sonatine726/MizuniGoal_PowerController_Docs/2026-09-14.md

ホフマンさん、マーロンさん
会議で話題に挙がった「電源On/Offを示すLEDの電圧と配置」について確認しました。

現在の基板でスイッチに流れる電流が少ないことなどから、スイッチのコネクタに「LED付きスイッチ」を付ける配置は適さないことがわかりました。ですので「LED付きスイッチ」を使いたい場合は基板設計を見直しますが、今回はスイッチを「緊急停止押しボタンスイッチ」に変更するということでしたので、全体最適の点では添付図の配置でLEDを付けてもらうほうが優れそうです。

Pros:
- LED選択の自由度が増す(LED専用の抵抗で調整できるため、基本的にどのようなLEDでも使える)
- 配線の自由度が増す（スイッチ配線とLED配線が別になるため、それぞれ最適化できる）
Cons:
- LED付きスイッチをどうしても使いたい場合は、この案は採用できない

ご検討ください。スイッチが二つある（緊急停止押しボタンスイッチ＋LED付きスイッチ）とわかりにくいので、私が誤解していて、元々LED付きスイッチでは無くLEDを使うという話かもしれません。そうでは無く、どうしてもLED付きスイッチを使いたい場合は、基板設計を見直しますので言ってください。

※いずれの案でも、LEDに掛かる電圧は「バッテリーと同様（約21.0V 〜 29.4V）」になります。
※出力線を分岐させてLEDを付けることは、XT60コネクタであれば分岐コネクタが市販されていますので容易と予想しています。ただ困難な場合は、基板上にもう一つLED用コネクタを追加しても良いかもしれません。そのような基板改良が望ましい場合も言ってください。

[English]
Hoffman-san, Marlon-san

I have looked into the matter raised during the meeting regarding the voltage and placement of the power status LED.

Given factors such as the low current flowing through the switch on the current PCB, using a "switch with an integrated LED" connected to the switch port is not ideal. While we could revise the PCB design if an integrated LED switch were required, the plan is to switch to an "emergency stop pushbutton." Therefore, from an overall optimization standpoint, it seems better to install the LED using the layout shown in the attached diagram.

Pros:
- Greater flexibility in LED selection (since a dedicated resistor can be used, virtually any LED is compatible).
- Greater flexibility in wiring (switch wiring and LED wiring are separate, allowing for individual optimization).
Cons:
- This approach cannot be used if an integrated LED switch is strictly required.

Please consider this option. It can be confusing to have two switches (an emergency stop pushbutton *and* a switch with an integrated LED); I may have misunderstood the situation, and the original plan might have been to use a separate LED rather than an integrated LED switch. If that is not the case and you absolutely require a switch with an integrated LED, please let me know so we can revise the PCB design.

*Note: In either scenario, the voltage applied to the LED will be the same as the battery voltage (approx. 21.0V to 29.4V).
*Note: Regarding the LED connection, branching the output line should be easy since splitter connectors for XT60s are commercially available. However, if this proves difficult, we could add a dedicated LED connector to the PCB. Please let me know if such a PCB modification is preferred.
