sonatine726/MizuniGoal_PowerController_Docs/Harness.md

# ツイストペアケーブルの長さ

40cmケーブルで作って32cmのツイストペアケーブル ができた

# ケーブル候補

https://www.marutsu.co.jp/pc/i/1349511/

https://akizukidenshi.com/catalog/g/g106756/

https://akizukidenshi.com/catalog/g/g118293/

https://www.monotaro.com/p/3331/9363/

# 前方ケーブル

5V&GND AWG24 20cm ツイストペア
Current&Voltage AWG 26 リボンケーブル  16cm
