sonatine726/MizuniGoal_PowerController_Docs/2026-09-15.md

会議で話が挙がった「運搬中のミズニゴールの揺れを計測する方法」について調べました。
まずは「①Pixhawkの加速度センサーの値から計測」を試してみて、こちらがうまくいかなかったり精度が十分でない場合、②振動センサーを追加して計測」を試してみるのが良さそうでした。

①が実際にできそうか、私の持っているPixhawkを使って実験してみますね。

[運搬中のミズニゴールの揺れを計測する方法]

①Pixhawkの加速度センサーの値から計測
DISARM状態でもセンサーログを残すようにArdupilotの設定を変更することで、可能なようです。設定はこれを含め、次のような変更が必要になりそうです。
- DISARM状態でもセンサーログを残す(LOG_DISARMED を 1)
- IMUの生ログを残す(INS_LOG_BAT_MASK=0、LOG_BITMASK の bit 19（raw IMU）=1)
	- ※生ログはデータ量が多くなります。精度を落としてもログを削減したい場合は、IMU バッチサンプラ（INS_LOG_BAT_OPT=4 (1kHz サンプリング)、INS_LOG_BAT_MASK=1(1つ目の IMU からデータ収集）も使えるようです。

※この方法の欠点として、「Pixhawk6C mini は基板内に防振機構を持っているため、揺れはシャーシよりも低い値が計測される」があるようです。ただ今回の揺れは軽トラの荷台ということで大きいはずですし、改善度合いを測るといった相対的な計測には問題無いですので、影響は小さいかもしれません。

②振動センサーを追加して計測

次のような振動センサーが市販されていました。

https://ymatic.co.jp/product/accstick6/
https://amzn.asia/d/0dULUasw
https://www.murata.com/ja-jp/products/sensor/vibration

ただ多くが加速度の変化から振動を測る方式でしたので、やっていることは①と同じになりそうです。まずは①を実施、うまくいかなかったり十分な精度が出ない場合にこちらの②を検討する進め方で良さそうです。

※「計測した振動と、それによってミズニゴールが受ける衝撃力が比例しないかも」という話も会議で挙がっていました。これについては正確にはまだわかりませんが、運動方程式の「F(力) = m(質量)xa(加速度)」の関係を考慮すると、①や②で得られる加速度のデータを使えば、衝撃力も推定できるかもしれません。これを直接測る場合は、ミズニゴールと軽トラ台車の接点に衝撃センサーを設置する形になるかもしれませんが、精度は不明で、また横方向の力は検知できません。
ーーーーー

[English]
I looked into the methods discussed at the meeting for measuring the vibration of the "Mizunigor" unit during transport.
It seems best to first try "① Measuring using the Pixhawk's accelerometer data," and then—if that proves unsuccessful or lacks sufficient accuracy—proceed to "② Measuring by adding a vibration sensor."

I will conduct an experiment using the Pixhawk I have on hand to see if method ① is feasible.

[Methods for measuring Mizunigor vibration during transport]

① Measuring using the Pixhawk's accelerometer data
This appears to be possible by modifying the ArduPilot settings to ensure sensor logs are recorded even when the system is disarmed. The following configuration changes, including that one, will likely be required:
- Record sensor logs even when disarmed (set LOG_DISARMED to 1)
- Record raw IMU logs (set INS_LOG_BAT_MASK=0; set bit 19 [raw IMU] of LOG_BITMASK to 1)
- *Note: Raw logs result in a large volume of data. If you want to reduce log size even at the cost of some precision, it appears you can use the IMU batch sampler (settings: `INS_LOG_BAT_OPT=4` for 1kHz sampling, `INS_LOG_BAT_MASK=1` to collect data from the first IMU).

*Note: A potential drawback of this method is that the Pixhawk 6C mini has an internal vibration-dampening mechanism, meaning the measured vibration levels will be lower than those experienced by the chassis itself. However, since the vibrations in this scenario—occurring on the bed of a light truck—are likely significant, and the goal is relative measurement (such as gauging the degree of improvement), the impact of this dampening may be negligible.*

② Measurement using an additional vibration sensor

Commercially available vibration sensors include the following:

https://ymatic.co.jp/product/accstick6/
https://amzn.asia/d/0dULUasw
https://www.murata.com/ja-jp/products/sensor/vibration

However, since most of these measure vibration based on changes in acceleration, the underlying principle is essentially the same as in method ①. It would be best to start with method ① and consider method ② only if the initial approach fails or does not yield sufficient precision.

*Note: A point raised during the meeting was that the measured vibration might not be directly proportional to the impact force experienced by the "Mizunigol." While the exact relationship remains unclear, considering the equation of motion "F (force) = m (mass) × a (acceleration)," it may be possible to estimate the impact force using the acceleration data obtained via methods ① or ②. Directly measuring the impact force would likely require installing an impact sensor at the contact point between the Mizunigol and the light truck bed; however, the accuracy of such a setup is unknown, and it would not detect lateral forces.*
ーーーーー

ピン数は５。次の役割となる
- COM
- NC
- NO
- LED+
- LED-

教えていただいたLED付き押ボタンスイッチと、現在の電源基板との関係を調査しました。

現在の電源基板でも使用できる。スイッチのピンと電源基板との接続は次の図の通り。
対象スイッチはAliexpressのページに48V対応と出ているため、追加の抵抗は不要で、配線接続だけで動くと思われる。

次バージョンの電源基板での改良

上記のように現基板でも使えるが、スイッチの4ピンの配線を異なる２つのコネクタに繋ぐ必要があり、配線が複雑化したり製造性が悪くなったりする。この点は次の図のようにJ4コネクタを2pinから4pinに変更することで、スイッチの4ピンを全てJ4コネクタに繋げるようになり、改善する。次バージョンの電源基板でこの改良を行う。
