sonatine726/MizuniGoal_PowerController_Docs/Memo.md

x:-23.15
y:40.2

x:-22.69
y:29:66

39
43

86

1
1

-0.3

0.9
0.3

0.2
-1

C15、C16は調整用でDNP。C15を使う場合は(C0G/100V)のコンデンサが必要

# 部品

22nF / 100V / C0G / 0603（C9）
LCSCに無し。1206/1210ならある

637-ES2C
LCSCに無し。代替品は

# はんだ付け

## Sn63Pb37
[https://mou.sr/4yajA03](https://mou.sr/4yajA03)

[https://mou.sr/3Uo14CN](https://mou.sr/3Uo14CN)

[https://mou.sr/4wZxC3D](https://mou.sr/4wZxC3D)

[https://www.hozan.co.jp/corp/g/g3728/](https://www.hozan.co.jp/corp/g/g3728/)

[https://www.goot.jp/products/detail/cp_15y](https://www.goot.jp/products/detail/cp_15y)

クリームはんだ：Sn63Pb37、Type 3 、無洗浄、100g 以下 → [https://mou.sr/4yajA03](https://mou.sr/4yajA03)

ワイヤーはんだ：Sn63Pb37、0.3mm（IC3 用） →

ワイヤーはんだ：Sn63Pb37、0.8〜1.0mm（コネクタ用） フラックス：ロジン系ペンまたはジェル はんだ吸取線：1.5〜2mm 幅

## SAC305
https://www.ifixit.com/products/lead-free-solder-paste-amtech-lf4300-sac305-t3-88-5

クリームはんだ：SAC305、Type 3、無洗浄、シリンジ 10〜35g
https://ja.aliexpress.com/item/1005009757132400.html
https://ja.aliexpress.com/item/1005013051346248.html

https://www.monotaro.com/p/0439/8216/

ワイヤーはんだ：SAC305、0.3mm（IC3 用）
https://ja.aliexpress.com/item/1005010509165339.html
https://www.monotaro.com/p/3512/1746/

ワイヤーはんだ：SAC305、0.8〜1.0mm（コネクタ用）
https://ja.aliexpress.com/item/1005012785466170.html
https://www.monotaro.com/p/3512/1764/

フラックス：ロジン系ジェルまたはペン（多めに）
[https://www.hozan.co.jp/corp/g/g3728/](https://www.hozan.co.jp/corp/g/g3728/)

はんだ吸取線：1.5〜2mm 幅
[https://www.goot.jp/products/detail/cp_15y](https://www.goot.jp/products/detail/cp_15y)

# JLCPCB　PCBA料金

2 19587

3 20409

4 21263

5 22127 (基板10枚 22,759)

10(36,748)

30(94,273)

# LED

18mA
