sonatine726/MizuniGoal_PowerController_Docs/MizuniGoal Power Controller v2.2.1 保護機能仕様.docx

# MizuniGoal Power Controller v2.2.1 保護機能仕様

Oct 21, 2026 · @久保田隆司

v2.2.1 の保護は 7 系統。しきい値のばらつきはすべて LM5060 自身のしきい値公差が支配しており、分圧抵抗（±1%）の寄与はその 1/6 程度にとどまる。UVLO 立ち上がりは設計 19.5V に対し 17.1〜21.9V、OVP 遮断は設計 34.0V に対し 31.1〜37.0V、OCP（VDS フォルト）は設計 50A 級に対し 34〜102A に散る。精度を要する保護は v2.2.1 には無い。

## 一覧

主保護は 7 系統。設計値は全部品が typ の場合、範囲はデータシートの min/max と抵抗 ±1%・コンデンサ ±10% を組み合わせた最悪値。

保護 | 検出対象 | 設計値（typ） | 最悪範囲 | 復帰 | しきい値を決めているもの
UVLO 遮断 | VBUS | 19.5 V で ON<br>17.4 V で OFF | 17.1〜21.9 V<br>14.5〜20.5 V | 自動 | R2 200k / R3 5.76k / R4 13.3k → IC3.4
OVP 遮断 | VBUS | 34.0 V で OFF | 31.1〜37.0 V | 自動<br>30.1 V（27.3〜33.0） | 同じ分圧の下側タップ → IC3.3
OCP（VDS フォルト） | Q3 の Vds | 152 mV<br>約 50 A を 87 ms | 117〜184 mV<br>34〜102 A を 66〜124 ms | ラッチ<br>EN トグルで解除 | R1 10kΩ・R7 1kΩ・C6+C16・Q3 の Rds(on)
起動タイムアウト | 起動時間 | 160 ms | 123〜264 ms | ラッチ | C6 0.33µF + C16 0.15µF・I_TIMERL
TH1 サーマル遮断 | TH1 温度 | 選別後 94.3〜109.9 ℃<br>（VBUS 29.4 V） | 未選別 74.6〜124.4 ℃ | 自動<br>温度ヒステリシス約 6 ℃ | R9 10k + R5 3.0k / R6 100k ∥ TH1 → IC3.5
ブレーキチョッパ | Vout | 32.2 V で導通<br>30.8 V で復帰 | 31.5〜33.0 V<br>30.0〜31.7 V | 自動 | R17 118k / R18 10k / R14 1M・U1 TL431B
非常停止 | J4 接点（NC） | 押下で即 OFF | — | 手動（ひねり解除） | J4 が EN 経路を直接開く

補助保護（ヒューズ、PPTC、TVS、ゲートクランプ、逆流阻止）は後述。ラッチするのは OCP と起動タイムアウトの 2 つだけで、どちらも LM5060 の TIMER ピンが 2.0 V に達したときに発生する。

## UVLO（低電圧遮断）

設計 19.5 V で ON、17.4 V で OFF。最悪で 17.1〜21.9 V に散り、その幅 4.8 V のうち 4.1 V が LM5060 自身のしきい値公差による。

### 回路

VBUS → R2 200 kΩ → IC3.4（UVLO） → R3 5.76 kΩ → IC3.3（OVP） → R4 13.3 kΩ → GND。合計 219.06 kΩ、VBUS 29.4 V で 134 µA を消費する（待機電流の最大寄与）。

TI の 3 本分圧（Option A）だが、タップの割り付けがデータシートの図と逆で、UVLO が上側・OVP が下側になっている。UVLO は 19.5 V で 1.6 V（比 0.082）、OVP は 34.0 V で 2.0 V（比 0.059）を要求するためで、この配置でなければ両方を満たせない。

### LM5060 側の規格

記号 | 項目 | min | typ | max
UVLO_TH | しきい値（立ち上がり） | 1.45 V | 1.60 V | 1.75 V
UVLO_HYS | しきい値ヒステリシス | 120 mV | 180 mV | 230 mV
UVLO_BIAS | ピンの引き込み電流 | 3.8 µA | 5.5 µA | 7.2 µA

UVLO_BIAS はこの回路では無視できない。R2 200 kΩ に 5.5 µA が流れると 1.1 V のオフセットになり、これが間違うと設計値 19.5 V が 18.4 V になる。

### 算出式

V_{BUS(UVLO)} = V_{th}\cdot\frac{R_2+R_3+R_4}{R_3+R_4} + R_2\,I_{UVLO\_BIAS} = 11.493\,V_{th} + 1.10\ \mathrm{V}

立ち下がりは V_th を（V_th − UVLO_HYS）に置き換える。typ で 1.60 V → 19.49 V、1.42 V → 17.42 V、ヒステリシス 2.07 V。

### ばらつきの内訳

要因 | 立ち上がりの範囲 | 幅
LM5060 単独（抵抗は nominal） | 17.43〜21.55 V | 4.12 V
抵抗 ±1% 単独（IC は typ） | 19.15〜19.84 V | 0.69 V
全部合わせ | 17.12〜21.94 V | 4.82 V

抵抗を 0.1% にしても幅は 4.8 → 4.2 V にしかならない。このしきい値を絞りたい場合、抵抗の格上げは意味がない。

### 7S パックとしての意味

| VBUS | 1 セルあたり
立ち上がり typ | 19.5 V | 2.78 V
立ち上がり最悪（高） | 21.9 V | 3.13 V
立ち下がり typ | 17.4 V | 2.49 V
立ち下がり最悪（低） | 14.5 V | 2.07 V

両端とも実用上の問題になる。立ち上がり 21.9 V の個体は 3.13 V/セル で起動できず、容量を使い残す。立ち下がり 14.5 V の個体は 2.07 V/セル まで引き出してしまう。走行中のサグを含む値なので開路電圧はこれより高いが、UVLO をパック保護として頼れる水準ではない。BMS 側でのカットオフが必要。

### 補足

- UVLO は EN が High のときだけ有効。非常停止投入中は UVLO の状態に関係なく出力が出ない。
- UVLO 割れでの遮断はラッチしない。GATE を 2.2 mA で引き抜いて OFF にし、TIMER を放電して自動リトライする。2026-10-08 の阶段状波形（電源の電流制限 0.3 A）はこのリトライが繰り返されたもので、保護動作としては正しい。

## OVP（過電圧遮断）

設計 34.0 V で遮断、30.1 V で自動復帰。最悪で 31.1〜37.0 V。下端 31.1 V はブレーキチョッパの動作点（最大 33.0 V）を下回るため、後述の重なりが生じる。

### 算出式

UVLO と同じ分圧の下側タップ（IC3.3）。OVP ピン自身のバイアス電流は 0 µA typ（0.5 µA max）で無視できるが、UVLO ピンの引き込み電流は OVP のしきい値も動かす。

V_{BUS(OVP)} = V_{th}\cdot\frac{R_2+R_3+R_4}{R_4} + R_2\,I_{UVLO\_BIAS} = 16.471\,V_{th} + 1.10\ \mathrm{V}

記号 | 項目 | min | typ | max
OVP_TH | しきい値（立ち上がり） | 1.88 V | 2.00 V | 2.12 V
OVP_HYS | ヒステリシス | — | 240 mV | —
OVP_BIAS | ピンバイアス電流 | — | 0 µA | 0.5 µA
OVP_DEL | しきい値超えから GATE Low まで | — | 9.6 µs | —

### しきい値の範囲

要因 | 遮断点 | 幅
LM5060 単独 | 31.72〜36.36 V | 4.64 V
抵抗 ±1% 単独 | 33.42〜34.68 V | 1.26 V
全部合わせ | 31.14〜37.03 V | 5.89 V
復帰点（OVP_HYS typ 前提） | 27.26〜33.01 V | —

ヒステリシスは typ 3.95 V、3.88〜4.03 V。OVP_HYS に min/max 規定がないため、復帰点の範囲は保証値でない。

### 動作

- ラッチしない。GATE を 80 mA で引き抜いて Q3 を OFF にし、しきい値を下回れば自動で再起動する。
- OVP 中は TIMER が放電されるので、復帰後の起動はタイムアウトの全時間を使える。
- GATE 引き抜きは 9.6 µs で始まるが、C9 ∥ C15 = 44 nF が GATE−GND 間にあるため実際の Q3 オフまでは 44 nF × 12 V ÷ 80 mA ≈ 6.6 µs が加わる。合計 20 µs 弱。

### TVS との関係

Vout の D7（SMCJ33A）はオフ電圧 33.0 V、ブレークダウン 36.70〜40.60 V（@1 mA）。OVP の上端 37.0 V は D7 のブレークダウン下限とほぼ重なる。OVP が高側コーナの個体では、OVP より先に D7 が導通し始める可能性がある。D7 は 10/1000 µs サージ用の 1500 W 品であって DC 過電圧に耐えるものでないため、持続的な 37 V 印加は避ける。

## OCP（過電流：LM5060 の VDS フォルト）

v2.2.1 に電流検出は入っていない（それは v4.0.0 予定の追加機能）。ここで言う OCP は、LM5060 が Q3 の Vds を見て電流を推定する VDS フォルトのことで、しきい値は Q3 の Rds(on) に乗って決まる。精度は期待できない。

### 回路

- R1 10 kΩ：VBUS → IC3.1（SENSE）。SENSE ピンの 16 µA 定電流シンクがこの抵抗に流れ、しきい値電圧を作る。
- R7 1 kΩ：IC3.9（OUT） → Vout。TI が言う R_O。
- コンパレータは V(SENSE) と V(OUT) を比較し、SENSE が OUT を上回ったときフォルトとする。

V_{DSTH} = R_S I_{SENSE} - R_O I_{OUT\_EN} - V_{OFFSET}

記号 | 項目 | min | typ | max
I_SENSE | SENSE ピン定電流 | 13.6 µA | 16 µA | 18.0 µA
I_OUT_EN | OUT ピンバイアス電流 | 5.0 µA | 8 µA | 11.0 µA
V_OFFSET | コンパレータオフセット | −7.0 mV | 0 mV | +7.0 mV
I_TIMERH | VDS フォルト時の TIMER 充電電流 | 8.5 µA | 11 µA | 13.0 µA
V_TMRH | TIMER ラッチしきい値 | — | 2.0 V | —

typ で 10 kΩ × 16 µA − 1 kΩ × 8 µA = 152 mV。最悪で 117〜184 mV。

### 電流換算

Q3 は CSD18540Q5B（Rds(on) typ 1.8 mΩ / max 2.2 mΩ @25 ℃、Vgs 10 V）。接合部が熱いと Rds(on) が上がるので、同じ基板でも温度でしきい値が動く。

Q3 の Rds(on) | VDSTH 117 mV | 152 mV（typ） | 184 mV
1.8 mΩ（typ @25 ℃） | 65 A | 84 A | 102 A
2.2 mΩ（max @25 ℃） | 53 A | 69 A | 84 A
3.0 mΩ（max @約 100 ℃） | 39 A | 51 A | 61 A
3.4 mΩ（max @125 ℃） | 34 A | 45 A | 54 A

設計仕様書は typ ・約 100 ℃ の 51 A（記載は 53 A）を根拠値としている。実際のばらつきは 34〜102 A。

### 遅延

TIMER を I_TIMERH で 2.0 V まで充電する時間。C = C6 0.33 µF + C16 0.15 µF = 0.48 µF。

| C | I | 遅延
typ | 0.48 µF | 11 µA | 87 ms
最速 | 0.432 µF | 13 µA | 66 ms
最遅 | 0.528 µF | 8.5 µA | 124 ms

### ラッチと復帰

遅延満了で GATE を 80 mA で引き抜き、ラッチオフする。復帰には EN・UVLO・VIN のいずれかを Low → High にする必要がある。この基板では非常停止ボタンの押下＋解除（J4 が EN 経路を開く）が正規のリセット手段。

IC3.8（nPGD）は VDS コンパレータの出力そのもので、LED1 に繋がっている。つまり LED1 は「出力 ON」でなく「 VDS が正常」を示す。ラッチする前の過電流中ですでに消灯するので、試験時の観察点になる。

### R7 を入れている理由とその代償

TI は R_O を「特段の場合」用としている——高入力電圧で負荷容量が大きい場合と、逆接続保護。本基板は MDDS30 を含めて 3628 µF あるので前者に当たり、R7 はフォルト時に負荷容量が OUT ピン経由で放電する電流を制限している。代償はしきい値の 8 mV 低下と、I_OUT_EN のばらつき（5〜11 µA）がそのまましきい値誤差に乗ること。

### 硬短絡は OCP では守れない

これは記録しておく価値がある。Vout が GND に硬短絡したとき、Q3 の Vds は 152 mV ではなくパック全電圧（最大 29.4 V）になる。CSD18540Q5B の SOA は 29 V・100 ms で許容 6.5 A（Tc 25 ℃、RθJC 0.8 K/W）。つまり VDS フォルトの 66〜124 ms は硬短絡に対して桁違いで遅い。

硬短絡時に実際に働くのは、

1. F1 / F2（各 30 A、公称溶断 I²t 81 A²·s）。片側 300 A なら 0.9 ms で开く。
2. R51 ＋ D12（v2.2.1 で追加）。上流コンデンサの電荷でゲート酸化膜が突破する経路を止める。

2026-10-08 に 1 号機の Q3 が壊れたのはこの経路で、OCP は何もしなかった。

## TH1 サーマル遮断

7 つの中で最もばらつく。データシート上、遮断温度は決まっていない。LM5060 の EN は比較器でなくロジック入力で、規定されているのは「0.80 V 以下なら確実に Low」「2.00 V 以上なら確実に High」だけ。実際のしきい値はその間の 1 点で、個体ごとに違う。これが v3.0.0 を必要にした直接の理由。

### 回路

VBUS → R9 10 kΩ → J4.3 → 非常停止接点（NC） → J4.4 → R5 3.0 kΩ → EN（IC3.5）。EN から GND に D8・R6 100 kΩ・TH1 が並列。

TH1 = NCP21XV103J03RA（10 kΩ @25 ℃、B = 3944）。R_top = R9 + R5 = 13.0 kΩ、R_b = R6 ∥ TH1。

V_{EN} = \frac{V_{BUS}/R_{top} - I_{ENBIAS}}{1/R_{top} + 1/R_b},\qquad I_{ENBIAS} = 6\ \mathrm{\mu A}

### EN しきい値と遮断点（R5 = 3.0 kΩ）

EN しきい値 | 意味 | TH1 遮断点<br>19.5 V | 24.0 V | 29.4 V | Q1 推定 Tj<br>@29.4 V
0.80 V | ENTHL・最も遅く遮断 | 108 ℃ | 116.1 ℃ | 124.4 ℃ | 153 ℃
1.15 V | 選別窓の下限 | 94.3 ℃ | 102.1 ℃ | 109.9 ℃ | 139 ℃
1.30 V | 1 号機実測 | 89.8 ℃ | 97.5 ℃ | 105.1 ℃ | 134 ℃
1.50 V | 選別窓の上限 | 84.7 ℃ | 92.2 ℃ | 99.7 ℃ | 129 ℃
2.00 V | ENTHH・最も早く遮断 | 74.6 ℃ | 81.9 ℃ | 89.2 ℃ | 118 ℃

- 選別しない場合の範囲：74.6〜124.4 ℃（幅 50 ℃）。下端 74.6 ℃ は筐体内 65 ℃ に対して ＋9.6 ℃ しかなく、走行時の TH1 上昇が 10 ℃ を超えると起動できない。上端 124.4 ℃ は Q1 の Tj が 153 ℃ となり Tjmax 150 ℃ を超える。
- 選別後（1.15〜1.50 V）の範囲：84.7〜109.9 ℃。両端とも制約が接していて、これ以上窓は広げられない。
- 温度ヒステリシスは約 6 ℃（EN の ENHYS 200 mV typ 由来）。v2.0.0 / v2.1.0 で「遮断 100.2 ℃ / 復帰 68.9 ℃」としていたのは誤りで、あの 2 値は個体ばらつきの両端だった。

### 未確定の前提 2 つ

1. Q1 − TH1 オフセット ＋29 ℃ は仮定値。試験 3-4 / 3-5 で ＋40 ℃ 程度と判明した場合、下限 1.15 V でも 29.4 V で Q1 が 150 ℃ に達し、上下限が交差して選別窓が成立しなくなる。
2. LM5060 の EN しきい値の温度ドリフトにデータシート規定がない。25 ℃ で選別した値が筐体内 65 ℃ でどう動くかは保証できない。

### D8 のクランプ値は試験表で矛盾している

D8（BZT52C3V9）の Vz は 5 mA でのみ規定（3.7 / 3.9 / 4.1 V）。低電流側は Z_ZK 600 Ω max @1 mA が最低の保証点で、それ以下の Vz は Diodes / Vishay / Nexperia のいずれにも規定がない。

この回路での D8 電流は、VBUS 29.4 V・TH1 25 ℃ で約 1.5 mA。TH1 が温まるほどノードが引き下げられ、クランプを難れる直前ではほぼゼロになる。つまり クランプ値は温度とともにスライドする。

試験記録シートの 1-6 は「3.9 V」、4-6 は「3.2 V 前後」と書いている。これは矛盾ではなく、規定のない量を 2 つの条件で書いた結果。両方を「従来値 3.2〜4.0 V（D8 電流 0.1〜1.5 mA）」に統一することを推奨する。また選別手順での注入電圧上限 3 V は、この下端 3.2 V に対して余裕が 0.2 V しかないので守ること。

なお、D8 がクランプに張り付いている間（VBUS 29.4 V で TH1 約 66 ℃ 未満、19.5 V で約 52 ℃ 未満）、EN 電圧は温度情報を持たない。走行時の TH1 上昇を EN 電圧から読むことはできず、TH1 の抵抗を直接測る必要がある。

## ブレーキチョッパ（回生過電圧のクランプ）

設計 32.2 V で導通、30.8 V で復帰。これだけが LM5060 を介さず、アナログの比較器（U2 LM397）と TL431B の基準で決まる。その分だけ ばらつきが数分の 1 に小さい。

### 回路

Vout → R17 118 kΩ → Chopper_Sense（U2.1） → R18 10 kΩ → GND。R14 1 MΩ が Chopper_Sense と Q5 のコレクタを結んでヒステリシスを作る。基準は U1 TL431B から 2.495 V。

チョッパ OFF 時の分圧比は R18 ∥ R14 の影響で 0.07741（R18 単独なら 0.07813）。

| 設計値 | 最悪範囲
導通開始 | 32.20 V | 31.45〜32.97 V
復帰 | 30.83 V | 30.01〜31.66 V
ヒステリシス | 1.37 V | 1.28〜1.48 V

範囲は TL431B の Vref ±0.5%（2.483〜2.507 V @25 ℃）と抵抗 ±1% の組み合わせ。TL431BI は −40〜85 ℃ で Vref の変動が最大 34 mV 加わるため、筐体内 65 ℃ では上記に ±0.2 V 程度を足す。

### R11 の熱が真の制約

項目 | 値
R11 | TPAN0263F200RK9、200 Ω、TO-263
チョッパ電流（32.2 V） | 0.161 A（0.159〜0.163 A）
消費電力 | 5.18 W（5.13〜5.24 W）
実効熱抵抗（v2.1.1 実測） | 約 18 ℃/W
平衡温度（筐体内 65 ℃） | 約 158 ℃
R11 最高使用温度 | 150 ℃

チョッパは連続導通できない。試験時は 120 ℃ を上限に打ち切ること。v2.2.1 には R11 の熱を監視する手段がない（TH2 とソフトでの積算は v3.0.0 で追加）。これが v2.2.1 の保護の欠落で最も大きい。

### fail-off 構成で守れる範囲

v2.1.1 以降は Q5（MMBT3906）の反転段で fail-off。LM397 の故障、12 V レール喪失、Q5 のオープン故障、R21 の断線のいずれでも Q4 は OFF に倒れる。

ただし VREF の崩壊と、Q5 / Q4 の短絡故障は fail-on のまま。fail-on した場合は R11 に 5.2 W が連続で入るので、数分で 150 ℃ を越える。

### 12 V レール（チョッパの電源）

Vout → R10 3.3 kΩ → D9 BZT52C12。D9 の Vz は 11.4 / 12 / 12.7 V（@5 mA）。

Vout | R10 で流せる電流 | 負荷（R20 1.40 mA ＋ LM397 約 0.3 mA） | D9 の分担
19.5 V（放電末期） | 2.27 mA | 約 1.7 mA | 約 0.6 mA
29.4 V（満充電） | 5.27 mA | 約 1.7 mA | 約 3.6 mA
32.2 V（チョッパ動作点） | 6.12 mA | 約 1.7 mA | 約 4.4 mA

放電末期では D9 の電流が 0.6 mA しかなく、I_ZT 5 mA を大きく下回る。この領域の Vz は規定外（Z_ZK 150 Ω max @1 mA が最低の保証点）で、レールは 12 V を下回る。試験項目 5-1 の「12 V ±5%」は満充電近傍でしか成立しないので、19.5 V と 29.4 V の両方で測ることを推奨する。TL431 の消費電流下限（I_min 0.7 mA max）はどちらでも満たす。

## 補助保護

### F1 / F2 — パックごとのヒューズ

Littelfuse 0456030.ER（Nano2 SMF、30 A）を各パックに 1 本。硬短絡時に実際に基板を守っているのはこれ。

項目 | 値
定格電流 | 30 A（連続使用は 25% ディレートして 22.5 A）
最大電圧 | 125 V
遮断容量 | 1000 A @32 VDC、500 A @72 VDC
冷時抵抗 | 1.32 mΩ
公称溶断 I²t | 81 A²·s
電圧降下（定格時） | 69.9 mV
開くまでの時間 | 100% で 4 時間以上、200% で 60 秒以内

2 パック並列で連続 45 A、瞬時 60 A まで。ローバーのストール試験が 25 A なので余裕はある。片側 300 A なら約 0.9 ms、150 A なら約 3.6 ms で開く（I²t からの概算）。

注意：81 A²·s の注釈が 2021 年版では 1 ms 基準、2009 年版では 10 ms 基準になっている。上の ms オーダーの概算は参考値として扱い、短絡保護の設計根拠にする場合は Littelfuse に確認すること。

### F3 — 外部 LED 線の PPTC

1206L010/60。Vout から外部スイッチの LED へ行く線だけを守る。パック電流の経路ではない。

項目 | 値
I_hold @20 ℃ | 0.10 A
I_trip | 0.25 A
V_max / I_max | 60 Vdc / 10 A
初期抵抗 | 1.50 Ω（min）〜 復帰後 10.00 Ω（R_1max）
トリップ時間 | 0.50 A で 1.50 秒以内
I_hold @60 ℃ / @70 ℃ | 0.065 A / 0.056 A

筐体内 65 ℃ はデータシートに点がなく、内挿で約 0.060 A。試験 8-4 の判定「40 mA 以下」に対し余裕は約 1.5 倍で妥当。

試験 8-7 の判定を直すべき。現状「1 秒以内にトリップ」としているが、データシートの保証は「0.50 A で 1.50 秒以内」だけ。故障電流を書かずに 1 秒を要求するのは保証範囲外。0.50 A 印加で 1.5 秒以内 に改めることを推奨する。

F3 には LCSC 品番が入っていない（回路図の値は 1206L010_60 のみ）。250 枚生産では手配経路を決める必要がある。データシートの発注コードは /60WR（テープリール）で、/60NR は載っていない。

## しきい値帯の重なり

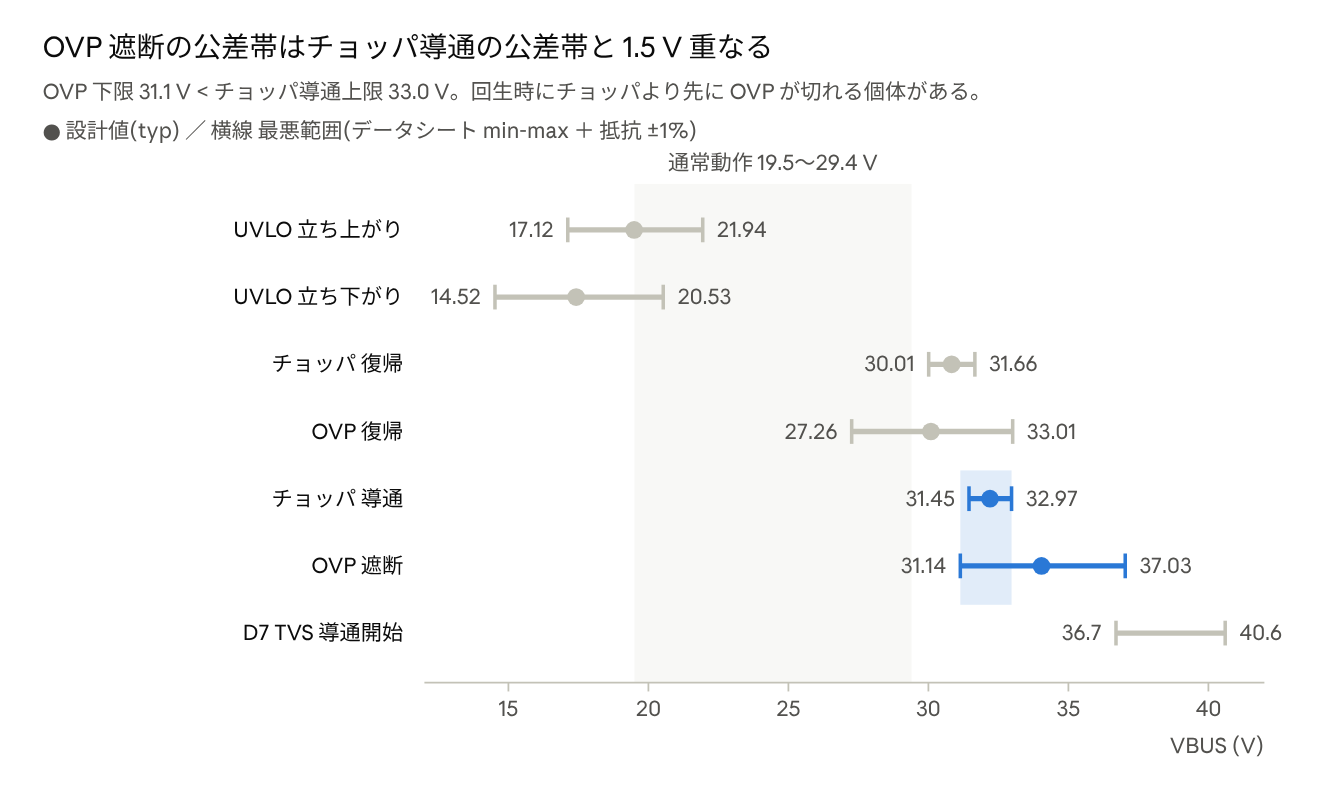
[picture p1: figure]
LM5060 / TL431B / SMCJ33A データシートの min-max と回路図の抵抗値 ±1% から算出

LM5060 / TL431B / SMCJ33A データシートの min-max と回路図の抵抗値 ±1% から算出

通常動作帯（19.5〜29.4 V）の上側で 3 つの保護が狭い範囲に密集している。OVP 遮断は設計 34.0 V だが下限が 31.14 V まで落ちるため、チョッパ導通の上限 32.97 V と 1.5 V 重なる。この重なりに当たった個体では、回生電圧が上がったときチョッパが導通する前に OVP が Q3 を切る。

## 設計上の留意点

### ばらつきの支配要因は IC であって抵抗ではない

保護 | 基準としているもの | IC の寄与 | 抵抗の寄与
UVLO | LM5060 内部しきい値（1.45〜1.75 V） | 4.12 V | 0.69 V
OVP | LM5060 内部しきい値（1.88〜2.12 V） | 4.64 V | 1.26 V
TH1 サーマル | LM5060 の EN（ロジック入力、しきい値未規定） | 50 ℃ 全部 | —
OCP | SENSE 電流 ＋ Q3 の Rds(on) | 67 mV ＋ Rds(on) 1.9 倍 | わずか
チョッパ | TL431B の 2.495 V ±0.5% | 約 0.3 V | 約 1.2 V

この表がすべてを説明する。しきい値を LM5060 自身に委ねている保護はすべて広く散り、本物の電圧基準を持っているチョッパだけが揃っている。抵抗を 0.1% に格上げしても誤差はほとんど減らない。

v3.0.0 が TH1 サーマルをマイコンの ADC に移したのは、この構造を 1 つだけ回避したということ。

### v2.2.1 と v3.0.0 の差

保護 | v2.2.1 | v3.0.0
TH1 サーマル | 74.6〜124.4 ℃。全数選別が必須 | ファームの定数、±2 ℃。選別不要
R11 過熱 | 監視手段なし | TH2 ＋ ソフトでの ON 時間積算
EN フェイルセーフ | なし | Q6 で約 93 ms で自動遮断
起動タイムアウト余裕 | 1.31 倍 | 1.81 倍（C16 0.33 µF）
UVLO / OVP | LM5060。上記のばらつき | 変更なし。同じばらつき
OCP（VDS） | 34〜102 A | 変更なし
チョッパ動作点 | 31.5〜33.0 V | 変更なし

R2 / R3 / R4 とチョッパ一式は v2.3（v3.0.0）でも設計変更対象外。つまり 次の項の問題は v3.0.0 に移しても残る。

## 出典

### 基板側

- 回路図 Mizunigoal_PowerController.kicad_sch（2026-10-21 06:15 版 = v2.2.1）—— 抵抗値、ネット接続、IC3 のピン割り付けはこれから読み出した
- MizuniGoal_PowerController_v2_2_1_試験記録シート_rev1.xlsx
- MizuniGoal_PowerController_v2_3_設計仕様書.pdf（2026-10-08）

### データシート

- TI LM5060 — Electrical Characteristics (https://www.ti.com/document-viewer/LM5060/datasheet/electrical-characteristics-snvs628227)（UVLO / OVP / EN / TIMER / GATE / SENSE の全規格）
- TI LM5060 — UVLO and OVP (https://ti.com/document-viewer/LM5060/datasheet/uvlo-ovp-snvs6282023)
- TI LM5060 — Fault Timer (https://www.ti.com/document-viewer/LM5060/datasheet/fault-timer-snvs6282415)
- TI LM5060 — Overcurrent Fault (https://www.ti.com/document-viewer/LM5060/datasheet/overcurrent-fault-snvs6282432)
- TI LM5060 全文（SNVS628H） (https://www.mouser.com/datasheet/2/405/lm5060-444310.pdf)（ピン機能表、V_DSTH の式、R_O を入れたときの式 20）
- TI LM74610-Q1 — Specifications (https://www.ti.com/document-viewer/LM74610-Q1/datasheet/specifications)
- TI TL431 / TL431B（SLVS543M） (https://www.mouser.com/datasheet/2/149/tl431a-308671.pdf)
- Littelfuse SMCJ シリーズ TVS (https://www.mouser.com/datasheet/2/240/media-3320072.pdf)（SMCJ33A / SMCJ6.0A）
- Littelfuse SMAJ シリーズ TVS (https://www.mouser.com/datasheet/2/240/Littelfuse_TVS_Diode_SMAJ_Datasheet_pdf-540740.pdf)（SMAJ15A）
- Diodes Inc DS18004 — BZT52C シリーズ (https://www.mouser.com/datasheet/2/115/ds18004-1142534.pdf)（BZT52C3V9 / BZT52C12）
- Littelfuse 456 シリーズ Nano2 (https://www.mouser.com/datasheet/2/240/Littelfuse_Fuse_456_Datasheet_pdf-1372353.pdf)（0456030.ER）
- Littelfuse 1206L シリーズ PPTC (https://www.mouser.com/datasheet/2/240/Littelfuse_PTC_1206L_Datasheet_pdf-2956361.pdf)（1206L010/60）

### 計算の前提

- 抵抗は ±1%、セラミックコンデンサ（C6 / C16）は ±10% とした。
- 最悪範囲は全コーナーの組み合わせ。実際の歩留まりはこれより良い。
- ヒステリシスは同一基板内で抵抗値が共通なことを考慮して相関を取って計算した。
- Q3 の Rds(on) 温度係数は 100 ℃ で 1.37 倍、125 ℃ で 1.55 倍とした。

### D12 — Q3 ゲートクランプ（v2.2.1 で追加）

SMAJ15A を Q3 のゲート−ソース間に入れ、R51 100 Ω を LM5060 pin10 とゲートの間に直列に入れた。カソードがゲート側。

項目 | 値
オフ電圧 V_WM | 15.0 V
ブレークダウン V_BR @1 mA | 16.70〜18.50 V
クランプ電圧 V_C | 24.4 V @16.4 A
パルス耐量 | 400 W（10/1000 µs）
漏れ電流 @15 V | 1 µA max

通常動作の Vgs は 10〜14 V（typ 12 V、1 号機実測 11.8 V）。最悪でも 14 V で、V_BR 下限 16.70 V まで 2.7 V の余裕がある。

短絡時のクランプ電流は約 0.68 A、エネルギー約 12 µJ。0.68 A でのクランプ電圧は 16.7 ＋ (24.4 − 16.7) × 0.68/16.4 ≈ 17.0 V で、Q3 の Vgs 絶対最大 ±20 V に対し 3 V の余裕が残る。

R51 が欠けると D12 が C9 ∥ C15 = 44 nF を直接受け、D12 自身が焼損する。通電前確認 0-12 / 0-13 はそのための項目。

### TVS 群

部品 | 配置 | V_WM | V_BR @I_T | V_C @I_PP | 耐量
D3 / D5 | Battery1 / 2 の上側 | 33.0 V | 36.70〜40.60 V @1 mA | 53.3 V @28.2 A | 1500 W
D4 / D6 | 同じ経路の下側 | 6.0 V | 6.67〜7.37 V @10 mA | 10.3 V @145.7 A | 1500 W
D7 | Vout − GND | 33.0 V | 36.70〜40.60 V @1 mA | 53.3 V @28.2 A | 1500 W

D3 ＋ D4（および D5 ＋ D6）はアノード同士を繋いだ背中合わせ构成で、双方向クランプになっている（回路図で確認済み。D3.K → Battery1、D3.A → D4.A、D4.K → GND）。

向き | 導通開始 | 動作
正サージ | 約 37.7〜41.6 V | D3 がブレークダウン、D4 は順方向
パック逆接続 | 約 −7.7〜−8.4 V | D4 がブレークダウン、D3 は順方向

逆接続は復帰できる保護ではない。D4 が導通して F1 / F2 を開く消耗品動作で、D4 のエネルギー（約 3 J）は 10/1000 µs 定格を超えるため D4 も損失する可能性が高い。ただし逆接続時は Q1 / Q2 のボディダイオードが逆バイアスになるので VBUS 以降は守られる。交換が必要なのは F1 / F2 と D4 / D6 だけ。

### 逆流阻止（IC1 / IC2 ＋ Q1 / Q2）

LM74610QDGKRQ1 の理想ダイオード制御。充電状態の異なる 2 パックを並列に繋いでも、高い側から低い側へ流れ込まない。

記号 | 項目 | min | typ | max
T_Recovery | 逆電圧検出から FET オフまで | — | 2.2 µs | 5 µs
— | 検出条件（データシートの試験点） | — | V(A−K) = −20 mV | —
— | 起動に必要なボディダイオード電圧 | 0.48 V | — | —
I_Charge | チャージポンプ電流 @V(A−K) 0.55 V | 40 µA | 46 µA | —
I_Gate_up | ゲート引き上げ電流 @Vgs 2 V | 8.9 µA | 9.4 µA | —

逆流を止めるのに 5 µs かかる。T_Recovery の試験条件が Cgate = 4 nF で、CSD18540Q5B の Ciss は typ 3250 pF / max 4230 pF なので、この max 5 µs はそのまま使える。

重要：LM74610 は Q1 / Q2 のゲートをソース基準で駆動する。これが 2026-10-08 の出力短絡で Q1 / Q2 が無傕だった理由で、GND 基準でゲート容量を持っていた Q3 だけが壊れた。v2.2.1 の R51 / D12 はこの差を埋めるためのもの。

### 非常停止（J4）

J4 の接点は NC。ボタンを押すと EN 経路が開き、ソフトを介さずに直接 Q3 がオフになる。試験時にスイッチを繋がない場合は pin3 − pin4 を短絡して接点 ON を模擬すること。

OCP と起動タイムアウトのラッチを解く正規の手段でもある。

### OVP とチョッパの重なりは定数を振り直しても閉じない

OVP がチョッパより先に切れると、回生電力がパックに戻れなくなる。チョッパは Vout 側にあり Vout から電源を取っているので動作は続けるが、R11 の 5.2 W では回生電力を吸収できず、Vout は D7 のブレークダウン（36.7〜40.6 V）まで上がる。D7 は 10/1000 µs のサージ用で連続には耐えない。

これを定数で逃れられないことを確かめた。チョッパは 4 つの制約に挡まれている。

1. 満充電 29.4 V で誤動作しないこと → チョッパ下限 > 29.4 V
2. OVP より先に働くこと → チョッパ上限 < OVP 下限
3. OVP が D7 より先に働くこと → OVP 上限 < 36.7 V
4. OVP の帯幅は 5.89 V、チョッパの帯幅は 1.52 V（どちらも定数では縮められない）

③④ から OVP 下限 < 30.81 V、② からチョッパ上限 < 30.81 V、すなわちチョッパ下限 < 29.29 V。これは ① の 29.4 V を下回る。4 つを同時に満たす解はない。

構造を変えるなら選択肢は 3 つ。

案 | 内容 | 懸念
A | OVP を LM5060 から外し、マイコンの ADC またはチョッパと同じ TL431 基準の比較器で作る | v4.0.0 規模の変更
B | D7 を SMCJ36A / SMCJ40A に上げて ③ を緩め、OVP を上げる | MDDS30 の入力最大定格を超えないか要確認
C | 定数は変えず、全数選別で重なった個体を落とす | 歩留まりが落ちる。250 枚では現実的

250 枚を v2.2.1 で回すなら C が唯一の現実解。

### 推奨する全数選別（案 C）

試験 | 項目 | 推奨合格窓 | 理由
1-1 | UVLO 立ち上がり | ≤ 20.5 V | 放電末期に起動できること
1-3 | OVP 遮断 | ≥ 33.5 V | チョッパ上限より上
5-7 | チョッパ導通 | 31.5〜33.0 V | 設計どおり
新設 | 1-3 − 5-7 の差 | ≥ 1.0 V | 重なりの排除
9-2 | EN 立ち下がり | 1.15〜1.50 V | 既存のサーマル選別

全数で 5 項目のしきい値選別が必要になる。これ自体が、製造性の面で v2.2.1 を選ぶコストとして扱うべき数字。
