sonatine726/MizuniGoal_PowerController_Docs/copilot/copilot-conversations/agent__Memo_の空行の隙間は統一してください。@20260914_184448.md

---
epoch: 1789379088206
mode: agent
backendId: opencode
sessionId: "ses_f60b2e880ffeqkUrmfF67rJtaY"
agentLabel: "Memo.md の空行統一"
usage: '{"usedTokens":11960,"contextWindow":200000,"updatedAt":1789379143817}'
tags:
  - copilot-conversation
---

**user**: [[Memo]] の空行の隙間は統一してください。
[Timestamp: 2026/09/14 18:44:48]

**ai**: 空行の隙間が不揃いなので、全て統一します。統一しました。以下の変更を行いました：

- 冒頭の余分な空行を除去
- 重複していた空行（2〜3行の連続空行）を全て1行に統一
- ファイル末尾の余分な空行を除去
- URL行末の余分なスペースも整理

空区切りは全て **1行の空行** に統一されています。
[Timestamp: 2026/09/14 18:44:48]
