sonatine726/MizuniGoal_PowerController_Docs/書き込み治具_接点レイアウト.png

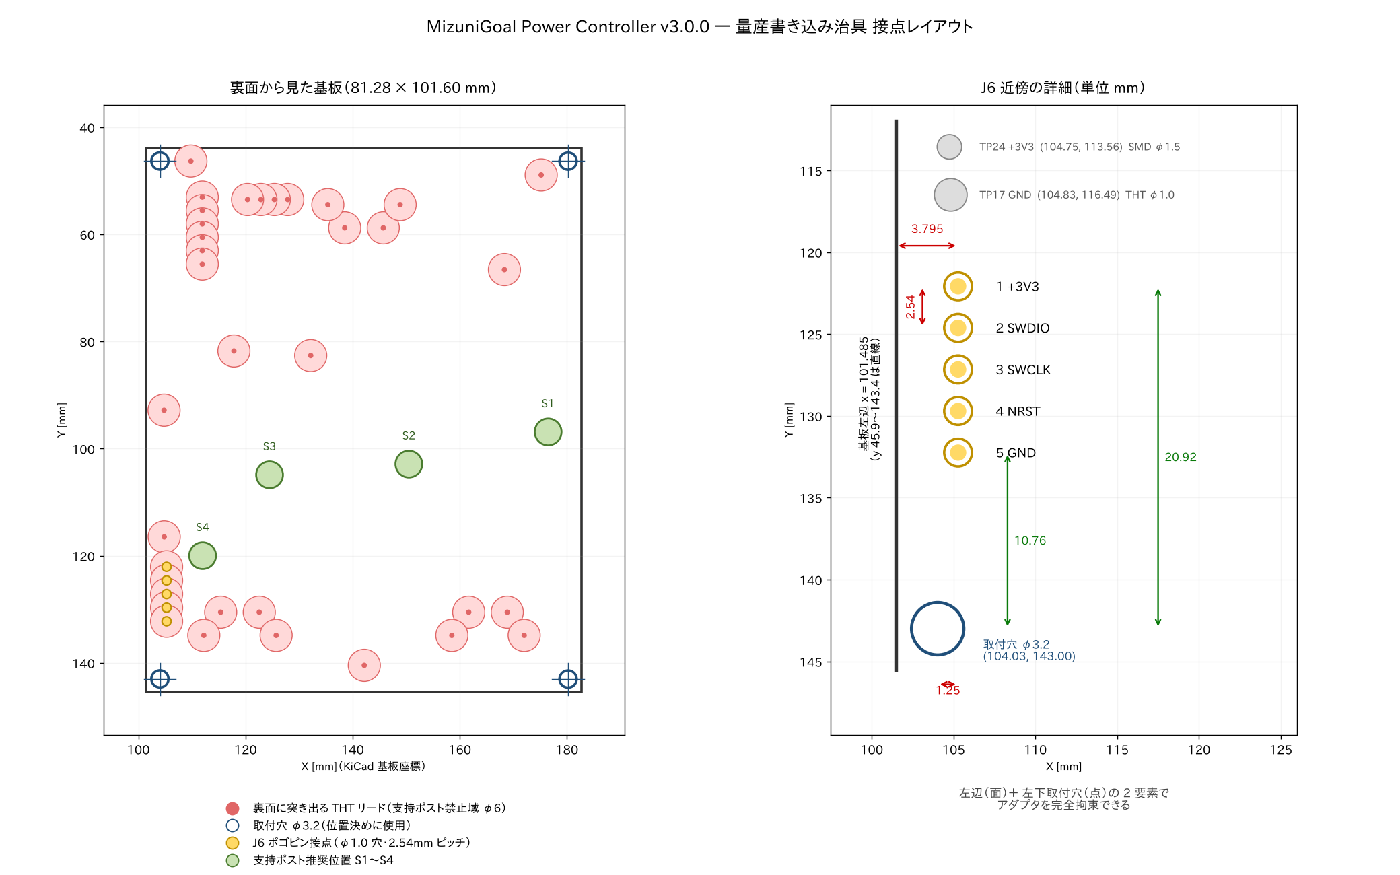
書き込み治具_接点レイアウト.png
