sonatine726/MizuniGoal_PowerController_Docs/rover_harness_bom_plan2_4p14p.xlsx

Sheet: 概要
案2：4極ハーネス（モーター用）＋14極ハーネス（信号用）の2本構成【採用】
採用案。このファイルを正式な購入リストとする。ハーネスは1本に束ねず、モーター用と信号用の2本に分ける
コネクタ | Mini-Fit Jr. 4極（2×2）と14極（2×7）。各中継位置（③-②間、②-①間）に、4極ハーネス用と14極ハーネス用のコネクタをそれぞれ設ける
ハーネス構成 | 4極ハーネス：AV1.25 赤＋／黒−のツイストペア2組（左右モーター）／14極ハーネス：SX(NE) 0.5sq×7P 1本（RC・5V・CURR/VOLT・非常停止SW・LED）。2本は数cm離して配線し、交差は直角に
ハウジング（モノタロウ、税込、10個入り） | 5557-04R（08561481）307円＋5557-14R（08561533）659円＋5559-04P（08561296）395円＋5559-14P（08561341）736円
ハウジング費用合計 | 2,097円（案1より約2,600円安い）
出荷 | すべて当日出荷の表示
ピン構成 | 4極：モーター4本／14極：信号・電源14本（空きなし）
長所 | 安価で納期が短い。モーター電力と信号がハーネスごと分離され、モーター線から信号線へのノイズ結合がさらに小さい（2本を数cm離せる）。浸水・ピン曲がり時の回り込みリスクも低い。4極だけ抜けばモーターだけを切り離せる（机上テストで安全）
短所・注意 | 挿す箇所が2か所で挿し忘れの可能性（両端に「MOTOR」「SIGNAL」のラベルで対策）。ハーネスが2本になり、外装・クリップ・固定箇所が増える。パネル取付耳の有無は図面で確認
共通：端子 | 5556T3L／5558T3L（AWG16、モーター線）、5556TL／5558TL（AWG18〜24、信号）。すずめっき、各100個入り1パック
共通：ケーブル | モーター：エーモンAV1.25 赤・黒（自作ツイスト）／信号：SX(NE) 0.5sq×7P（ペア1〜7）
共通：性別 | ③後部ユニット＝メス(5557)、②ハーネス後部側＝オス(5559)、②ハーネス前部側＝メス(5557)、①前部ユニット＝オス(5559)

Sheet: 購入リスト
ハーネス部品 購入リスト（Molex Mini-Fit Jr. 4極ハーネス＋14極ハーネス 2本構成・採用版）
「必要数」「購入数」は式で計算されます。「確認」「購入」列はプルダウンで選択、「実際に購入した品番」は手入力してください。
No | 区分 | 部品名 | メーカー | 品番（例） | 仕様 | 必要数 | 購入数 | 単位 | 確認ポイント | 確認 | 購入 | 実際に購入した品番・備考
1-1 | コネクタ | メス側ハウジング 4極（レセプタクル） | 日本モレックス | 5557-04R（モノタロウ 08561481） | 4極、2×2、4.2mm、ナイロン66・UL94V-2、10個入り、税込307円 | 2 | 1 | パック | モーター電力用。③後部ユニットと②ハーネスの前部側 | 未確認 | 未購入 | 必要数は個数、購入数はパック数（1パック10個）
1-2 | コネクタ | メス側ハウジング 14極（レセプタクル） | 日本モレックス | 5557-14R（モノタロウ 08561533） | 14極、2×7、4.2mm、ナイロン66・UL94V-2、10個入り、税込659円 | 2 | 1 | パック | 信号・電源用。③後部ユニットと②ハーネスの前部側 | 未確認 | 未購入 | 必要数は個数、購入数はパック数（1パック10個）
2-1 | コネクタ | オス側ハウジング 4極（プラグ） | 日本モレックス | 5559-04P（モノタロウ 08561296） | 4極、2×2、4.2mm、ナイロン66・UL94V-2、10個入り、税込395円 | 2 | 1 | パック | モーター電力用。②ハーネスの後部側と①前部ユニット。パネル取付耳の有無を図面で確認 | 未確認 | 未購入 | 必要数は個数、購入数はパック数（1パック10個）
2-2 | コネクタ | オス側ハウジング 14極（プラグ） | 日本モレックス | 5559-14P（モノタロウ 08561341） | 14極、2×7、4.2mm、ナイロン66・UL94V-2、10個入り、税込736円 | 2 | 1 | パック | 信号・電源用。②ハーネスの後部側と①前部ユニット。パネル取付耳の有無を図面で確認 | 未確認 | 未購入 | 必要数は個数、購入数はパック数（1パック10個）
3 | 端子 | メス端子 AWG16用 | 日本モレックス | 5556T3L（モノタロウ 75939272） | メス端子 AWG16用、すずめっき2.5µm、バラ品、100個入り | 8 | 1 | パック | すずめっきで統一。モーター線用 | 未確認 | 未購入 | 必要数は個数、購入数はパック数（1パック100個）
4 | 端子 | メス端子 AWG18〜24用 | 日本モレックス | 5556TL（モノタロウ 08561682） | メス端子 AWG18〜24用、すずめっき2.5µm、バラ品、100個入り | 28 | 1 | パック | すずめっきで統一。SX(NE)芯線・ドレインの被覆外径が適合範囲内か確認 | 未確認 | 未購入 | 必要数は個数、購入数はパック数（1パック100個）
5 | 端子 | オス端子 AWG16用 | 日本モレックス | 5558T3L（モノタロウ 75939333） | オス端子 AWG16用、すずめっき2.5µm、バラ品、100個入り | 8 | 1 | パック | すずめっきで統一。モーター線用 | 未確認 | 未購入 | 必要数は個数、購入数はパック数（1パック100個）
6 | 端子 | オス端子 AWG18〜24用 | 日本モレックス | 5558TL（モノタロウ 08561454） | オス端子 AWG18〜24用、すずめっき2.5µm、バラ品、100個入り | 28 | 1 | パック | すずめっきで統一 | 未確認 | 未購入 | 必要数は個数、購入数はパック数（1パック100個）
7 | 工具 | 圧着工具 16AWG用 | IWISS（手持ち品で代用） | SN-2549 ＋ 48Bダイス | AWG16は48Bダイスの1.0〜1.5sqの溝で圧着 | 0 | 0 | 本 | 試し圧着で確認：被覆側バレルの閉じ具合（モーター線の被覆外径2.7mm）、Molex仕様書の圧着高さ、引っ張り試験、ハウジングへの挿入 | 未確認 | 未購入 | 購入不要（手持ち品）。不良なら純正200218-2200または63811-1000を検討
8 | 工具 | 圧着工具 18〜24AWG用 | IWISS（手持ち品で代用） | SN-2549（標準ダイス） | AWG20はSN-2549の標準ダイスで圧着 | 0 | 0 | 本 | 試し圧着で確認：芯線・被覆の両バレルの巻き具合、引っ張り試験、ハウジングへの挿入 | 未確認 | 未購入 | 購入不要（手持ち品）
9 | 工具 | 端子取り外し工具 | Molex | 11-03-0044 | Mini-Fit Jr. 用エクストラクタ | 1 | 1 | 本 | ピン配置の修正、将来のDT移行に使用 | 未確認 | 未購入
10 | 電線 | モーター電力用 シールド付き4芯ケーブル | 大電 | ロボトップ(DPC3-SB/2517)AWG16(1.25sq)4c（モノタロウ 34967274、5m巻） | 1.25mm²×4芯、より線124/0.12、絶縁体外径2.7mm、仕上外径9.9mm、シールド付き、UL/c-UL 105℃、300V。左右モーターの±をまとめて通す | 0.0 | 0.0 | m | 各モーターの＋と−は対角の芯線同士で組む（スターカッド）。芯線の色の割り当てをピン配置シートに記録。シールドはMDDS30側（③の端）のみGNDに接続し、①②の区間は折り返して絶縁 | 未確認 | 未購入 | 今回は不採用（到着まで約1週間のため代替案2で先行）。将来の置き換え候補。5m巻×1（必要量2.4m）
10-代替1 | 電線 | モーター線 AWG16 シリコン線 赤黒（自作ツイスト）【No.10の代替案1】 | HaerknCbl（Amazon） | 16AWG/1.3Sq シリコンワイヤー 赤＋黒 2色セット（10mを選択） | 1.3sq、すずめっき銅より線、200℃、600V。赤を＋、黒を−に使い、左右モーター用に赤黒を2本ずつ自分でツイスト（2〜3cmに1回転） | 0 | 0 | セット | 被覆外径をノギスで測り試し圧着で確認。各色約2.6m必要（1本約1.3m×2本、ツイストの縮み込み）。色で左右を区別できないので、ツイスト直後に両端へR/Lのマーカーを付ける（No.18）。シリコン被覆は傷に弱いので角やクランプ部を保護 | 未確認 | 未購入 | 今回は不採用（代替案2を採用）
10-代替2 | 電線 | モーター線 AV1.25 車両用ビニル線 赤・黒（自作ツイスト）【No.10の代替案2】 | エーモン（モノタロウ） | 3470 AV1.25 6m（73991628）を赤・黒の2色で購入（黄・青は品切れ） | 1.25sq、素線50本のより線、耐油・耐候性ビニル、導体最高許容温度80℃、許容電流11.6A。赤＝＋、黒＝−で左右モーター用に2組ツイスト | 2 | 2 | 本（色） | 被覆外径（約2.7〜3mm）を測り5556T3L／5558T3Lで試し圧着。各色約2.6m必要（6mで余裕あり）。左右は色で区別できないため、No.18のマーカーチューブで「R」「L」を表示 | 未確認 | 未購入 | 【今回採用・4極ハーネス】赤・黒 各6m×1。No.10・代替案1は購入不要
11 | 電線 | 5V用 AWG20 電線（赤） | — | — | No.13のペア3で代用（購入不要） | 0.0 | 0.0 | m | ペア3の芯線の色の割り当てをピン配置シートに記録 | 未確認 | 未購入 | 購入不要（No.13のペア3）
12 | 電線 | GND用 AWG20 電線（黒） | — | — | No.13のペア3で代用（購入不要） | 0.0 | 0.0 | m | ペア3の芯線の色の割り当てをピン配置シートに記録 | 未確認 | 未購入 | 購入不要（No.13のペア3）
13 | 電線 | 14極ハーネス用 シールド付きツイストペアケーブル（RC信号・5V・アナログ・非常停止SW・LED） | 太陽ケーブルテック（旧テイコク） | SX(NE) 0.5sq×7P（モノタロウ 5m巻 34956862） | 0.5mm²×7対、編組シールド＋ドレインワイヤ、絶縁体外径1.5mm、仕上外径9.9mm、許容電流5.4A、150V | 1.0 | 1.0 | 巻（5m） | ペア1：RC右＋信号GND、ペア2：RC左＋信号GND、ペア3：5V＋GND、ペア4：SW COM＋NC、ペア5：LED＋＋LED−、ペア6：CURRENT＋VOLTAGE、ペア7：5V＋GND（2本目）。芯線の色をピン配置シートに記録。信号GNDは2本を1端子にダブル圧着 | 未確認 | 未購入 | 5m巻×1（1台分の必要量は約1.2m。作り直し・予備を含む）。税別9,498円、出荷6日以内。2m巻（34956381）でも1台分は可
14 | 材料 | 編組チューブ（PET編組スリーブ） | デンカエレクトロン | FL-12-5（モノタロウ 34658872、全長5m、最大径約24mm） | ポリエステルモノフィラメント、−75〜125℃、UL224、自己消火性。自然折径幅約12〜13mm | 1.0 | 1.0 | 本（5m） | 2本のハーネスそれぞれに使用：4極ハーネス（AVツイストペア2組、外径10mm前後）、14極ハーネス（SX(NE)単体、外径9.9mm）。FL-12（自然折径約12mm、最大径約24mm）はどちらにも適合。切り口ははんだごてで溶着し、熱収縮チューブで仕上げる。SX(NE)はシースがあるため、擦れの心配がない区間は省略可 | 未確認 | 未購入 | 5m巻×1から約0.72m×2本（4極用・14極用）を切り出す
15 | 材料 | 熱収縮チューブ（パック品） | モノタロウ | 収縮チューブ パック品（モノタロウ 60981052） | 収縮前内径1.5/2.5/3.0/4.5/6.5/10.7/12.7mm 各1m×7本、2:1、−55〜125℃、600V | 1 | 1 | セット | 用途の目安：ドレイン線1.5mm、AV線ツイスト端10.7mm、SX(NE)外被端10.7〜12.7mm、編組チューブ端部（各ハーネス外径10mm前後）12.7mm | 未確認 | 未購入 | 代替：PANDUIT HSTT-YK1／YK2は各15cm×2本で量が不足するため不採用
16 | 材料 | ハーネス結束用テープ（布） | モノタロウ | テープ ハーネス結束用（モノタロウ 89826862） | ポリエステル布基材、アクリル系粘着剤、幅19mm×19.6m、厚さ0.3mm、−40〜105℃、手切り可 | 1 | 1 | 巻 | 4極ハーネス（AVツイストペア2組）を10〜15cm間隔で束ねる。14極ハーネスはSX(NE)単体のため、端部とクリップ部の保護に使用。両端に巻いて「前部／後部」「MOTOR／SIGNAL」を油性ペンで記入 | 未確認 | 未購入 | 今回はこちらを購入。代替：キタコ ハーネステープ PVC 0900-755-07010（モノタロウ 73778959、幅19mm×20m、税込395円）
17 | 材料 | ケーブルクリップ（ねじ固定式） | TRUSCO | TCCシリーズ。同軸用：TCC0（適合径3.1mm、モノタロウ 48918886）。ハーネス用：4極・14極とも外径10mm前後のため12.7mmサイズが候補（ハーネスを組んで外径確認後に購入） | ナイロン66、取付穴4.8mm（M4ねじ）、100個入り。適合径3.1〜36.7mmの12サイズ | 1 | 1 | 袋 | 4極ハーネス・14極ハーネス・GNSS同軸をそれぞれ別のクリップで固定し、互いに数cm離す。クリップはハーネスより少し大きいサイズを選び、隙間は布テープで調整。締めすぎ注意（ナイロン割れ・同軸の潰れ） | 未確認 | 未購入 | TCC0×1袋を購入。ハーネス用（12.7mm候補）は外径確認後に追加購入。固定箇所はハーネス2本分（各3〜4か所）。M4ねじ・ナットは別途
18 | 材料 | マーカーチューブ（ビニールチューブ 白） | デンカエレクトロン | TB-3.2W（モノタロウ 34690083） | 内径3.2mm、肉厚0.45mm、軟質PVC、白、5m、−20〜60℃ | 1 | 1 | 本（5m） | 圧着前に電線へ通す。油性ペンで「R+」「R−」「L+」「L−」などと記入（必要に応じ透明熱収縮チューブで保護）。①②③の各端部に約1.5cm（最大24か所） | 未確認 | 未購入 | AV線が赤黒2色のみのため左右の区別に使用。「前部」「後部」は布テープ（No.16）に記入
19 | 電線 | RC用 細線（ピグテール） | — | UL1007 AWG24 より線（例） | MDDS30のRC1・RC2の直前でSX(NE)の0.5sq線から継ぐ短い線。信号2本＋GND2本、各5〜10cm | 0.4 | 0.8 | m | SX(NE)の線とはんだで継ぎ、熱収縮チューブ（No.15の1.5／2.5mm）で絶縁。ドレインはこの継ぎ目でGND側の線にはんだ付け（RC1またはRC2の一方のみ）。継ぎ目はMDDS30近くで固定 | 未確認 | 未購入 | 手持ちがあれば購入不要。色はSIG／GNDで分けると誤配線防止になる
20 | コネクタ | Dupont 1×3ピン ハウジング＋メス端子 | — | 2.54mmピッチ 1×3 ハウジング、メス圧着端子（AWG22〜28用） | MDDS30のRC1・RC2（SIG・5V・GNDの3ピン）用。中央の5Vは空き | 2 | 2 | 組 | IWISS SN-2549で圧着。逆挿し防止のためハウジングとMDDS30にGND側の印、RC1／RC2（R／L）の印を付ける。振動で抜けないようホットボンド等で固定 | 未確認 | 未購入 | ハウジング2個＋端子4個（予備含め多めに）。手持ちのDupontキットがあれば購入不要
集計
確認済の項目数 |  | 0 / 24
受領済の項目数 |  | 0 / 24
注記
・品番は公開されている販売店・メーカー資料で確認したもの（2026年10月時点）。購入前にMolexの製品ページで最新情報を確認してください。
・16AWG用端子の圧着工具・アプリケータは被覆外径別（1.80〜2.20mm、2.20〜2.45mm、2.60〜3.15mm）に分かれる。モーター線（ロボトップ4芯）の被覆外径は2.7mm。
・端子のめっきはオス・メスともすずめっきで統一する（すずと金を混ぜると、振動・水分によるフレッティング腐食や異種金属腐食で接触抵抗が上がる）。
・①③の引き出し長さとクランプ数は仮定値。「条件」シートで実寸に変更すると数量が更新される。

Sheet: ピン配置
4極ハーネス＋14極ハーネス 中継コネクタ ピン配置（両方の中継位置で共通）
位置は配置案。実際のピン番号はハウジングの図面で確認し、「実際のピン番号」列に記入してください。
コネクタ | 列 | 段 | 信号 | 電線 | AWG | 端子 | 実際のピン番号 | 備考
4極 | 1 | 上 | 右M＋ | エーモンAV1.25（赤） | 1.25sq | 16AWG用 |  | 右モーターのツイストペア（赤＋／黒−）。両端にマーカー「R」
4極 | 1 | 下 | 左M＋ | エーモンAV1.25（赤） | 1.25sq | 16AWG用 |  | 左モーターのツイストペア（赤＋／黒−）。両端にマーカー「L」
4極 | 2 | 上 | 右M− | エーモンAV1.25（黒） | 1.25sq | 16AWG用 |  | 右モーターのツイストペア。マーカー「R」
4極 | 2 | 下 | 左M− | エーモンAV1.25（黒） | 1.25sq | 16AWG用 |  | 左モーターのツイストペア。マーカー「L」
14極 | 1 | 上 | 5V | SX(NE) 0.5sq×7P | 0.5sq | 18〜24AWG用 |  | ペア3。BEC（後部）からPixhawk等（前部）へ
14極 | 1 | 下 | GND | SX(NE) 0.5sq×7P | 0.5sq | 18〜24AWG用 |  | ペア3の相手線。5V電流の戻り
14極 | 2 | 上 | 5V（2本目） | SX(NE) 0.5sq×7P | 0.5sq | 18〜24AWG用 |  | ペア7。電圧降下を半減するため列4の5Vと両端で並列接続
14極 | 2 | 下 | GND（2本目） | SX(NE) 0.5sq×7P | 0.5sq | 18〜24AWG用 |  | ペア7の相手線。列4のGNDと両端で並列接続
14極 | 3 | 上 | CURRENT | SX(NE) 0.5sq×7P | 0.5sq | 18〜24AWG用 |  | ペア6。0〜3.3Vアナログ。25Vの線から離して配置
14極 | 3 | 下 | VOLTAGE | SX(NE) 0.5sq×7P | 0.5sq | 18〜24AWG用 |  | ペア6の相手線。0〜3.3Vアナログ。基準は信号GND
14極 | 4 | 上 | RC右 | SX(NE) 0.5sq×7P | 0.5sq | 18〜24AWG用 |  | ペア1
14極 | 4 | 下 | RC左 | SX(NE) 0.5sq×7P | 0.5sq | 18〜24AWG用 |  | ペア2
14極 | 5 | 上 | 信号GND | SX(NE) 0.5sq×7P | 0.5sq | 18〜24AWG用（2本圧着） |  | ペア1・2の相手線をダブル圧着。RC信号とアナログ信号の基準
14極 | 5 | 下 | ドレイン | SX(NE) 0.5sq×7P | — | 18〜24AWG用 |  | 接地はMDDS30側（③の端）のみ。①の端では接続しない
14極 | 6 | 上 | SW COM | SX(NE) 0.5sq×7P | 0.5sq | 18〜24AWG用 |  | ペア4。7S LiPo電圧、直列抵抗で電流制限
14極 | 6 | 下 | SW NC | SX(NE) 0.5sq×7P | 0.5sq | 18〜24AWG用 |  | ペア4の相手線。NC開で停止（外れ・断線も停止側）。受け側にフィルタ／デバウンス
14極 | 7 | 上 | LED＋ | SX(NE) 0.5sq×7P | 0.5sq | 18〜24AWG用 |  | ペア5。7S LiPo電圧、ポリスイッチで保護。最も端に配置
14極 | 7 | 下 | LED− | SX(NE) 0.5sq×7P | 0.5sq | 18〜24AWG用 |  | ペア5の相手線。電源基板GNDへ専用線で戻す
性別（4極・14極とも）：③後部ユニット＝メス（5557）、②ハーネス後部側＝オス（5559）、②ハーネス前部側＝メス（5557）、①前部ユニット＝オス（5559）
4極ハーネス（モーター）と14極ハーネス（信号）は別々に配線し、数cm離す（交差は直角に）。両端に「MOTOR」「SIGNAL」のラベルを付け、挿し忘れを防ぐ（大きさが違うため差し違えは起きない）
モーター電力と信号はハーネスごと分離されるため、20極案の空き列（緩衝）は不要
5V・GNDは2本ずつ使い、①③の機器側（PM02／制御基板）でそれぞれ合流させる
色：オレンジ＝モーター電力、灰＝電源・GND、紫＝アナログ（0〜3.3V）、緑＝RC信号、ピンク＝7S LiPo電圧（電流制限あり）
MDDS30側（③）：RC右＝ペア1→RC1のSIG／GND、RC左＝ペア2→RC2のSIG／GND。手前でAWG24に継いでDupont 1×3（中央5Vは空き）。ドレインはRC1かRC2の一方のGNDへ

Sheet: 条件
ハーネス部品 購入リスト：計算条件
黄色のセル（青字）が入力欄です。値を変えると「購入リスト」の数量が自動で再計算されます。
項目 | 値 | 単位 | 根拠・備考
中継コネクタ位置の数（各サイズとも） | 2 | 組 | ③-②間、②-①間の2か所。4極・14極それぞれ同数
1コネクタあたりのモーター用ピン数（AWG16） | 4 | 本 | 右M＋、右M−、左M＋、左M−
1コネクタあたりの信号・5V用ピン数（AWG20） | 14 | 本 | 5V×2、GND×2、CURRENT、VOLTAGE、RC右、RC左、信号GND、ドレイン、SW COM、SW NC、LED＋、LED−
端子の購入倍率（練習・試験・予備分） | 2.5 | 倍 | 圧着の練習と引っ張り試験用の余裕
②ハーネスの長さ | 0.6 | m | ユーザー提示の50〜60cmの上限
①前部ユニットの引き出し長さ | 0.3 | m | 仮定値。実寸に合わせて変更してください
③後部ユニットの引き出し長さ | 0.3 | m | 仮定値。実寸に合わせて変更してください
電線の購入倍率（試作・作り直し分） | 2 | 倍 | 作り直しに備えた余裕
モーター線の本数 | 4 | 本 | 左右×＋/−
編組スリーブの長さ倍率 | 1.2 | 倍 | 端部処理・取り回し分
ケーブルクランプの数 | 6 | 個 | 仮定値。各コネクタの前後＋途中2か所
1区間あたりの電線長（①＋②＋③） | 1.2 | m
