sonatine726/MizuniGoal_PowerController_Docs/rover_harness_bom_v1.xlsx

Sheet: 概要
ローバー前後間ハーネス Ver.1：4極ハーネス（モーター用）＋14極ハーネス（信号用）の2本構成
正式な購入リスト（Ver.1、2026-10-21）。ハーネスは1本に束ねず、モーター用と信号用の2本に分ける
版数 | Ver.1（2026-10-21）
コネクタ | Mini-Fit Jr. 4極（2×2）と14極（2×7）。各中継位置（③-②間、②-①間）に、4極ハーネス用と14極ハーネス用のコネクタをそれぞれ設ける
ハーネス構成 | 4極ハーネス：AV1.25 赤＋／黒−のツイストペア2組（左右モーター）／14極ハーネス：SX(NE) 0.5sq×7P 1本（RC・5V・CURR/VOLT・非常停止SW・LED）。2本は数cm離して配線し、交差は直角に
ハウジング（モノタロウ、税込、10個入り） | 5557-04R（08561481）307円＋5557-14R（08561533）659円＋5559-04P（08561296）395円＋5559-14P（08561341）736円
ハウジング費用合計 | 2,097円（20極コネクタ1個の構成と比べ約2,600円安い）
出荷 | すべて当日出荷の表示
ピン構成 | 4極：モーター4本／14極：信号・電源14本（空きなし）
長所 | 安価で納期が短い。モーター電力と信号がハーネスごと分離され、モーター線から信号線へのノイズ結合がさらに小さい（2本を数cm離せる）。浸水・ピン曲がり時の回り込みリスクも低い。4極だけ抜けばモーターだけを切り離せる（机上テストで安全）
短所・注意 | 挿す箇所が2か所で挿し忘れの可能性（両端に「MOTOR」「SIGNAL」のラベルで対策）。ハーネスが2本になり、外装・クリップ・固定箇所が増える。パネル取付耳の有無は図面で確認
共通：端子 | 5556T3L／5558T3L（AWG16、モーター線）、5556TL／5558TL（AWG18〜24、②ハーネスのSX(NE)）、5556T2L／5558T2L（AWG22〜28、①③ユニット側のAWG26）。すずめっき、各100個入り1パック
共通：ケーブル | ②ハーネス：モーター＝エーモンAV1.25 赤・黒（自作ツイスト）／信号＝SX(NE) 0.5sq×7P（ペア1〜7、14芯すべて使用）。①③ユニット側（各約10cm）：モーター＝AWG16、5V・GND・CURRENT・VOLTAGE・RC・信号GND・ドレイン＝AWG26（住友電工 UL1571）、SW・LED＝AWG24（UL3265、150V）。PM02・Pixhawk側はJST GH 6ピンを自作
共通：性別 | ③後部ユニット＝メス(5557)、②ハーネス後部側＝オス(5559)、②ハーネス前部側＝メス(5557)、①前部ユニット＝オス(5559)

Sheet: 購入リスト
ハーネス部品 購入リスト Ver.1（Molex Mini-Fit Jr. 4極ハーネス＋14極ハーネス 2本構成）
「必要数」「購入数」は式で計算されます。「確認」「購入」列はプルダウンで選択、「実際に購入した品番」は手入力してください。
No | 区分 | 部品名 | メーカー | 品番（例） | 仕様 | 必要数 | 購入数 | 単位 | 確認ポイント | 確認 | 購入 | 実際に購入した品番・備考 | 品質文書（データシート・証明書）
1-1 | コネクタ | メス側ハウジング 4極（レセプタクル） | 日本モレックス | 5557-04R（モノタロウ 08561481） | 4極、2×2、4.2mm、ナイロン66・UL94V-2、10個入り、税込307円 | 2 | 1 | パック | モーター電力用。③後部ユニットと②ハーネスの前部側 | 未確認 | 未購入 | 必要数は個数、購入数はパック数（1パック10個） | https://www.molex.com/ja-jp/products/part-detail/39013042
1-2 | コネクタ | メス側ハウジング 14極（レセプタクル） | 日本モレックス | 5557-14R（モノタロウ 08561533） | 14極、2×7、4.2mm、ナイロン66・UL94V-2、10個入り、税込659円 | 2 | 1 | パック | 信号・電源用。③後部ユニットと②ハーネスの前部側 | 未確認 | 未購入 | 必要数は個数、購入数はパック数（1パック10個） | https://www.molex.com/ja-jp/products/part-detail/39012140
2-1 | コネクタ | オス側ハウジング 4極（プラグ） | 日本モレックス | 5559-04P（モノタロウ 08561296） | 4極、2×2、4.2mm、ナイロン66・UL94V-2、10個入り、税込395円 | 2 | 1 | パック | モーター電力用。②ハーネスの後部側と①前部ユニット。パネル取付耳の有無を図面で確認 | 未確認 | 未購入 | 必要数は個数、購入数はパック数（1パック10個） | https://www.molex.com/ja-jp/products/part-detail/39013043
2-2 | コネクタ | オス側ハウジング 14極（プラグ） | 日本モレックス | 5559-14P（モノタロウ 08561341） | 14極、2×7、4.2mm、ナイロン66・UL94V-2、10個入り、税込736円 | 2 | 1 | パック | 信号・電源用。②ハーネスの後部側と①前部ユニット。パネル取付耳の有無を図面で確認 | 未確認 | 未購入 | 必要数は個数、購入数はパック数（1パック10個） | https://www.molex.com/ja-jp/products/part-detail/39012141
3 | 端子 | メス端子 AWG16用 | 日本モレックス | 5556T3L（モノタロウ 75939272） | メス端子 AWG16用、すずめっき2.5µm、バラ品、100個入り | 8 | 1 | パック | すずめっきで統一。モーター線用 | 未確認 | 未購入 | 必要数は個数、購入数はパック数（1パック100個） | https://www.molex.com/ja-jp/products/part-detail/39000078
4 | 端子 | メス端子 AWG18〜24用 | 日本モレックス | 5556TL（モノタロウ 08561682） | メス端子 AWG18〜24用、すずめっき2.5µm、バラ品、100個入り | 14 | 1 | パック | すずめっきで統一。②ハーネス前部側（5557-14R）のSX(NE)芯線・ドレイン用。SX(NE)の絶縁体外径1.5mmは適合範囲1.3〜3.1mm内 | 未確認 | 未購入 | 必要数は個数、購入数はパック数（1パック100個） | https://www.molex.com/ja-jp/products/part-detail/39000038
4-2 | 端子 | メス端子 AWG22〜28用 | 日本モレックス | 5556T2L（モノタロウ 08561691） | メス端子 AWG22〜28用（被覆外径0.90〜1.80mm）、すずめっき2.5µm、バラ品、100個入り、税込1,309円 | 14 | 1 | パック | すずめっきで統一。③後部ユニット側（5557-14R）のAWG26（6線ケーブル・信号線）用 | 未確認 | 未購入 | 必要数は個数、購入数はパック数（1パック100個） | https://www.molex.com/ja-jp/products/part-detail/39000047
5 | 端子 | オス端子 AWG16用 | 日本モレックス | 5558T3L（モノタロウ 75939333） | オス端子 AWG16用、すずめっき2.5µm、バラ品、100個入り | 8 | 1 | パック | すずめっきで統一。モーター線用 | 未確認 | 未購入 | 必要数は個数、購入数はパック数（1パック100個） | https://www.molex.com/ja-jp/products/part-detail/39000125
6 | 端子 | オス端子 AWG18〜24用 | 日本モレックス | 5558TL（モノタロウ 08561454） | オス端子 AWG18〜24用、すずめっき2.5µm、バラ品、100個入り | 14 | 1 | パック | すずめっきで統一。②ハーネス後部側（5559-14P）のSX(NE)芯線・ドレイン用 | 未確認 | 未購入 | 必要数は個数、購入数はパック数（1パック100個） | https://www.molex.com/ja-jp/products/part-detail/39000121
6-2 | 端子 | オス端子 AWG22〜28用 | 日本モレックス | 5558T2L（モノタロウ 08561463） | オス端子 AWG22〜28用（被覆外径0.90〜1.80mm）、すずめっき2.5µm、バラ品、100個入り、税込1,318円 | 14 | 1 | パック | すずめっきで統一。①前部ユニット側（5559-14P）のAWG26（6線ケーブル・信号線）用 | 未確認 | 未購入 | 必要数は個数、購入数はパック数（1パック100個） | https://www.molex.com/ja-jp/products/part-detail/39000123
7 | 工具 | 圧着工具 16AWG用 | IWISS（手持ち品で代用） | SN-2549 ＋ 48Bダイス | AWG16は48Bダイスの1.0〜1.5sqの溝で圧着 | 0 | 0 | 本 | 試し圧着で確認：被覆側バレルの閉じ具合（モーター線の被覆外径2.7mm）、Molex仕様書の圧着高さ、引っ張り試験、ハウジングへの挿入 | 未確認 | 未購入 | 購入不要（手持ち品）。不良なら純正200218-2200または63811-1000を検討 | なし（手持ち品）
8 | 工具 | 圧着工具 AWG20〜26用 | IWISS（手持ち品で代用） | SN-2549（標準ダイス） | SX(NE) 0.5sq（AWG20相当、TL端子）とAWG26（T2L端子）をSN-2549の標準ダイスで圧着 | 0 | 0 | 本 | 試し圧着で確認：芯線・被覆の両バレルの巻き具合、引っ張り試験、ハウジングへの挿入。AWG26がダイスの適合範囲に入るか確認。被覆外径0.98mmはT2Lの下限（0.90mm）に近いので被覆バレルの保持を重点的に確認 | 未確認 | 未購入 | 購入不要（手持ち品） | なし（手持ち品）
9 | 工具 | 端子取り外し工具 | Molex | 11-03-0044 | Mini-Fit Jr. 用エクストラクタ | 1 | 1 | 本 | ピン配置の修正、将来のDT移行に使用 | 未確認 | 未購入 |  | https://www.molex.com/ja-jp/products/part-detail/11030044
10 | 電線 | 4極ハーネス用 モーター線 AV1.25 車両用ビニル線 赤・黒（自作ツイスト） | エーモン（モノタロウ） | 3470 AV1.25 6m（73991628）を赤・黒の2色で購入（黄・青は品切れ） | 1.25sq、素線50本のより線、耐油・耐候性ビニル、導体最高許容温度80℃、許容電流11.6A。赤＝＋、黒＝−で左右モーター用に2組ツイスト | 2 | 2 | 本（色） | 被覆外径（約2.7〜3mm）を測り5556T3L／5558T3Lで試し圧着。各色約2.6m必要（6mで余裕あり）。左右は色で区別できないため、No.18のマーカーチューブで「R」「L」を表示 | 未確認 | 未購入 | 赤・黒 各6m×1（作り直し・予備を含む）。将来の置き換え候補：大電 ロボトップ(DPC3-SB/2517)AWG16 4c（モノタロウ 34967274） | なし（エーモン、購入先：モノタロウ 73991628）
11 | コネクタ | GH 6ピン ハウジング（PM02・Pixhawk側） | 日本圧着端子製造（JST） | GHR-06V-S | 1.25mmピッチ、6極、ワイヤー対基板用ハウジング（JST GHシリーズ） | 2.0 | 2.0 | 個 | ③はPM02 V3の6ピン、①はPixhawk 6C Mini POWER1に挿す。ピン1・2＝5V、3＝CURRENT、4＝VOLTAGE、5・6＝GND（PM02付属ケーブルの並びと照合） | 未確認 | 未購入 | 購入先未定。予備を含め多めに購入 | JST GHシリーズ データシート：https://www.jst-mfg.com/product/pdf/eng/eGH.pdf
11-2 | 端子 | GH 圧着コンタクト | 日本圧着端子製造（JST） | SSHL-002T-P0.2 | AWG30〜26（0.05〜0.13mm²）、被覆外径0.8〜1.0mm | 12.0 | 30.0 | 個 | 住友AWG26（被覆外径0.98mm）は適合範囲の上限付近。試し圧着で被覆バレルの閉じ具合とハウジングへの挿入を確認 | 未確認 | 未購入 | 購入先未定。購入数は練習・予備分（条件シートの購入倍率）を含む | JST GHシリーズ データシート：https://www.jst-mfg.com/product/pdf/eng/eGH.pdf
11-3 | 工具 | GH用 圧着工具 | — | 品番未定（JST GH SSHL-002T-P0.2に対応する1.25mmピッチ用ハンド圧着工具） | AWG26〜30、オープンバレル端子用 | 1.0 | 1.0 | 本 | IWISS SN-2549（Mini-Fit用）では圧着できない。適合表でSSHL-002T-P0.2（AWG26）への対応を確認してから購入 | 未確認 | 未購入 | 品番未定 | 品番決定後に記入
12 | 電線 | ユニット側 AWG26 単線（5V×2・GND×2・CURRENT・VOLTAGE・RC右・RC左・信号GND・ドレイン） | 住友電工（秋月電子） | 耐熱電子ワイヤー 1m×9色 AWG26（秋月電子 118293） | AWG26、7本／0.16mm すずめっき軟銅より線、被覆外径0.98mm、イラックスV2、最高80℃、税込440円 | 1.0 | 1.0 | パック | ①③とも約10cm×最大10本（6ピン電源用6本＋RC・信号GND・ドレイン4本）。UL AWM 1571（30V、80℃）。9色のため、足りない分はマーカーチューブで区別し、色の割り当てをピン配置シートに記録 | 未確認 | 未購入 | 9色×1mで①③分に足りる | UL AWM 1571 データシート（住友電工）：https://akizukidenshi.com/goodsaffix/ulawm1571.pdf
12-2 | 電線 | ユニット側 AWG24 単線（SW COM・SW NC・LED＋・LED−） | 協和ハーモネット（秋月電子） | 耐熱電子ワイヤー 2m×7色 UL3265 AWG24（秋月電子 106756） | AWG24、11本／0.16mm すずめっき軟銅より線、被覆外径1.21mm、難燃架橋ポリエチレン、125℃、150V、税込720円 | 1.0 | 1.0 | パック | 7S LiPo電圧（最大29.4V）がかかる4本用。AWG26（UL1571）は定格30Vで余裕がないため、150V定格のこの線を使う。T2L端子（被覆外径0.90〜1.80mm）で圧着 | 未確認 | 未購入 | ①③とも約10cm×4本 | なし（協和ハーモネット、UL3265。購入先：秋月電子 106756）
13 | 電線 | 14極ハーネス用 シールド付きツイストペアケーブル（RC信号・5V・アナログ・非常停止SW・LED） | 太陽ケーブルテック（旧テイコク） | SX(NE) 0.5sq×7P（モノタロウ 5m巻 34956862） | 0.5mm²×7対、編組シールド＋ドレインワイヤ、絶縁体外径1.5mm、仕上外径9.9mm、許容電流5.4A、150V | 1.0 | 1.0 | 巻（5m） | ペア1：RC右＋信号GND、ペア2：RC左＋信号GND、ペア3：5V＋GND、ペア4：SW COM＋NC、ペア5：LED＋＋LED−、ペア6：CURRENT＋VOLTAGE、ペア7：5V＋GND（2本目）。芯線の色をピン配置シートに記録。信号GNDは2本を1端子にダブル圧着 | 未確認 | 未購入 | 5m巻×1（1台分の必要量は約1.2m。作り直し・予備を含む）。税別9,498円、出荷6日以内。2m巻（34956381）でも1台分は可 | カタログ（IPROS）：https://mono.ipros.com/product/detail/2000637273/ SX(NE)仕様（MISUMI）：https://chk0-jp.misumi-ec.com/pdf/el/2015_H/1258.pdf 仕様変更のお知らせ：https://www.koshow.jp/topics/2023/07/post-18.html
14 | 材料 | 編組チューブ（PET編組スリーブ） | デンカエレクトロン | FL-12-5（モノタロウ 34658872、全長5m、最大径約24mm） | ポリエステルモノフィラメント、−75〜125℃、UL224、自己消火性。自然折径幅約12〜13mm | 1.0 | 1.0 | 本（5m） | 2本のハーネスそれぞれに使用：4極ハーネス（AVツイストペア2組、外径10mm前後）、14極ハーネス（SX(NE)単体、外径9.9mm）。FL-12（自然折径約12mm、最大径約24mm）はどちらにも適合。切り口ははんだごてで溶着し、熱収縮チューブで仕上げる。SX(NE)はシースがあるため、擦れの心配がない区間は省略可 | 未確認 | 未購入 | 5m巻×1から約0.72m×2本（4極用・14極用）を切り出す | カタログ：https://jp.images-monotaro.com/etc/pdf/product/product_1462545_20251105_01.pdf RoHS2証明書：https://jp.images-monotaro.com/etc/pdf/product/product_1462545_20251105_02.pdf 非含有証明書：https://jp.images-monotaro.com/etc/pdf/product/product_1462545_20251105_03.pdf
15 | 材料 | 熱収縮チューブ（パック品） | モノタロウ | 収縮チューブ パック品（モノタロウ 60981052） | 収縮前内径1.5/2.5/3.0/4.5/6.5/10.7/12.7mm 各1m×7本、2:1、−55〜125℃、600V | 1 | 1 | セット | 用途の目安：ドレイン線1.5mm、AV線ツイスト端10.7mm、SX(NE)外被端10.7〜12.7mm、編組チューブ端部（各ハーネス外径10mm前後）12.7mm | 未確認 | 未購入 | PANDUIT HSTT-YK1／YK2は各15cm×2本で量が不足するため使用しない | RoHS指令対応証明書：https://jp.images-monotaro.com/etc/pdf/rohs/G2773351_RoHS_done_20260703.pdf
16 | 材料 | ハーネス結束用テープ（布） | モノタロウ | テープ ハーネス結束用（モノタロウ 89826862） | ポリエステル布基材、アクリル系粘着剤、幅19mm×19.6m、厚さ0.3mm、−40〜105℃、手切り可 | 1 | 1 | 巻 | 4極ハーネス（AVツイストペア2組）を10〜15cm間隔で束ねる。14極ハーネスはSX(NE)単体のため、端部とクリップ部の保護に使用。両端に巻いて「前部／後部」「MOTOR／SIGNAL」を油性ペンで記入 | 未確認 | 未購入 | 今回はこちらを購入。代替：キタコ ハーネステープ PVC 0900-755-07010（モノタロウ 73778959、幅19mm×20m、税込395円） | なし（モノタロウPB。SDS・RoHS等はモノタロウへ依頼可）
17 | 材料 | ケーブルクリップ（ねじ固定式） | TRUSCO | TCCシリーズ。同軸用：TCC0（適合径3.1mm、モノタロウ 48918886）。ハーネス用：4極・14極とも外径10mm前後のため12.7mmサイズが候補（ハーネスを組んで外径確認後に購入） | ナイロン66、取付穴4.8mm（M4ねじ）、100個入り。適合径3.1〜36.7mmの12サイズ | 1 | 1 | 袋 | 4極ハーネス・14極ハーネス・GNSS同軸をそれぞれ別のクリップで固定し、互いに数cm離す。クリップはハーネスより少し大きいサイズを選び、隙間は布テープで調整。締めすぎ注意（ナイロン割れ・同軸の潰れ） | 未確認 | 未購入 | TCC0×1袋を購入。ハーネス用（12.7mm候補）は外径確認後に追加購入。固定箇所はハーネス2本分（各3〜4か所）。M4ねじ・ナットは別途 | なし（TRUSCO。SDS・RoHS等はモノタロウへ依頼可）
18 | 材料 | マーカーチューブ（ビニールチューブ 白） | デンカエレクトロン | TB-3.2W（モノタロウ 34690083） | 内径3.2mm、肉厚0.45mm、軟質PVC、白、5m、−20〜60℃ | 1 | 1 | 本（5m） | 圧着前に電線へ通す。油性ペンで「R+」「R−」「L+」「L−」などと記入（必要に応じ透明熱収縮チューブで保護）。①②③の各端部に約1.5cm（最大24か所） | 未確認 | 未購入 | AV線が赤黒2色のみのため左右の区別に使用。「前部」「後部」は布テープ（No.16）に記入 | カタログ：https://jp.images-monotaro.com/etc/pdf/product/product_77055625_20250625_01.pdf RoHS2証明書：https://jp.images-monotaro.com/etc/pdf/product/product_77055625_20250625_02.pdf 含有有無：https://jp.images-monotaro.com/etc/pdf/product/product_77055625_20250625_03.pdf
19 | コネクタ | Dupont 1×3ピン ハウジング＋メス端子 | — | 2.54mmピッチ 1×3 ハウジング、メス圧着端子（AWG22〜28用） | MDDS30のRC1・RC2（SIG・5V・GNDの3ピン）用。中央の5Vは空き | 4 | 4 | 組 | 前部：Pixhawk 6C Mini のRC出力（S・＋・−）用2組、後部：MDDS30 のRC1・RC2用2組。どちらも中央の＋（5V）は空き。ユニット側のAWG26をそのまま圧着。逆挿し防止のためハウジングと相手側にGND側の印、R／Lの印を付ける。振動で抜けないようホットボンド等で固定 | 未確認 | 未購入 | ハウジング4個＋端子8個（予備含め多めに）。手持ちのDupontキットがあれば購入不要 | なし（汎用品）
20 | コネクタ | XT60コネクタ（モーター接続用） | Amass（常州アマス電子） | XT60H-F（①ハーネス側＝通電側、メス）／XT60H-M（モーター側、オス） | はんだカップ式、DC500V、定格30A（瞬間60A）、CE・UL | 2 | 2 | 組 | ①前部ユニットのモーター線（AWG16）と左右モーターの接続用。通電側（コントローラ側）をメスにする。モーターに既にXT60が付いている場合は性別を確認し、必要な側だけ購入。正規品は本体に「AMASS」の刻印があることを受入時に確認 | 未確認 | 未購入 | 購入先候補：モノタロウ XT60H-M（68706666、税込208円、メーカー表記なし→刻印を確認）。メスは購入先未定 | Amass XT60H-M 仕様シート：https://cdn.eicom.ru/media/PDF/XT60H-M.pdf Amass ダウンロードページ：https://www.china-amass.com/download/
21 | コネクタ | JST XA 4ピン ハウジング（電源基板のスイッチ用） | 日本圧着端子製造（JST） | XAP-04V-1 | 2.5mmピッチ、4極、ワイヤー対基板用ハウジング | 1 | 1 | 個 | ③後部ユニットのSW COM・SW NC・LED＋・LED−を電源基板のスイッチ用コネクタへ。ピン並びは電源基板側の図面で確認 | 未確認 | 未購入 | 購入先未定。予備を含め多めに購入 | JST XA データシート：https://www.farnell.com/datasheets/1626572.pdf
21-2 | 端子 | JST XA 圧着コンタクト | 日本圧着端子製造（JST） | SXA-001T-P0.6 | AWG28〜22（0.08〜0.33mm²） | 4 | 10 | 個 | SW・LED用のAWG24（UL3265）を圧着。適合する圧着工具（ダイス）を確認し、試し圧着で引っ張り試験 | 未確認 | 未購入 | 購入先未定。購入数は練習・予備分（条件シートの購入倍率）を含む | JST XA データシート：https://www.farnell.com/datasheets/1626572.pdf
22 | 端子 | 絶縁被覆付き丸形圧着端子（MDDS30のモーター出力用） | ニチフ | TMEV1.25-◯（◯＝ねじの呼び径。MDDS30の端子ねじに合わせる） | 銅線用 R形（丸形）、1.25sq用、絶縁被覆ポリ塩化ビニル、JIS C 2805 | 4 | 4 | 個 | ③後部ユニットのモーター線（AV1.25）をMDDS30のMLA・MLB・MRA・MRBへ。MDDS30の端子台が「ねじで押さえ板を締める形」か「穴に差し込む形（ボックス形）」かを現物で確認。差し込む形の場合、丸形端子は使えないため棒形端子（フェルール）に変更する | 未確認 | 未購入 | ねじ径とパック品の入数を確認して購入。JST FV1.25シリーズでも可 | ニチフ TMEV カタログ：https://vn.c.misumi-ec.com/book/NCF1_E03/pdf/0001.pdf （代替）JST FV・Vシリーズ カタログ：https://docs.rs-online.com/941e/0900766b80fc8d98.pdf
集計
確認済の項目数 |  | 0 / 30
受領済の項目数 |  | 0 / 30
注記
・品番は公開されている販売店・メーカー資料で確認したもの（2026年10月時点）。購入前にMolexの製品ページで最新情報を確認してください。
・16AWG用端子の圧着工具・アプリケータは被覆外径別（1.80〜2.20mm、2.20〜2.45mm、2.60〜3.15mm）に分かれる。モーター線（エーモンAV1.25）の被覆外径は約2.7〜3mm。
・端子のめっきはオス・メスともすずめっきで統一する（すずと金を混ぜると、振動・水分によるフレッティング腐食や異種金属腐食で接触抵抗が上がる）。
・①③の引き出し長さは約10cm（ユーザー提示）、クランプ数は仮定値。「条件」シートで実寸に変更すると数量が更新される。

Sheet: ピン配置
4極ハーネス＋14極ハーネス 中継コネクタ ピン配置 Ver.1（両方の中継位置で共通）
実際のピン番号はハウジングの図面で確認し、「実際のピン番号」列に記入してください。
コネクタ | 列 | 段 | 信号 | 電線 | AWG | 端子 | 実際のピン番号 | 備考
4極 | 1 | 上 | 右M＋ | エーモンAV1.25（赤） | 1.25sq | 16AWG用 |  | 右モーターのツイストペア（赤＋／黒−）。両端にマーカー「R」
4極 | 1 | 下 | 右M− | エーモンAV1.25（黒） | 1.25sq | 16AWG用 |  | 右モーターのツイストペアの相手線。マーカー「R」
4極 | 2 | 上 | 左M＋ | エーモンAV1.25（赤） | 1.25sq | 16AWG用 |  | 左モーターのツイストペア（赤＋／黒−）。両端にマーカー「L」
4極 | 2 | 下 | 左M− | エーモンAV1.25（黒） | 1.25sq | 16AWG用 |  | 左モーターのツイストペアの相手線。マーカー「L」
14極 | 1 | 上 | 5V | SX(NE) 0.5sq×7P | 0.5sq | 18〜24AWG用 |  | ペア3。BEC（後部）からPixhawk等（前部）へ
14極 | 1 | 下 | GND | SX(NE) 0.5sq×7P | 0.5sq | 18〜24AWG用 |  | ペア3の相手線。5V電流の戻り
14極 | 2 | 上 | 5V（2本目） | SX(NE) 0.5sq×7P | 0.5sq | 18〜24AWG用 |  | ペア7。電圧降下を半減するため列4の5Vと両端で並列接続
14極 | 2 | 下 | GND（2本目） | SX(NE) 0.5sq×7P | 0.5sq | 18〜24AWG用 |  | ペア7の相手線。列4のGNDと両端で並列接続
14極 | 3 | 上 | CURRENT | SX(NE) 0.5sq×7P | 0.5sq | 18〜24AWG用 |  | ペア6。0〜3.3Vアナログ。25Vの線から離して配置
14極 | 3 | 下 | VOLTAGE | SX(NE) 0.5sq×7P | 0.5sq | 18〜24AWG用 |  | ペア6の相手線。0〜3.3Vアナログ。基準は信号GND
14極 | 4 | 上 | RC右 | SX(NE) 0.5sq×7P | 0.5sq | 18〜24AWG用 |  | ペア1
14極 | 4 | 下 | RC左 | SX(NE) 0.5sq×7P | 0.5sq | 18〜24AWG用 |  | ペア2
14極 | 5 | 上 | 信号GND | SX(NE) 0.5sq×7P | 0.5sq | 18〜24AWG用（2本圧着） |  | ペア1・2の相手線（2本）をダブル圧着。RC信号とアナログ信号の基準
14極 | 5 | 下 | ドレイン | SX(NE) 0.5sq×7P | — | 18〜24AWG用 |  | ドレイン線のみ（芯線とは接続しない）。接地は③側のみ。①ユニット側はこのキャビティを空けたまま（未接続）
14極 | 6 | 上 | SW COM | SX(NE) 0.5sq×7P | 0.5sq | 18〜24AWG用 |  | ペア4。7S LiPo電圧、直列抵抗で電流制限
14極 | 6 | 下 | SW NC | SX(NE) 0.5sq×7P | 0.5sq | 18〜24AWG用 |  | ペア4の相手線。NC開で停止（外れ・断線も停止側）。受け側にフィルタ／デバウンス
14極 | 7 | 上 | LED＋ | SX(NE) 0.5sq×7P | 0.5sq | 18〜24AWG用 |  | ペア5。7S LiPo電圧、ポリスイッチで保護。最も端に配置
14極 | 7 | 下 | LED− | SX(NE) 0.5sq×7P | 0.5sq | 18〜24AWG用 |  | ペア5の相手線。電源基板GNDへ専用線で戻す
配置ルール（4極・14極共通）：1列＝1組（ペア）、上段＝行き（＋・信号）、下段＝戻り（−・GND）。③・②・①の3か所すべてをこの配置で作る
性別（4極・14極とも）：③後部ユニット＝メス（5557）、②ハーネス後部側＝オス（5559）、②ハーネス前部側＝メス（5557）、①前部ユニット＝オス（5559）
4極ハーネス（モーター）と14極ハーネス（信号）は別々に配線し、数cm離す（交差は直角に）。両端に「MOTOR」「SIGNAL」のラベルを付け、挿し忘れを防ぐ（大きさが違うため差し違えは起きない）
モーター電力と信号はハーネスごと分離されるため、20極構成の空き列（緩衝）は不要
5V・GNDは2本ずつ使い、①③の機器側（PM02／制御基板）でそれぞれ合流させる
色：オレンジ＝モーター電力、灰＝電源・GND、紫＝アナログ（0〜3.3V）、緑＝RC信号、ピンク＝7S LiPo電圧（電流制限あり）
MDDS30側（③）：ユニット側のAWG26単線をそのままDupont 1×3（中央5Vは空き）に圧着。RC右→RC1のSIG、RC左→RC2のSIG。信号GNDの線とドレインの線はMDDS30の手前で1点に合流させ（はんだ付け＋熱収縮チューブ）、AWG26の2本に分岐してRC1・RC2のGNDへ。分岐後は各RCの信号線とGND線を軽くより合わせる
SX(NE) 0.5sq×7P 芯線割り当て（7ペア・14本、すべて使用・予備なし）
ペア | 芯線の色（現物で記入） |  | 芯線1の信号 | 芯線1のピン（列・段） |  | 芯線2の信号 | 芯線2のピン | 備考
1 |  |  | RC右 | 列4・上 |  | 信号GND | 列5・上 | RC右の帰り線。ペア2の相手線と2本を1個の端子にダブル圧着。③側はユニットのAWG26線でドレインと合流後、RC1のGNDへ
2 |  |  | RC左 | 列4・下 |  | 信号GND | 列5・上 | RC左の帰り線。ペア1の相手線とダブル圧着。③側はユニットのAWG26線でドレインと合流後、RC2のGNDへ
3 |  |  | 5V | 列1・上 |  | GND | 列1・下 | 5V電流の行きと戻りを1ペアに
4 |  |  | SW COM | 列6・上 |  | SW NC | 列6・下 | 非常停止スイッチ。7S LiPo電圧（直列抵抗で電流制限）
5 |  |  | LED＋ | 列7・上 |  | LED− | 列7・下 | スイッチのLED。7S LiPo電圧（ポリスイッチで保護）
6 |  |  | CURRENT | 列3・上 |  | VOLTAGE | 列3・下 | 0〜3.3Vアナログ。基準は信号GND（ペア1・2の相手線）
7 |  |  | 5V（2本目） | 列2・上 |  | GND（2本目） | 列2・下 | ペア3と並列。両端の機器側で合流
ドレイン線（裸線）：どの芯線ともつながず、単独で1個の端子に圧着して列5・下へ。外被を剥いだ所から端子の手前まで熱収縮チューブ（φ1.5mm程度）で絶縁する
ドレインの接地はMDDS30側（③）のみ。②ハーネスでは両端ともドレイン線をドレインピンに圧着し、③ユニット側でAWG26線を出して信号GNDと合流させる。①ユニット側はドレインのキャビティを空けたまま（未接続）。シールド（編組）は両端で根元から切りそろえ、熱収縮チューブで覆う
14極コネクタの内訳：芯線14本で13ピン（信号GNDは2本で1ピン）＋ドレイン1ピン＝14ピン。空きピン・予備芯線はない
芯線の色はSX(NE)の現物で確認し、上の表の「芯線の色」列に記入してから圧着する
ユニット側（①前部・③後部）の配線（コネクタから各機器まで、各約10cm）
コネクタ | 信号 |  |  | 電線 | 端子 |  | 本数 | 接続先・備考
4極 | 右M＋・右M−・左M＋・左M− |  |  | AWG16（エーモンAV1.25 赤・黒） | 5556T3L／5558T3L |  | 4 | ③：MDDS30のモーター出力、①：左右モーター。赤＋／黒−をより合わせ、マーカーで「R」「L」
14極 | 5V×2・GND×2・CURRENT・VOLTAGE |  |  | AWG26単線（住友電工 UL1571） | 5556T2L／5558T2L |  | 6 | ③：PM02 V3、①：Pixhawk 6C Mini POWER1。機器側はJST GH 6ピン（GHR-06V-S＋SSHL-002T-P0.2）を自分で圧着。GHの並び：1・2＝5V、3＝CURRENT、4＝VOLTAGE、5・6＝GND。前部5Vの見込み：1Aで約5.15V、3Aで約4.98V
14極 | RC右・RC左・信号GND |  |  | AWG26単線（住友電工 UL1571） | 5556T2L／5558T2L |  | 3 | ③：MDDS30のRC1・RC2（Dupont 1×3）、①：PWM出力側。信号線とGND線を軽くより合わせる
14極 | ドレイン |  |  | AWG26単線（住友電工 UL1571） | 5556T2L（③のみ） |  | ③のみ1 | ③：MDDS30の手前で信号GNDと合流。①：キャビティを空けたまま（未接続）
14極 | SW COM・SW NC・LED＋・LED− |  |  | AWG24単線（UL3265、150V） | 5556T2L／5558T2L |  | 4 | 7S LiPo電圧（最大29.4V）のため150V定格のAWG24を使う（AWG26のUL1571は30V定格で余裕がない）。COM＋NC、LED＋＋LED−をそれぞれ軽くより合わせる
端子：②ハーネス側（SX(NE) 0.5sq）は5556TL／5558TL、①③ユニット側（AWG26・AWG24）は5556T2L／5558T2L（被覆外径0.90〜1.80mm：AWG26 0.98mm、AWG24 1.21mmとも適合）。機器側のGH端子SSHL-002T-P0.2は被覆外径0.8〜1.0mmで、AWG26（0.98mm）は上限付近
コネクタの後ろ数cmは熱収縮チューブかスパイラルチューブでまとめて結束バンドで固定し、端子の根元に曲げがかからないようにする（AWG26は振動で根元から切れやすい）

Sheet: 条件
ハーネス部品 購入リスト：計算条件
黄色のセル（青字）が入力欄です。値を変えると「購入リスト」の数量が自動で再計算されます。
項目 | 値 | 単位 | 根拠・備考
中継コネクタ位置の数（各サイズとも） | 2 | 組 | ③-②間、②-①間の2か所。4極・14極それぞれ同数
1コネクタあたりのモーター用ピン数（AWG16） | 4 | 本 | 右M＋、右M−、左M＋、左M−
14極コネクタ1個あたりのピン数 | 14 | 本 | 5V×2、GND×2、CURRENT、VOLTAGE、RC右、RC左、信号GND、ドレイン、SW COM、SW NC、LED＋、LED−。②ハーネス側はTL端子（SX(NE)）、①③ユニット側はT2L端子（AWG26）
端子の購入倍率（練習・試験・予備分） | 2.5 | 倍 | 圧着の練習と引っ張り試験用の余裕
②ハーネスの長さ | 0.6 | m | ユーザー提示の50〜60cmの上限
①前部ユニットの引き出し長さ | 0.1 | m | ユーザー提示の約10cm
③後部ユニットの引き出し長さ | 0.1 | m | ユーザー提示の約10cm
電線の購入倍率（試作・作り直し分） | 2 | 倍 | 作り直しに備えた余裕
モーター線の本数 | 4 | 本 | 左右×＋/−
編組スリーブの長さ倍率 | 1.2 | 倍 | 端部処理・取り回し分
ケーブルクランプの数 | 6 | 個 | 仮定値。各コネクタの前後＋途中2か所
1区間あたりの電線長（①＋②＋③） | 0.8 | m
