sonatine726/MizuniGoal_PowerController_Docs/BOM-Mizunigoal_PowerController_v3_0_0.csv

Comment | Designator | Footprint | LCSC | Quantity
0.15uF | C16 | C_0603_1608Metric | C513735 | 1
0.33uF | C6 | C_0603_1608Metric | C282682 | 1
0456030.ER | F1,F2 | FUSC10130X305N | C187558 | 2
0Ω | R47 | R_0603_1608Metric | C21189 | 1
100kΩ | R13,R33,R35,R37,R44,R46 | R_0603_1608Metric | C25803 | 6
100nF | C12,C20,C25,C26,C29,C31,C33 | C_0603_1608Metric | C14663 | 7
100nF(100V) | C28,C8 | C_0603_1608Metric | C15725 | 2
100pF(C0G/100V) | C3,C4 | C_0603_1608Metric | C44567 | 2
100Ω | R51 | R_0603_1608Metric | C22775 | 1
10kΩ | R1,R12,R18,R19,R41,R50 | R_0603_1608Metric | C25804 | 6
10nF | C22,C23 | C_0603_1608Metric | C57112 | 2
118kΩ | R17 | R_0603_1608Metric | C5126230 | 1
1206L010_60 | F3 | FUSC3216X125N | C18198325 | 1
13.3kΩ | R4 | R_0603_1608Metric | C25952 | 1
1MΩ | R14,R32,R34,R36,R42 | R_0603_1608Metric | C22935 | 5
1kΩ | R7 | R_0603_1608Metric | C21190 | 1
1nF(C0G) | C34,C35 | C_0603_1608Metric | C163508 | 2
1uF(100V/1210) | C11 | C_1210_3225Metric | C24365 | 1
1µF | C1,C13,C17,C2,C24 | C_0603_1608Metric | C15849 | 5
2.0kΩ | R30,R31 | R_0603_1608Metric | C22975 | 2
2.2kΩ | R40,R52,R53 | R_0603_1608Metric | C4190 | 3
2.2µF(100V/1210) | C27 | C_1210_3225Metric | C153036 | 1
200kΩ | R2 | R_0603_1608Metric | C25811 | 1
220Ω | R39,R48 | R_0603_1608Metric | C22962 | 2
22kΩ | R21 | R_0603_1608Metric | C31850 | 1
22nF(C0G/100V/1206) | C15,C9 | C_1206_3216Metric | C711005 | 2
22pF | C32 | C_0603_1608Metric | C1653 | 1
22µF(16V) | C30 | C_0603_1608Metric | C22367828 | 1
27kΩ | R8 | R_0603_1608Metric | C22967 | 1
3.3kΩ(1206) | R10 | R_1206_3216Metric | C26032 | 1
30.1kΩ | R45 | R_0603_1608Metric | C23000 | 1
33μH | L2 | IND-SMD_L5.4-W5.2 | C41413117 | 1
4.7µF(100V/1210) | C14 | C_1210_3225Metric | C381466 | 1
470Ω | R43 | R_0603_1608Metric | C23179 | 1
47uF(EEH-ZC1H470P) | C5,C7 | EEHZA1H680P | C454346 | 2
5.76kΩ | R3 | R_0603_1608Metric | C23070 | 1
6.8kΩ | R20 | R_0603_1608Metric | C23212 | 1
BAT46W | D11 | D_SOD-123 | C7420332 | 1
BSS138 | Q6 | SOT-23 | C7420339 | 1
BZT52C12(12V) | D9 | D_SOD-123 | C20622487 | 1
BSC028N06NS | Q1,Q2,Q3 | TDSON-8-1 | C148250 | 3
Conn_01x04_Pin | J4 | JST_XA_S04B-XASK-1_1x04_P2.50mm_Horizontal | C161668 | 1
Conn_01x06_Pin | J5 | JST_XA_S06B-XASK-1_1x06_P2.50mm_Horizontal | C491715 | 1
ES2D | D1 | D_SMB | C232831 | 1
ESD(5V) | D8 | D_SOD-882 | C85402 | 1
FDT3612 | Q4 | SOT230P700X180-4N | C20617897 | 1
LM397 | U2 | SOT-23-5 | C132076 | 1
LM5060MM | IC3 | SOP50P490X110-10N | C74456 | 1
LM74610QDGKRQ1 | IC1,IC2 | SOP65P490X110-8N | C2649431 | 2
LMR16006XDDCR | IC4 | SOT95P280X110-6N | C87080 | 1
MMBT3906 | Q5 | SOT-23 | C7420354 | 1
NCP21XV103J03RA(10kΩ) | TH1,TH2 | R_0805_2012Metric | C113141 | 2
SMAJ15A | D12 | D_SMA | C19077535 | 1
SMCJ33A | D3,D5,D7 | DIOM7959X262N | C42371548 | 3
SMCJ6.0A | D4,D6 | DIOM7959X262N | C42394420 | 2
SML-D13FWT86 | LED1,LED3 | SMLD15YWT86 | C459722 | 2
SS210(100V) | D10 | D_SMA | C14996 | 1
STM32C011F4P6 | IC6 | SOP65P640X120-20N | C5452432 | 1
TL431BIDBZR | U1 | DBZ0003A_N__mod | C41283 | 1
TPAN0263F200RK9(200Ω) | R11 | D2PAK_L10.1-W7.8-P5.08-LS15.3 | C39097133 | 1
PZ254V-11-05P | J6 | PinHeader_1x05_P2.54mm_Vertical | C492404 | 1
Jumper_2_Open | JP1 | SolderJumper-2_P1.3mm_Open_Pad1.0x1.5mm |  | 1
