sonatine726/MizuniGoal_PowerController_Docs/rover_harness_bom_plan1_20pin.xlsx

Sheet: 概要
案1：20極コネクタ×1
ハーネス構成（前後間）。端子・ケーブル・材料は両案共通。比較のための資料
コネクタ | Mini-Fit Jr. 20極（2×10）×1組（③-②間、②-①間で計2組）
ハウジング（モノタロウ、税込、10個入り） | 5557-20R（08561567）747円＋5559-20P（34886293）3,958円
ハウジング費用合計 | 4,705円
出荷 | 5559-20Pは出荷まで最大11日程度の表示
ピン構成 | モーター4本＋空き2本（緩衝）＋信号・電源14本
長所 | 挿す箇所が1か所で、挿し忘れが起きない。固定箇所も1か所
短所・注意 | 5559-20Pが高価で納期が長い。モーター電力と信号が同じハウジング内（空き列で緩衝）。パネル取付耳の有無は図面で確認
共通：端子 | 5556T3L／5558T3L（AWG16、モーター線）、5556TL／5558TL（AWG18〜24、信号）。すずめっき、各100個入り1パック
共通：ケーブル | モーター：エーモンAV1.25 赤・黒（自作ツイスト）／信号：SX(NE) 0.5sq×7P（ペア1〜7）
共通：性別 | ③後部ユニット＝メス(5557)、②ハーネス後部側＝オス(5559)、②ハーネス前部側＝メス(5557)、①前部ユニット＝オス(5559)

Sheet: 購入リスト
ハーネス部品 購入リスト（Molex Mini-Fit Jr. 版）
「必要数」「購入数」は式で計算されます。「確認」「購入」列はプルダウンで選択、「実際に購入した品番」は手入力してください。
No | 区分 | 部品名 | メーカー | 品番（例） | 仕様 | 必要数 | 購入数 | 単位 | 確認ポイント | 確認 | 購入 | 実際に購入した品番・備考
1 | コネクタ | メス側ハウジング 20極（レセプタクル） | 日本モレックス | 5557-20R（モノタロウ 08561567） | 20極リセプタクル、2×10、4.2mm、ナイロン66・UL94V-2、10個入り | 2 | 1 | パック | ③後部ユニットと②ハーネスの前部側に使用 | 未確認 | 未購入 | 必要数は個数、購入数はパック数（1パック10個）
2 | コネクタ | オス側ハウジング 20極（プラグ） | 日本モレックス | 5559-20P（モノタロウ 34886293） | 20極プラグ、2×10、4.2mm、ナイロン66・UL94V-2、10個入り（税込3,958円、出荷まで最大11日程度） | 2 | 1 | パック | パネル取付耳の有無を商品ページの図面で確認。耳があれば①前部ユニットをフレームにねじ止め可 | 未確認 | 未購入 | 必要数は個数、購入数はパック数（1パック10個）
3 | 端子 | メス端子 AWG16用 | 日本モレックス | 5556T3L（モノタロウ 75939272） | メス端子 AWG16用、すずめっき2.5µm、バラ品、100個入り | 8 | 1 | パック | すずめっきで統一。モーター線用 | 未確認 | 未購入 | 必要数は個数、購入数はパック数（1パック100個）
4 | 端子 | メス端子 AWG18〜24用 | 日本モレックス | 5556TL（モノタロウ 08561682） | メス端子 AWG18〜24用、すずめっき2.5µm、バラ品、100個入り | 28 | 1 | パック | すずめっきで統一。SX(NE)芯線・ドレインの被覆外径が適合範囲内か確認 | 未確認 | 未購入 | 必要数は個数、購入数はパック数（1パック100個）
5 | 端子 | オス端子 AWG16用 | 日本モレックス | 5558T3L（モノタロウ 75939333） | オス端子 AWG16用、すずめっき2.5µm、バラ品、100個入り | 8 | 1 | パック | すずめっきで統一。モーター線用 | 未確認 | 未購入 | 必要数は個数、購入数はパック数（1パック100個）
6 | 端子 | オス端子 AWG18〜24用 | 日本モレックス | 5558TL（モノタロウ 08561454） | オス端子 AWG18〜24用、すずめっき2.5µm、バラ品、100個入り | 28 | 1 | パック | すずめっきで統一 | 未確認 | 未購入 | 必要数は個数、購入数はパック数（1パック100個）
7 | 工具 | 圧着工具 16AWG用 | IWISS（手持ち品で代用） | SN-2549 ＋ 48Bダイス | AWG16は48Bダイスの1.0〜1.5sqの溝で圧着 | 0 | 0 | 本 | 試し圧着で確認：被覆側バレルの閉じ具合（モーター線の被覆外径2.7mm）、Molex仕様書の圧着高さ、引っ張り試験、ハウジングへの挿入 | 未確認 | 未購入 | 購入不要（手持ち品）。不良なら純正200218-2200または63811-1000を検討
8 | 工具 | 圧着工具 18〜24AWG用 | IWISS（手持ち品で代用） | SN-2549（標準ダイス） | AWG20はSN-2549の標準ダイスで圧着 | 0 | 0 | 本 | 試し圧着で確認：芯線・被覆の両バレルの巻き具合、引っ張り試験、ハウジングへの挿入 | 未確認 | 未購入 | 購入不要（手持ち品）
9 | 工具 | 端子取り外し工具 | Molex | 11-03-0044 | Mini-Fit Jr. 用エクストラクタ | 1 | 1 | 本 | ピン配置の修正、将来のDT移行に使用 | 未確認 | 未購入
10 | 電線 | モーター電力用 シールド付き4芯ケーブル | 大電 | ロボトップ(DPC3-SB/2517)AWG16(1.25sq)4c（モノタロウ 34967274、5m巻） | 1.25mm²×4芯、より線124/0.12、絶縁体外径2.7mm、仕上外径9.9mm、シールド付き、UL/c-UL 105℃、300V。左右モーターの±をまとめて通す | 0.0 | 0.0 | m | 各モーターの＋と−は対角の芯線同士で組む（スターカッド）。芯線の色の割り当てをピン配置シートに記録。シールドはMDDS30側（③の端）のみGNDに接続し、①②の区間は折り返して絶縁 | 未確認 | 未購入 | 今回は不採用（到着まで約1週間のため代替案2で先行）。将来の置き換え候補。5m巻×1（必要量2.4m）
10-代替1 | 電線 | モーター線 AWG16 シリコン線 赤黒（自作ツイスト）【No.10の代替案1】 | HaerknCbl（Amazon） | 16AWG/1.3Sq シリコンワイヤー 赤＋黒 2色セット（10mを選択） | 1.3sq、すずめっき銅より線、200℃、600V。赤を＋、黒を−に使い、左右モーター用に赤黒を2本ずつ自分でツイスト（2〜3cmに1回転） | 0 | 0 | セット | 被覆外径をノギスで測り試し圧着で確認。各色約2.6m必要（1本約1.3m×2本、ツイストの縮み込み）。色で左右を区別できないので、ツイスト直後に両端へR/Lのマーカーを付ける（No.18）。シリコン被覆は傷に弱いので角やクランプ部を保護 | 未確認 | 未購入 | 今回は不採用（代替案2を採用）
10-代替2 | 電線 | モーター線 AV1.25 車両用ビニル線 赤・黒（自作ツイスト）【No.10の代替案2】 | エーモン（モノタロウ） | 3470 AV1.25 6m（73991628）を赤・黒の2色で購入（黄・青は品切れ） | 1.25sq、素線50本のより線、耐油・耐候性ビニル、導体最高許容温度80℃、許容電流11.6A。赤＝＋、黒＝−で左右モーター用に2組ツイスト | 2 | 2 | 本（色） | 被覆外径（約2.7〜3mm）を測り5556T3L／5558T3Lで試し圧着。各色約2.6m必要（6mで余裕あり）。左右は色で区別できないため、No.18のマーカーチューブで「R」「L」を表示 | 未確認 | 未購入 | 【今回採用】赤・黒 各6m×1。No.10・代替案1は購入不要
11 | 電線 | 5V用 AWG20 電線（赤） | — | — | No.13のペア3で代用（購入不要） | 0.0 | 0.0 | m | ペア3の芯線の色の割り当てをピン配置シートに記録 | 未確認 | 未購入 | 購入不要（No.13のペア3）
12 | 電線 | GND用 AWG20 電線（黒） | — | — | No.13のペア3で代用（購入不要） | 0.0 | 0.0 | m | ペア3の芯線の色の割り当てをピン配置シートに記録 | 未確認 | 未購入 | 購入不要（No.13のペア3）
13 | 電線 | RC信号・5V・アナログ・非常停止SW用 シールド付きツイストペアケーブル | 太陽ケーブルテック（旧テイコク） | SX(NE) 0.5sq×7P（モノタロウ 2m巻 34956381。5m巻は同ページで選択） | 0.5mm²×7対、編組シールド＋ドレインワイヤ、絶縁体外径1.5mm、仕上外径9.9mm、許容電流5.4A、150V | 1.2 | 2.4 | m | ペア1：RC右＋信号GND、ペア2：RC左＋信号GND、ペア3：5V＋GND、ペア4：SW COM＋NC、ペア5：LED＋＋LED−、ペア6：CURRENT＋VOLTAGE、ペア7：5V＋GND（2本目）。芯線の色をピン配置シートに記録。信号GNDは2本を1端子にダブル圧着 | 未確認 | 未購入 | 必要量1.2m（1台分）は2m巻で満たす。作り直し分も見込むなら5m巻（注文コードは商品ページで確認）
14 | 材料 | 編組チューブ（PET編組スリーブ） | デンカエレクトロン | FL-12-5（モノタロウ 34658872、全長5m、最大径約24mm） | ポリエステルモノフィラメント、−75〜125℃、UL224、自己消火性。自然折径幅約12〜13mm | 1.0 | 1.0 | 本（5m） | 束の外径（ロボトップ案で約17.6mm、シリコン線案で13〜15mm）が最大径の5〜7割程度に収まるか確認。切り口ははんだごてで溶着し、熱収縮チューブで仕上げる。1m品は実長が短い場合があるので注意 | 未確認 | 未購入 | 5m巻×1（必要量約0.72m）。FL-9（最大径約17mm）はロボトップ案では小さすぎるため不採用
15 | 材料 | 熱収縮チューブ（パック品） | モノタロウ | 収縮チューブ パック品（モノタロウ 60981052） | 収縮前内径1.5/2.5/3.0/4.5/6.5/10.7/12.7mm 各1m×7本、2:1、−55〜125℃、600V | 1 | 1 | セット | 用途の目安：ドレイン線1.5mm、AV線ツイスト端10.7mm、SX(NE)外被端10.7〜12.7mm。編組チューブ端部（15〜18mm）はサイズ外のため布テープで止める | 未確認 | 未購入 | 代替：PANDUIT HSTT-YK1／YK2は各15cm×2本で量が不足するため不採用
16 | 材料 | ハーネス結束用テープ（布） | モノタロウ | テープ ハーネス結束用（モノタロウ 89826862） | ポリエステル布基材、アクリル系粘着剤、幅19mm×19.6m、厚さ0.3mm、−40〜105℃、手切り可 | 1 | 1 | 巻 | 10〜15cm間隔で束を固定。モーター線とSX(NE)を束の反対側に置く | 未確認 | 未購入 | 今回はこちらを購入。代替：キタコ ハーネステープ PVC 0900-755-07010（モノタロウ 73778959、幅19mm×20m、税込395円）
17 | 材料 | ケーブルクリップ（ねじ固定式） | TRUSCO | TCCシリーズ。同軸用：TCC0（適合径3.1mm、モノタロウ 48918886）。ハーネス用：束の外径測定後にサイズ決定（SX(NE) 7P採用で16〜18mm程度の見込み、19.4mm等） | ナイロン66、取付穴4.8mm（M4ねじ）、100個入り。適合径3.1〜36.7mmの12サイズ | 1 | 1 | 袋 | 同軸の外径を測り、3mmを超える場合は5mmサイズを選ぶ。ハーネス用は束より少し大きいサイズを選び、隙間は布テープで調整。締めすぎ注意（ナイロン割れ・同軸の潰れ） | 未確認 | 未購入 | TCC0×1袋を購入。ハーネス用サイズは未決定（束の外径測定後に追加購入）。M4ねじ・ナットは別途
18 | 材料 | マーカーチューブ（ビニールチューブ 白） | デンカエレクトロン | TB-3.2W（モノタロウ 34690083） | 内径3.2mm、肉厚0.45mm、軟質PVC、白、5m、−20〜60℃ | 1 | 1 | 本（5m） | 圧着前に電線へ通す。油性ペンで「R+」「R−」「L+」「L−」などと記入（必要に応じ透明熱収縮チューブで保護）。①②③の各端部に約1.5cm（最大24か所） | 未確認 | 未購入 | AV線が赤黒2色のみのため左右の区別に使用。「前部」「後部」は布テープ（No.16）に記入
集計
確認済の項目数 |  | 0 / 20
受領済の項目数 |  | 0 / 20
注記
・品番は公開されている販売店・メーカー資料で確認したもの（2026年10月時点）。購入前にMolexの製品ページで最新情報を確認してください。
・16AWG用端子の圧着工具・アプリケータは被覆外径別（1.80〜2.20mm、2.20〜2.45mm、2.60〜3.15mm）に分かれる。モーター線（ロボトップ4芯）の被覆外径は2.7mm。
・端子のめっきはオス・メスともすずめっきで統一する（すずと金を混ぜると、振動・水分によるフレッティング腐食や異種金属腐食で接触抵抗が上がる）。
・①③の引き出し長さとクランプ数は仮定値。「条件」シートで実寸に変更すると数量が更新される。

Sheet: ピン配置
20ピン中継コネクタ ピン配置（両方のコネクタで共通）
位置は2×10の配置案。実際のピン番号はハウジングの図面で確認し、「実際のピン番号」列に記入してください。
列 | 段 | 信号 | 電線 | AWG | 端子（メス側／オス側） | 実際のピン番号 | 備考
1 | 上 | 右M＋ | エーモンAV1.25（赤） | 1.25sq | 16AWG用 |  | 右モーターのツイストペア（赤＋／黒−）。両端にマーカー「R」
1 | 下 | 左M＋ | エーモンAV1.25（赤） | 1.25sq | 16AWG用 |  | 左モーターのツイストペア（赤＋／黒−）。両端にマーカー「L」
2 | 上 | 右M− | エーモンAV1.25（黒） | 1.25sq | 16AWG用 |  | 右モーターのツイストペア。マーカー「R」
2 | 下 | 左M− | エーモンAV1.25（黒） | 1.25sq | 16AWG用 |  | 左モーターのツイストペア。マーカー「L」
3 | 上 | 空き | — | — | — |  | 緩衝用。端子は挿さない
3 | 下 | 空き | — | — | — |  | 緩衝用。端子は挿さない
4 | 上 | 5V | SX(NE) 0.5sq×7P | 0.5sq | 18〜24AWG用 |  | ペア3。BEC（後部）からPixhawk等（前部）へ
4 | 下 | GND | SX(NE) 0.5sq×7P | 0.5sq | 18〜24AWG用 |  | ペア3の相手線。5V電流の戻り
5 | 上 | 5V（2本目） | SX(NE) 0.5sq×7P | 0.5sq | 18〜24AWG用 |  | ペア7。電圧降下を半減するため列4の5Vと両端で並列接続
5 | 下 | GND（2本目） | SX(NE) 0.5sq×7P | 0.5sq | 18〜24AWG用 |  | ペア7の相手線。列4のGNDと両端で並列接続
6 | 上 | CURRENT | SX(NE) 0.5sq×7P | 0.5sq | 18〜24AWG用 |  | ペア6。0〜3.3Vアナログ。25Vの線から離して配置
6 | 下 | VOLTAGE | SX(NE) 0.5sq×7P | 0.5sq | 18〜24AWG用 |  | ペア6の相手線。0〜3.3Vアナログ。基準は信号GND
7 | 上 | RC右 | SX(NE) 0.5sq×7P | 0.5sq | 18〜24AWG用 |  | ペア1
7 | 下 | RC左 | SX(NE) 0.5sq×7P | 0.5sq | 18〜24AWG用 |  | ペア2
8 | 上 | 信号GND | SX(NE) 0.5sq×7P | 0.5sq | 18〜24AWG用（2本圧着） |  | ペア1・2の相手線をダブル圧着。RC信号とアナログ信号の基準
8 | 下 | ドレイン | SX(NE) 0.5sq×7P | — | 18〜24AWG用 |  | 接地はMDDS30側（③の端）のみ。①の端では接続しない
9 | 上 | SW COM | SX(NE) 0.5sq×7P | 0.5sq | 18〜24AWG用 |  | ペア4。7S LiPo電圧、直列抵抗で電流制限
9 | 下 | SW NC | SX(NE) 0.5sq×7P | 0.5sq | 18〜24AWG用 |  | ペア4の相手線。NC開で停止（外れ・断線も停止側）。受け側にフィルタ／デバウンス
10 | 上 | LED＋ | SX(NE) 0.5sq×7P | 0.5sq | 18〜24AWG用 |  | ペア5。7S LiPo電圧、ポリスイッチで保護。最も端に配置
10 | 下 | LED− | SX(NE) 0.5sq×7P | 0.5sq | 18〜24AWG用 |  | ペア5の相手線。電源基板GNDへ専用線で戻す
性別：③後部ユニット＝メス（5557）、②ハーネス後部側＝オス（5559）、②ハーネス前部側＝メス（5557）、①前部ユニット＝オス（5559）
5V・GNDは2ピンずつ使い、①③の基板側でそれぞれ並列に接続する（電圧降下の検討は current_voltage_addition_review.xlsx）
組立後にハーネス込みでArduPilotの電圧・電流を校正（BATT_VOLT_MULT、BATT_AMP_PERVLT、BATT_AMP_OFFSET）
将来ロボトップ4芯に置き換える場合：右モーター＝赤＋／黒−、左モーター＝白＋／緑−（断面で対角の芯線同士）
色：オレンジ＝モーター電力、灰＝電源・GND、紫＝アナログ（0〜3.3V）、緑＝RC信号、ピンク＝7S LiPo電圧（電流制限あり）

Sheet: 条件
ハーネス部品 購入リスト：計算条件
黄色のセル（青字）が入力欄です。値を変えると「購入リスト」の数量が自動で再計算されます。
項目 | 値 | 単位 | 根拠・備考
中継コネクタの組数 | 2 | 組 | ③後部メス―②ハーネス―①前部オス の2か所
1コネクタあたりのモーター用ピン数（AWG16） | 4 | 本 | 右M＋、右M−、左M＋、左M−
1コネクタあたりの信号・5V用ピン数（AWG20） | 14 | 本 | 5V×2、GND×2、CURRENT、VOLTAGE、RC右、RC左、信号GND、ドレイン、SW COM、SW NC、LED＋、LED−
端子の購入倍率（練習・試験・予備分） | 2.5 | 倍 | 圧着の練習と引っ張り試験用の余裕
②ハーネスの長さ | 0.6 | m | ユーザー提示の50〜60cmの上限
①前部ユニットの引き出し長さ | 0.3 | m | 仮定値。実寸に合わせて変更してください
③後部ユニットの引き出し長さ | 0.3 | m | 仮定値。実寸に合わせて変更してください
電線の購入倍率（試作・作り直し分） | 2 | 倍 | 作り直しに備えた余裕
モーター線の本数 | 4 | 本 | 左右×＋/−
編組スリーブの長さ倍率 | 1.2 | 倍 | 端部処理・取り回し分
ケーブルクランプの数 | 6 | 個 | 仮定値。各コネクタの前後＋途中2か所
1区間あたりの電線長（①＋②＋③） | 1.2 | m
