sonatine726/MizuniGoal_PowerController_Docs/MizuniGoal_PowerController_v3_0_0_試験記録シート_rev2.xlsx

Sheet: 表紙・凡例
MizuniGoal Power Controller v3.0.0 試験記録シート
7S4P LiPo 2並列ホットスワップ電源基板／マイコン保護化（v2.1.1 → v3.0.0）
基板情報
基板 No. | 3 号機（v3.0.0 初号基板。1 号機は 2026-10-08 に Q3 破壊、2 号機は v2.1.1 のまま試験用に保持）
基板バージョン | v3.0.0
実装日
実装方法 | PCBA（SMD 118 点、J7 を含む）＋ 手実装／THT（J1 / J2 / J3 / J4 / J5 / J6 / J8 の 7 点）
銅厚 | 1oz
表面仕上げ | ENIG
ファームウェア版数
試験実施者
試験実施日
凡例
黄色セル | 記入欄。ここだけ入力してください
灰色セル | 自動計算。数式が入っているので編集しないでください
橙色の行 | 安全上の注意または手順の順序に関する警告
判定列 | OK / NG / 未実施 をドロップダウンから選択
安全上の注意・ブリングアップ手順
★【最重要・ブリングアップ】マイコンが未書込みの基板は Vout が出ません。これは故障ではなく設計どおりです。未書込みのチップは GPIO が Hi-Z のため PA5（SHDN_REQ）が浮き、R42（1MΩ）が EN_GATE を +3V3 へ引き上げて Q6（BSS138）が ON になり、EN が GND に落ちて LM5060 が遮断します。JP1 をはんだブリッジすると EN_GATE が GND に固定され Q6 が強制 OFF になるので、ファームウェアが無い状態でも電源部だけを単体で動かせます。★ 書き込み後は必ず JP1 を開放に戻してください。ブリッジしたままだとマイコンによる遮断（サーマル保護・短絡検出・非常停止のソフト側）が一切効きません。
★ 出力（Vout − GND）を短絡させないこと。1 号機はこれで Q3 のゲート酸化膜が破壊されました。電源の電流制限は無関係で、上流コンデンサの電荷（MDDS30 接続時 1.45J）が原因です。v3.0.0 では R51 / D12 を追加しましたが、MDDS30 を接続した状態での短絡はなお想定外です。MDDS30 の端子付近でプローブを扱う作業は、必ず電源を落とし放電してから行ってください。
・7S LiPo は短絡時に数百 A を供給します。フェーズ 0〜5 は可変電源（電流制限付き）で確認し、パック接続はフェーズ 7 以降にしてください。
・VB+ / VB− をドライバ等の金属で短絡しないこと。29V は感電しない電圧ですが、1.45J は工具の先端を溶着させるのに十分です。
・フェーズ 7 の 25A ストール試験では消火器を手元に置き、目を離さないこと。初回は 15A 程度から段階的に上げてください。
・R11（200Ω）の連続導通は 5.2W。実効熱抵抗 18℃/W 前後（v2.1.1 実測）では周囲 65℃ で平衡 158℃ となり最高使用温度 150℃ を超えます。試験時は 120℃ を上限に中止してください。v3.0.0 では TH2 とファームウェア #5 / #6 がこれを止める構成ですが、その保護自体を検証する試験（5-6 / 5-16）では必ず温度を監視してください。
・11-8 の LED 線短絡試験と 5-11 の出力短絡試験は意図的な短絡です。必ず電流制限付き電源で、パックと MDDS30 を外して実施してください。
・フェーズ 3 以降は、待機電流測定を除き非常停止ボタンを解除（スイッチ ON）した状態で実施してください。J4 の接点は NC で、押下中は EN 経路が開いて Vout が出ません。
・SWD デバッグ中にブレークポイントで止めると、GPIO の出力レジスタは保持されるため PA5 は Low（運転）のままで、サーマル監視ループだけが停止します。MDDS30 を外すか電流制限付き電源で行い、モータを繋いだまま長時間ブレークしないこと。
・互換 ST-LINK には 3.3V の隣に 5V が出ているものがあります。J6 を 1 ピンずらして挿すと 3.3V レールに 5V が入り IC6 が破壊されます。pin1（角パッド側・上端）の位置をシルクで必ず確認してください。J6 は v3.0.0 では PCBA で実装済みです。
試験の実施順序
フェーズ | シート | 電源 | パック | 実施条件
0 | 0_通電前確認 | なし | なし | 無通電。ここで異常があれば通電しない
1 | 1_3.3V電源 | 可変電源 12〜35V / 0.3A 制限 | なし | ★ Vout は出ない状態で実施（これが正常）
2 | 2_MCU書き込みと基本動作 | 可変電源 24V / 0.5A 制限 | なし | JP1 の扱いが本フェーズの要点
3 | 3_低電圧基本動作 | 可変電源 0〜35V / 0.5A 制限 | なし | MDDS30 未接続
4 | 4_起動波形 | 可変電源 29.4V / ★3A 以上 | なし | MDDS30 接続。電流制限不足は測定を無効にする
5 | 5_保護機能（マイコン） | 可変電源 24V / 0.5A 制限 | なし | 5-10 の短絡試験は MDDS30 も外す
6 | 6_Q3ゲート保護 | 可変電源 29.4V / 0.5A 制限 | なし | 6-4 は MDDS30 を外して実施
7 | 7_熱特性 / 8_ブレーキチョッパ | パックまたは大容量電源 | 接続 | 実走行。消火器を手元に
8 | 9_走行時総合 / 10_GND分離 / 11_外部スイッチ・LED | パック | 接続 | 実走行。11-7 のみ電流制限付き電源
— | 12_量産工程 / 13_量産記録 | 可変電源 24V / 0.2A 制限 | なし | ★試作では使わない。300 枚ロットの量産工程（全数 P-1〜P-7 ＋ 抜取り）
必要機材
機材 | 用途 | 必須度
オシロスコープ（2ch 以上） | 起動波形、チョッパ動作、回生プロファイル、3.3V の SW 波形とリプル | 必須
プローブ 2 本＋グランドスプリング | TP 隣接の GND を活かすため。3.3V のリプル測定にはスプリング必須 | 必須
デジタルマルチメータ | 電圧・抵抗の静的確認 | 必須
ST-LINK V2 / V3（または互換品） | IC6 の書き込みとデバッグ。4 線ケーブル（SWDIO / SWCLK / NRST / GND）を用意 | 必須
（予備）2.54mm ピンヘッダ 1×5 | J6 は PCBA で実装済み（XFCN PZ254V-11-05P / C492404）。破損時の交換用 | あれば有用
2ch 熱電対温度計（K型・細線プローブ2本） | Q1 / Q3 と TH1 の温度差 | 必須
サーマルカメラ | R11 のフランジ温度、基板上の熱の広がり、IC6 周辺温度 | 必須
LCR メータ（100Hz 測定が可能なもの） | MDDS30 の入力容量測定。1kHz では大容量電解を測れません | 必須
DMM の容量レンジ または LCR | 4-7 の TP5 − TP2 間容量（約 46.7nF）の確認 | 必須
可変電源（0〜35V、3A 以上、電流制限付き） | 段階確認と起動波形。★起動波形は 3A 以上必須（2-x 参照） | 必須
クランプメータ（30A 以上） | ストール電流の実測 | 必須
ヒートガン／ドライヤー | TH1 / TH2 の加熱試験 | 必須
温度計 | 筐体内周囲温度の実測 | 必須
ルーペ（8〜10倍、LED付） | 実装状態の確認 | 必須
1kΩ / 3W の放電抵抗（ブリーダ） | 試行間の MDDS30 入力容量の放電。時定数 3.6s、15 秒で 0.5V 以下 | 必須
電子負荷または抵抗負荷 | 段階的な負荷試験 | あれば有用
µA が読める電流計（または電源の µA 表示） | 待機電流（再計算後の暫定 460µA）の確認 | あれば有用

Sheet: 0_通電前確認
0_通電前確認
通電前に必ず実施。ここで異常があれば通電しないこと。0-2 / 0-6 / 0-7 / 0-10〜0-16 / 0-22〜0-24 は v3.0.0 で追加した項目です。
No. | 項目 | 手順・条件 | 測定点 | 設計値・判定基準 | 単位 | 実測値 | 判定 | 備考
0-1 | 目視確認 | ルーペで全部品を確認 | 基板全体 | ブリッジ・未はんだ・欠品・向き違いが無いこと。特に IC6（TSSOP-20、0.65mm ピッチ）と IC4（SOT-23-6） | —
0-2 | JP1 の状態 | 基板を目視。はんだブリッジの有無を見る | JP1 | ★ 初回は「開放」であることを確認。未書込みのまま通電すると Vout は出ないが、それが正しい状態（2-4 で確認する） | —
0-3 | 短絡確認 | DMM の抵抗レンジ | J1 の +/− 間 | 数百Ω以上。C5 / C7 の充電で表示が上昇し続けること（数Ωで止まる場合は短絡） | Ω
0-4 | 短絡確認 | 同上 | J2 の +/− 間 | 同上 | Ω
0-5 | 短絡確認 | 同上 | J3 の +/− 間 | 同上 | Ω
0-6 | 3.3V レールの短絡確認 | DMM の抵抗レンジ（無通電） | TP24 − TP32 | 数 kΩ 以上で、C30 / C24 / C25 の充電により上昇し続けること。数Ω で止まる場合は IC4 / IC6 / C30 のいずれかが短絡している | Ω
0-7 | 3.3V と VBUS の分離 | 同上 | TP24 − TP4 | OL または非常に高い値。導通していたら IC4 の実装不良 | —
0-8 | 導通確認 | DMM のダイオードレンジ | TP10 → TP4 | Q3 ボディダイオード方向で導通（約 0.5V） | V
0-9 | ビア確認 | 基板を透かして裏面を確認 | Q1/Q2/Q3 裏面 | はんだの染み出しが無いこと（テンティング成立） | —
0-10 | R51 の実装・値 | DMM の抵抗レンジ（無通電） | TP5 − IC3.10（GATE ピン） | 100Ω ±5%。ここが開放だと Q3 のゲートが駆動されない | Ω
0-11 | D12 の向き | DMM のダイオードレンジ | TP5 − TP10 | TP5 側が＋で OL（TVS の阻止方向）、逆向きで約 0.6〜0.9V の順方向。逆なら実装の向きが誤り | V
0-12 | D11 の向き | 同上 | R39.1（D11 カソード）− TP24 | TP24 側が＋で約 0.3V（順方向）、逆で OL。BAT46W のアノードが +3V3 側 | V
0-13 | EN プルダウン | DMM の抵抗レンジ（無通電、J4 開放） | TP7 − TP2 | 2.2kΩ 前後（R40 が実装されていること）。C12 の充電で安定するまで数秒かかる | kΩ
0-14 | EN_GATE プルアップ | 同上 | TP25 − TP24 | 1MΩ 前後（R42）。C20 の充電があるため上昇し続けてから安定する | MΩ
0-15 | SHDN_REQ 直列抵抗 | 同上 | TP28 − TP25 | 220Ω 前後（R48） | Ω
0-16 | JP1 の接続先 | 同上（JP1 開放状態） | JP1 pad1 − TP32 / pad2 − TP25 | pad1 が GND（0Ω）、pad2 が EN_GATE（0Ω）。pad1 − pad2 間は開放 | —
0-17 | Q4 ゲートプルダウン | 同上 | TP9 − TP12 | 100kΩ 前後（R13 が実装されていること） | kΩ
0-18 | VREF バイアス経路 | 同上 | TP8 − TP11 | 6.8kΩ 前後（R20 が 12V レールと VREF の間にあること）。C13 / C17 の充電で安定するまで数秒かかる | kΩ
0-19 | 分圧ノードの分離 | 同上 | TP15 − TP11 | OL、または表示が上昇し続けること。6.8kΩ 前後で安定したら R20 の接続先が誤っている | —
0-20 | F3 の導通 | 同上 | J3 の + 端子 − J4 pin1 | 1.6〜15Ω（PPTC の正常時抵抗）。C7 / C11 の充電の影響を受けるので安定後の値を読む | Ω
0-21 | J4 のピン配置 | 基板とコネクタを目視・導通確認 | J4 | pin1 Vout_after_PPTC / pin2 GND / pin3 EN_SWITCH / pin4 EN。★ v2.1.1 とピン機能は同じで、繋がるネットだけが 3.3V 系ロジックに変わった | —
0-22 | J6 のピン配置 | 基板とシルクを目視・導通確認 | J6 | pin1 +3V3 / pin2 SWDIO / pin3 SWCLK / pin4 NRST / pin5 GND。★ 1 ピンずれると 3.3V レールに 5V が入り IC6 が壊れる | —
0-23 | TH1 / TH2 の抵抗 | DMM の抵抗レンジ（無通電、室温） | TH1 / TH2 の両端 | 25℃ で 10.0kΩ ±5%（NCP21XV103J03RA）。室温が 25℃ でない場合は温度換算して確認 | kΩ
0-24 | TH2 と R11 の距離 | ノギスまたは目視 | TH2 − R11 | 5mm 程度離れていること。密着していると NCP21X の動作上限 125℃ を超える | mm
0-25 | R54 の実装・値 | DMM の抵抗レンジ（無通電） | IC6.17 − J5 pin6 | 100Ω ±5%（C22775）。★ ここが開放だと EXT_GPIO が J5 に出ない | Ω
0-26 | R73 の未実装確認 | DMM の抵抗レンジ（無通電） | J5 pin5 − J7 pin1 | 開放（OL）であること。★ R73 は DNP。実装されていると I_SENSE が PA4 に入り EXT_ADC1 の意味が変わる。PA4 側は C36 10nF のみが残る | —
0-27 | C64 / C69 の未実装確認 | ルーペで目視 | C64 / C69 | どちらも未実装（DNP）であること。C69 が載ると EXT_ADC1 の時定数が変わる。C64 は R74 / R75 が 0Ω のため載せても無効だが、載せる場合は R74 / R75 を抵抗値ありに変更すること | —
0-28 | J5 のピン配置 | 基板とシルクを目視・導通確認 | J5 | pin1 +3V3（R47 0Ω 経由）/ pin2 GND / pin3 I2C_SCL / pin4 I2C_SDA / pin5 EXT_ADC1（R73 DNP のため I_SENSE は来ない）/ pin6 EXT_GPIO（R54 100Ω 経由） | —
0-29 | J7 のピン配置 | 同上 | J7 | pin1 I_SENSE（U3 出力、R77 1kΩ 経由）/ pin2 ANALOG_SENSE_GND / pin3 VBUS バッファ出力（IC5、R76 1kΩ 経由）。JST GH 3極 SMD（C514175） | —
0-30 | J8 のピン配置 | 同上 | J8 | pin1 GND / pin2 VBUS_AUX。★ B2P-VH は垂直品（C160315）なのでハーネスの向きが v2.1.1 と変わる | —
0-31 | F4 の導通 | DMM の抵抗レンジ（無通電） | TP4 − J8 pin2 | 数Ω 以下（AEM F1206HI2000V063TM、2A / 63V 高インラッシュ）。開放なら VBUS_AUX が出ない | Ω
※ 0-6 / 0-7 は v3.0.0 で追加した項目です。3.3V レールが短絡したまま通電すると IC4 が過熱します。 ※ 0-25〜0-31 は 2026-10-21 に追加した項目です。2026-10-14 以降の設計変更（R54 / R70 / R73 / R74 / R75 / C64 / C69 / U3 / IC5 / J5 / J7 / J8 / F4）に対応します。
※ 0-10 / 0-11 は 2026-10-08 の Q3 破壊を受けて追加した R51 / D12 の実装確認です。どちらか一方でも欠けると、出力短絡時に Q3 のゲート酸化膜が再び破壊されます。
※ 0-13〜0-16 は EN フェイルセーフ経路の確認です。R42 が欠けると未書込み時に EN_GATE が浮いて遮断が不定になり、R40 が欠けると J4 断線時に EN が落ちません。
※ 0-18 / 0-19 は v2.0.0 で R20 の接続先を誤っていた箇所です。R20 の上端が 12V レールではなく分圧ノードに繋がっていたため、TL431 にバイアス電流が流れず VREF が立ちませんでした。
※ 抵抗レンジでの測定は、どの項目も「表示が安定してから読む」か「上昇し続けることを確認する」のどちらかです。0-3〜0-6 は上昇し続けることが正常、0-10 / 0-13〜0-15 / 0-18 / 0-20 / 0-23 は安定後の値が判定対象です。
※ 測定前に C5 / C7 を放電させてください。前の測定で充電が残っていると高い値が表示され、短絡を見逃します。

Sheet: 1_3.3V電源
1_3.3V電源（IC4 / LMR16006XDDCR）
可変電源を電流制限 0.3A に設定し、J1 に接続して実施。パックと MDDS30 は接続しない。★ このフェーズでは Vout は出ません（未書込みのフェイルセーフ動作で、正常です）。
No. | 項目 | 手順・条件 | 測定点 | 設計値・判定基準 | 単位 | 実測値 | 判定 | 備考
1-1 | 3.3V の立ち上がり | VBUS 12V、電流制限 0.3A。J4 は開放（非常停止を押した状態） | TP24 − TP32 | 3.307V ±3%（3.21〜3.41V）。R44 100kΩ / R45 30.1kΩ で 0.765 × (1 + 100/30.1) | V
1-2 | VBUS 依存性 | VBUS を 12 / 19.5 / 24 / 29.4 / 35V と変えて TP24 を読む | TP24 − TP32 | 全点で ±1% 以内（3.27〜3.34V）。変動するなら FB 分圧か IC4 の実装を疑う | V
1-3 | 出力リプル | VBUS 29.4V、AC カップリング、20MHz 帯域制限、グランドスプリング使用 | TP24 − TP32 | 設計 1.0mV（ΔIL 127mA / C30 22µF）。スイッチングスパイクを含め 30mVpp 以下 | mVpp
1-4 | スイッチング周波数 | L2 の IC4 側端子（SW_3V3）を観測。10× プローブ | L2.1 − TP32 | 0.7MHz ±15%（595〜805kHz）。X 版（0.7MHz）であることの確認 | kHz
1-5 | デューティ | VBUS 29.4V、同時観測 | L2.1 − TP32 | 11.25% 前後（3.307 ÷ 29.4）。ON 時間 161ns は規格最小 80ns の 2 倍 | %
1-6 | SW ノードのリンギング | VBUS 35V、SW 立ち上がりのピークを読む | L2.1 − TP32 | 60V（IC4 の SW 絶対最大）を超えないこと。超える場合は C27 / D10 のループが大きい | V
1-7 | SW ノードのループ確認 | 1-6 と同時。サーマルカメラまたは目視でも可 | C27 / D10 / IC4 | リンギングの周波数が 100MHz を大きく超えない。C27 → IC4.5 → IC4.6 → D10 → C27 が数 mm に収まっていること | MHz
1-8 | 3.3V 負荷電流（遮断時） | VBUS 29.4V、非常停止を解除（J4 接点 ON）、マイコン未書込みまたは PA5 = H | 電源の電流表示から換算、または L2 に直列で測定 | 約 15.9mA。内訳は EN チェーン 13mA（2.95V ÷ 220Ω、Q6 が ON で EN を 78mV に引くため）＋ MCU 等 1mA ＋ U3 INA240A2PW 1.8mA ＋ IC5 TLV9001 60µA。★ 2026-10-14 以降に U3 / IC5 を追加したため +1.9mA | mA
1-9 | 3.3V 負荷電流（運転時） | VBUS 29.4V、マイコン書込み済みで PA5 = L | 同上 | 約 8.0mA。MCU 2mA ＋ LED3 2.8mA ＋ EN ループ 1.22mA ＋ U3 INA240A2PW 1.8mA ＋ IC5 TLV9001 60µA。0.6A 定格に対し十分 | mA
1-10 | 3.3V 負荷電流（待機時） | VBUS 29.4V、非常停止を押した状態（J4 開放）、MCU は STOP | 同上 | 約 1.9mA（U3 INA240A2PW 1.8mA typ ＋ IC5 TLV9001 60µA）。2.5mA 以下。★ U3 / IC5 は +3V3 に常時接続で J4 / PA5 では切れない。J4 が開くと EN チェーンの 13mA のみが消える | mA
1-11 | IC4 の温度 | 1-8 の状態を 10 分継続 | IC4 パッケージ | 周囲＋10℃ 以内。15.9mA × 3.3V ÷ 効率 80% − 出力 = 約 13mW の損失 | ℃
1-12 | L2 の温度 | 同上 | L2 | 周囲＋5℃ 以内 | ℃
★ このフェーズでは Vout は出ません。3.3V レールは IC4 が VBUS（Q3 の前）から直接作っているため、Q3 が遮断されていても 3.3V は立ちます。Vout が出ないのは未書込み（または PA5 = H）によるフェイルセーフ動作で、正常です。
※ 1-8 の 13mA は設計仕様書に記載のない値です。EN_SRC 2.95V が R39 220Ω と Q6（Rds 約 6Ω）を通って GND に流れるため、遮断状態のほうが運転状態より 3.3V 負荷が重くなります。IC4 の 0.6A 定格に対しては問題ありませんが、長時間この状態で放置すると無駄に電力を消費します。待機させるときは非常停止を押して J4 を開放してください（1-10）。
※ 1-3 のリプルはグランドスプリングを使わないと測れません。10cm のグランドリードでは 0.7MHz のスイッチングノイズを拾って実際の 10 倍以上に見えます。
※ 1-6 で 60V を超える場合は、C27（2.2µF / 100V / 1210）と D10（SS210）の配置を見直してください。このループが IC4 周辺で最もノイズが大きい経路です。
※ IC4 の VIN 絶対最大は 65V、SW は 65V です。7S 満充電 29.4V に対し十分な余裕がありますが、1-6 のリンギング次第では SW が危険域に入ります。

Sheet: 2_MCU書き込みと基本動作
2_MCU 書き込みと基本動作（IC6 / STM32C011F4P6）
可変電源 24V・電流制限 0.5A。JP1 の扱いが本フェーズの要点です。2-4 → 2-5 → 2-6 の順を守ってください。
No. | 項目 | 手順・条件 | 測定点 | 設計値・判定基準 | 単位 | 実測値 | 判定 | 備考
2-1 | J6 の実装確認 | PCBA で実装済み。ルーペで目視 | J6 | 5 本すべてはんだ付けされ、角パッド側（上端）が pin1 = +3V3 であることをシルクで確認する。★ 1 ピンずれて挿すと 3.3V レールに 5V が入り IC6 が壊れるので、ケーブルを挿す前に必ず向きを確認 | —
2-2 | ST-LINK の給電方式判定 | ST-LINK を PC に挿し、基板に何も繋がない状態で VDD_TARGET 相当のピンと GND 間を測る | ST-LINK 側 | 3.3V = 出力型（互換品に多い）／0V = 入力型（純正）。★ 出力型の場合は 4 線ケーブル（SWDIO / SWCLK / NRST / GND）を使い、3.3V は繋がない | V
2-3 | SWD の認識 | VBUS 24V を投入し、ST-LINK で接続（4 線） | J6 | ST-LINK Utility / CubeProgrammer が STM32C011 を認識すること | —
2-4 | ★ 未書込み状態の確認 | VBUS 24V、JP1 開放、非常停止を解除。書き込み前に測る | TP25 / TP7 / TP10 | TP25（EN_GATE）＝ 3.3V、TP7（EN）＜ 0.1V、TP10（Vout）＝ 0V。★ Vout が出ないのが正常。R42 1MΩ が EN_GATE を引き上げ Q6 が ON になっている | V
2-5 | JP1 ブリッジ時の動作 | JP1 をはんだブリッジし、VBUS 24V を再投入 | TP25 / TP7 / TP10 | TP25 ＝ 0V、TP7 ＝ 2.68V、TP10 ＝ Vout が立ち上がる。ファームウェア無しで電源部だけを動かせる状態 | V
2-6 | ★ JP1 の開放 | 電源を落とし、JP1 のはんだブリッジを除去する | JP1 | 開放に戻したことを導通で確認（pad1 − pad2 が OL）。★ ブリッジしたままだとマイコンの遮断が一切効かない | —
2-7 | 書き込み | ファームウェアを書き込み、リセットする | J6 | 書き込みとベリファイが成功すること | —
2-8 | リセット直後の初期状態 | リセット後 10ms 以内を観測（Ch1 = TP28、Ch2 = TP10） | TP28 / TP25 / TP10 | TP28（SHDN_REQ）＝ 3.3V、TP25 ＝ 3.3V、Vout ＝ 0V。ファームウェア #1 の「PA5 = H で開始」 | V
2-9 | 運転への移行 | ADC 校正とセンサ読みが終わるまでの時間を測る | TP28 / TP10 | TP28 が Low に落ち、続いて Vout が立ち上がる。リセットから数十 ms 以内 | ms
2-10 | 運転時の EN 系電位 | VBUS 29.4V、運転中 | TP28 / TP25 / TP7 | TP28 ＝ 0V、TP25 ＜ 0.1V、TP7 ＝ 2.68V（設計値） | V
2-11 | EN_SRC 電圧 | 同上 | D11 カソード（R39.1）− TP32 | 2.95V（3.3V − BAT46W の VF 0.35V） | V
2-12 | NTC 駆動のデューティ | TP27 を 10ms/div で観測 | TP27 − TP32 | 50ms 周期で 0.5ms 幅の H パルス（デューティ約 1%）。ファームウェア #2 | ms
2-13 | TH1_SENSE の電圧 | TP27 が H の区間で TP26 を読む（オシロのカーソル、または SWD で ADC 値を読む） | TP26 − TP32 | 室温 25℃ で 2.750V ±5%。65℃ で 1.685V、95℃ で 0.950V | V
2-14 | TH2_SENSE の電圧 | 同上 | TP31 − TP32 | 同上（TH1 と同じ分圧定数） | V
2-15 | VBUS_SENSE の読み | SWD で ADC 値を読み、DMM の TP4 実測値と比較 | IC6.8 / TP4 | ADC 換算値 ＝ TP4 ÷ 11。29.4V で 2.673V。誤差 ±2% 以内 | V
2-16 | VOUT_SENSE の読み | 同上 | IC6.9 / TP10 | ADC 換算値 ＝ TP10 ÷ 11。誤差 ±2% 以内 | V
2-17 | LED3 の動作 | VBUS 29.4V（正常）と 20V（低電圧）で比較 | LED3（基板上） | 正常時は点灯または消灯（ファームウェア実装による）。VBUS < 21.0V で低速点滅（#9） | —
2-18 | マイコン能動遮断の応答 | SWD または試験コマンドで PA5 を H にし、TP7 の立ち下がりを観測（Ch1 = TP28、Ch2 = TP7） | TP28 / TP7 | TP7 が 0.8V を切るまで約 50µs（τ = R48 220Ω × C20 100nF = 22µs） | µs
2-19 | マイコン死亡時の遮断 | NRST（J6 pin4）を GND に保持し続ける。PA5 が Hi-Z になる | TP25 / TP10 | TP25 が上昇し、約 93ms 後に Vout が落ちること。R42 1MΩ × C20 100nF、Vgs 2.0V 到達まで | ms
2-20 | 短時間リセットのライドスルー | NRST に 2ms の Low パルスを与える | TP25 / TP10 | TP25 のピークが 65mV 程度に留まり、Vout が切れないこと。Vgs = 3.3(1 − e^(−2/100)) | mV
2-21 | STOP モード移行 | 非常停止を押して J4 を開放し、100ms 以上保持 | TP28 / 電源の電流表示 | #12 により STOP モードへ。待機電流が 3-10 の値（再計算後の暫定 460µA）まで下がること | µA
2-22 | STOP からの復帰 | 非常停止を解除する | TP10 / TP26 | EN が即座に立ち上がって Vout が出る。同時に EXTI で MCU が復帰し、数 ms 以内に TH1 を読むこと | ms
★ 2-4 → 2-5 → 2-6 の順を必ず守ってください。2-4 で「Vout が出ない」ことを確認しないまま 2-5 で JP1 をブリッジすると、フェイルセーフが働いているのか電源部が壊れているのかが切り分けられなくなります。また 2-6 で JP1 を開放に戻し忘れると、以降のフェーズ 5（保護機能）はすべて無意味になります。
※ JP1 は Jumper:SolderJumper-2_P1.3mm_Open_Pad1.0x1.5mm の基板パターンで、部品は実装しません（BOM にも載せません）。pad1 = GND、pad2 = EN_GATE です。
※ 2-5 で Vout が出ない場合、原因は JP1 より下流（IC3 / Q3 / UVLO）にあります。TP7 が 2.68V まで上がっているかで切り分けてください。TP7 が上がっていて Vout が出ないなら IC3 以降、TP7 が上がらないなら EN チェーン（D11 / R39 / J4 / R40）です。
※ 2-13 / 2-14 は PA7（NTC_DRV）が H の 0.5ms の間しか有効な電圧が出ません。DMM で測ると平均値（約 27mV）が読めるだけです。オシロのカーソルか、SWD で ADC の生値を読んでください。
※ 2-18 の 50µs は v2.1.1 の非常停止応答 266µs（ハードウェア経路）より速い値です。どちらも設計どおりで、ソフト経由のほうが C20 が小さく見えるぶん速くなります。
※ 2-19 の 93ms は「マイコンが死んでも 93ms で自動遮断される」という設計の核です。ここが測れないと故障モード表の「マイコン未書込み／死亡 → 安全」が検証できません。
※ 2-20 と 2-19 は同じ回路の両面です。2ms のリセットでは切れず（走行継続）、恒久的な死亡では 93ms で切れる。C20 100nF がこの境目を決めています。
※ デバッグビルドでは IWDG をフリーズ（DBGMCU_APB_FZR1 の DBG_IWDG_STOP）し、ファームウェア #11（IWDG リセット 3 回でラッチ）を無効化してください。有効のままだとブレークのたびに誤発火します。

Sheet: 3_低電圧基本動作
3_低電圧基本動作
可変電源を電流制限 0.5A に設定し、J1 に接続して実施。パックと MDDS30 はまだ接続しない。マイコンは書込み済み・JP1 開放の状態で行うこと。3-10 を除き、非常停止ボタンは解除（スイッチ ON）の状態で実施。
No. | 項目 | 手順・条件 | 測定点 | 設計値・判定基準 | 単位 | 実測値 | 判定 | 備考
3-1 | UVLO 遮断→復帰 | 電源電圧を 0V から徐々に上げる（非常停止は解除状態） | TP10 / TP19 | 19.5V 付近で Q3 が ON | V
3-2 | UVLO ヒステリシス | 電圧を徐々に下げる（同上） | TP10 / TP19 | 17.4V 付近で OFF（v2.1.1 実測 17.95V） | V
3-3 | OVP 遮断 | 電圧を 35V まで上げる（同上） | TP10 / TP19 | 34.0V 付近で OFF。★ 32.2V でチョッパが導通して R11 が 5.2W を食うので速やかに通過させる | V
3-4 | OVP 復帰 | 電圧を下げる（同上） | TP10 / TP19 | 30.1V 付近で復帰 | V
3-5 | 非常停止スイッチ | ボタンを押す／ひねって解除 | TP10 / TP19 | 押すと OFF、解除で ON（NC 接点） | —
3-6 | 非常停止の応答時間 | 押した瞬間を観測（Ch1 = TP7、Ch2 = TP10） | TP7 / TP2 | TP7 が 0.8V を切るまで約 266µs（τ = R40 2.2kΩ × C12 100nF = 220µs、2.68V → 0.8V） | µs
3-7 | EN 電圧（運転時） | 25℃、バス 29.4V、非常停止解除 | TP7 / TP2 | 2.68V。★ v2.1.1 の 3.9V（D8 クランプ）から変わった。3.3V 系ロジックになったため | V
3-8 | EN 電圧（Q6 ON 時） | PA5 = H またはマイコン未書込み | TP7 / TP2 | 78mV（2.95V × 6Ω ÷ 226Ω）。ENTHL 0.8V を十分下回る | mV
3-9 | LED1 点灯 | Q3 が ON の状態（同上） | LED1（基板上） | 点灯すること（NPGD が Low） | —
3-10 | 待機電流 | 非常停止ボタンを押した状態、バス 29.4V、MCU は STOP | 電源の電流表示 | 約 460µA（暫定）。★ v2.1.1 の 60µA から増加。v3.0.0 設計値 203µA に、U3 INA240A2PW 1.8mA ＋ IC5 TLV9001 60µA を IC4（効率 80%）経由で VBUS 29.4V 側に換算した 261µA を加算。内訳は 1-8〜1-10 を参照 | µA
3-11 | VBUS センス分圧の確認 | VBUS 29.4V | TP4 / IC6.8 | IC6.8 ＝ TP4 ÷ 11 ＝ 2.673V。R32 1MΩ / R33 100kΩ | V
※ 3-1〜3-4 が設計値と大きくずれる場合、R2 / R3 / R4 の実装と値を確認してください。これらは v2.1.1 から変更していません。
※ 3-7 は v2.1.1 からの最大の変更点です。v2.1.1 の EN は VBUS からの分圧で D8（BZT52C3V9）が 3.9V にクランプしていました。v3.0.0 は +3V3 → D11 → R39 220Ω → J4 → R40 2.2kΩ の 3.3V 系ロジックで、D8 は ESD 保護に役割が変わっています。
※ 3-8 は 1-8 と同じ状態の別の見方です。TP7 が 78mV のとき EN チェーンには 13mA が流れています。
※ 3-10：外部 LED は Vout から駆動されるため、遮断時は消灯し待機電流に加算されません。
※ J4 の接点は NC（ノーマルクローズ）です。非常停止ボタンが押された状態では EN 経路が開いており、Vout は出ません。3-1〜3-9 は必ずボタンを解除してから実施してください。
※ J4 にスイッチを接続せずに試験する場合は、pin3 − pin4 間を短絡して接点 ON を模擬してください。開放のままでは Vout が立ち上がりません。
※ v2.1.1 の 9_ENしきい値選別（EN しきい値による遮断点の選別試験）は v3.0.0 では不要になりました。遮断点が LM5060 の EN しきい値ばらつき（0.80〜2.00V）ではなくファームウェアの定数で決まるためです。EN は 2.68V と 78mV の 2 値だけを取り、どちらも ENTHH 2.00V / ENTHL 0.80V から十分離れています。

Sheet: 4_起動波形
4_起動波形
MDDS30 を接続して実施。★電源の電流制限は 3A 以上に設定すること（突入 2A）。不足すると UVLO リトライで階段状の波形になり、測定が無効になる。
No. | 項目 | 手順・条件 | 測定点 | 設計値・判定基準 | 単位 | 実測値 | 判定 | 備考
4-1 | MDDS30 入力容量 | 電源を切り放電した状態で VB+/VB− 間を 100Hz で測定 | MDDS30 | 参考値。v2.1.1 実測 3580〜3628µF | µF
4-2 | ゲート立ち上がり | 非常停止を解除、Ch1 = TP5（GND:TP18）。10× プローブ、レンジは VBUS＋15V 以上 | TP5 / TP18 | 終値 VBUS＋12V（10〜14V）。★ TP5 は R51 の Q3 側なので、ここが真の Q3 ゲート電位。R51 の DC 降下は 24µA × 100Ω = 2.4mV で無視できる | V
4-3 | Vgs 終値（判定） | 4-2 と同時。Ch1 = TP5、Ch2 = TP10 の差 | TP5 − TP10 | 10〜14V（typ 12V）。1 号機 11.8V / 2 号機 12.0V | V
4-4 | Vout 立ち上がり | 同時観測、Ch2 = TP10（GND:TP19） | TP10 / TP19 | VBUS 29.4V で 42〜87ms（I_gate 17〜31µA、C_gate 44〜50nF）。typ は 57.2ms = 46.7nF × 29.4V ÷ 24µA。★ 旧 typ 53.9ms は C9+C15 の 44nF のみで計算しており、Q3 の Ciss 2.7nF を含んでいなかった | ms
4-5 | 突入電流 | 4-4 の傾きから算出（推奨）。I = C_total × dV/dt | 入力配線 | 1.98A（1.4〜2.6A）、上限 2.4A。C_total = MDDS30 3628µF ＋ C7 47µF ＋ C11 1µF | A
4-6 | TIMER 波形 | 起動時の TIMER ピン電圧。時間軸 100ms/div（1 秒窓）で 2 本目のランプまで撮る | TP6 / TP2 | ピークが 2.0V（ラッチ電圧）に達しないこと。★ ランプの傾きも読むこと：12.5mV/ms 前後なら I_TIMERL 6µA（正常、ラッチまで 160ms）、23mV/ms 前後なら I_TIMERH 11µA に入っており余裕が 87ms に落ちる | V
4-7 | TP5 − TP2 間容量 | 電源を切り MDDS30 を放電した状態で DMM の容量レンジまたは LCR で測る | TP5 − TP2 | 約 46.7nF（C9 22nF ＋ C15 22nF ＋ Q3 の Ciss 2.7nF typ）。60〜65nF なら C9 / C15 が設計より大きい | nF
4-8 | 起動の単調性 | 4-2 / 4-4 の波形を目視 | TP5 / TP10 | 階段状・ハンチングが無いこと。出る場合は電源の電流制限不足（3A 以上に設定） | —
★ 電源の電流制限は 3A 以上に設定すること（突入 2A、29.4V × 2A = 59W が瞬間的に必要）。不足すると UVLO リトライで階段状の波形になり測定が無効になります。2026-10-08 午前の測定はこれで無効になりました。
※ v3.0.0 では R51 が IC3.GATE と Q3 のゲートの間に入ったため、TP5 の意味が変わりました。TP5 は /Gate_HV_1（Q3 のゲート、R51 の下流）で、C9 / C15 は Net-(IC3-GATE)（R51 の上流）側にあります。つまり TP5 − TP10 が真の Vgs で、v2.1.1 より測定点として適切になっています。
※ 4-7 の容量測定は R51 を挟んでいますが、DMM / LCR の測定周波数（概ね 100Hz〜1kHz）では 44nF のインピーダンスが 3.6kΩ 以上あり、R51 100Ω は無視できます。したがって約 46.7nF が読めます（v2.1.1 の CSD18540Q5B 時代は約 48.4nF）。
※ ゲート波形は 3 段階になります。(1) 0→約3V で Q3 がオン開始 (2) ミラー期間：Vgs が 3〜4V で平らなまま、GND 基準の TP5 は Vout と一緒に上昇（ここが t_rise） (3) Vout が VBUS に達した後、さらに 12V 分だけ上がって VBUS＋12V で停止。
※ 立ち上がり時間はゲート容量とゲート電流だけで決まり、負荷容量には依存しません。負荷容量が効くのは突入電流です。
※ 試行の間に MDDS30 の VB+ / VB− を 1kΩ / 3W で 15 秒（100Ω / 5W なら 2 秒）放電し、DMM で 0.5V 以下を確認してから次の測定に移ってください。残留電荷があると立ち上がり時間が短く出ます。★ DMM の電流レンジで放電しないこと（1.45J でヒューズが飛びます）。
★ Q1〜Q3 を BSC028N06NS に変更したことで Vgs(th) が 1.9V から 2.8V typ / 3.3V max に上がりました。起動中のミラープラトー電圧はおおよそ Vgs(th) で決まるため、最悪 3.6〜4.0V 程度まで上がります。LM5060 の TIMER 充電電流は VGS < 5V で I_TIMERL 6µA、VGS > 5V で I_TIMERH 11µA に切り替わるので、5V までの余裕が 3V から約 1V に減りました。まだ 6µA 側のはずですが、4-6 でランプの傾きを必ず読んでください。11µA に入っているとラッチまでが 160ms → 87ms に落ち、最悪条件の立ち上がり 82ms に対する余裕が 1.95 倍から 1.06 倍になります。その場合の対処は C9 / C15 の減量です（C16 の増量は短絡時の遮断を遅くするため不可）。
※ 2 号機（v2.1.1）の実測では Vout 立ち上がり 102ms で許容上限 87ms を 17% 超過しました。逆算ゲート電流 12.7µA は規格下限 17µA を下回り、原因は (a) C9＋C15 が設計の 44nF より大きい (b) IC3 の個体差 のいずれかです。v3.0.0 基板では 4-7 で先に容量を測っておくと切り分けが速くなります。
※ TIMER 容量は 0.48µF 据え置きです（設計仕様書 5_定数と根拠）。0.66µF に増やすと起動余裕は 1.31 → 1.81 倍になりますが、短絡時の遮断が 106 → 145ms に悪化するため不採用としました。短絡の高速検出はファームウェア #13（2ms）と R51 / D12 が担います。

Sheet: 5_保護機能（マイコン）
5_保護機能（マイコン）
判定は温度そのもので行う。v2.1.1 では EN 電圧で判定していたが、v3.0.0 は遮断点がファームウェアの定数で決まるため温度が直接の判定基準になる。可変電源 24V・電流制限 0.5A、パックは接続しない。
No. | 項目 | 手順・条件 | 測定点 | 設計値・判定基準 | 単位 | 実測値 | 判定 | 備考
5-1 | T_trip 遮断（TH1） | ヒートガンで TH1 を加熱。VBUS 24V、電流制限 0.5A | TP28 / TP25 / TP10 | TP28 が H になり Vout が落ちること。ファームウェア #3（T_trip 3 回連続） | —
5-2 | 遮断時の TH1 温度 | 5-1 の遮断直後に加熱をやめ、TH1 の抵抗を測って温度換算する | TH1 の両端 | 暫定 T_trip = 95℃（NTC 809Ω）。±3℃ 以内。★ 判定は温度で行う（v2.1.1 は EN 電圧だった） | ℃
5-3 | 10 秒ラッチ | 5-1 の後、すぐに冷却しても復帰しないことを確認 | TP10 | 10 秒間は Vout が戻らないこと | 秒
5-4 | 自動復帰 | T_trip − 15℃（暫定 80℃）まで冷却する | TP10 / TH1 | Vout が戻ること。復帰時の TH1 温度を記録 | ℃
5-5 | T_hard 即時遮断 | TH1 を急速に加熱して T_hard を超えさせる | TP28 / TP10 | 判定遅延なしで遮断されること。ファームウェア #4。暫定 T_hard = 115℃ | ℃
5-6 | TH2 遮断 | R11 近傍（TH2）をヒートガンで加熱。R11 自体は加熱しない | TP28 / TP10 / TH2 | 110℃ で遮断（暫定）。ファームウェア #5。★ TH2 は NCP21X で動作上限 125℃、超えないよう監視 | ℃
5-7 | センサ断線検出 | TH1 のパッドの片側を一時的に浮かせる（または TH1 を外す） | TP28 / TP10 | ADC が 3.3V 側に振れ、5 回連続でラッチ遮断。ファームウェア #7 | —
5-8 | センサ短絡検出 | TH1 の両端を短絡する | TP28 / TP10 | ADC が 0V 側に振れ、5 回連続でラッチ遮断。ファームウェア #7 | —
5-9 | ラッチの解除 | 5-7 / 5-8 の後、センサを戻して非常停止を押し→解除する | TP10 | J4 の再投入でラッチが解除され Vout が戻ること | —
5-10 | 起動失敗の検出（#8） | PA5 = L の状態で Q3 のゲート駆動を阻害する（IC3.GATE を一時的に GND へ 10kΩ で引く等） | TP28 / TP10 | 100ms 後に Vout < 0.8 × VBUS を検出してラッチ。ファームウェア #8 | ms
5-11 | 出力短絡の高速検出（#13） | ★ MDDS30 とパックを外し、電流制限 0.5A の可変電源で VBUS 24V。Vout − GND を 10Ω / 5W 程度の抵抗で短絡する | TP28 / TP10 | 2ms（1kHz × 2 回）で遮断しラッチすること。ファームウェア #13。★ 直接短絡はしない | ms
5-12 | #13 の armed 条件 | 起動直後（Vout が 0.9 × VBUS に達する前）に 5-11 を行う | TP10 | 立ち上がり中は誤発火しないこと。Vout ≥ 0.9 × VBUS を一度満たすまで armed にしない仕様 | —
5-13 | 低電圧警告（#9） | VBUS を 21.0V 以下に下げる | LED3 | LED3 が低速点滅すること。遮断はしない（IC3 の UVLO 19.5V に任せる） | V
5-14 | IWDG の動作（#10） | デバッグコマンドで意図的に無限ループに入れる | TP10 / SWD | 500ms でリセットがかかること。★ C20 のライドスルーにより Vout は切れない（これが #11 を必要とする理由） | ms
5-15 | IWDG 3 回ラッチ（#11） | 5-14 のループを維持し、リセットを 3 回繰り返させる | TP28 / TP10 | 3 回目で完全ラッチし Vout が落ちること。RCC のリセットフラグを数える実装 | 回
5-16 | チョッパ ON 積算（#6） | 8_ブレーキチョッパ の 8-7 の状態を維持し、積算が閾値を超えるまで待つ | TP28 / TP10 / R11 | 閾値超過で遮断すること。★ R11 のフランジ温度が 120℃ を超えたら即中止 | 秒
★ JP1 が開放であることを確認してから本フェーズに入ってください。ブリッジされていると EN_GATE が GND に固定され、5-1〜5-16 のすべてが「遮断しない」結果になります（0-2 / 2-6）。
★ 5-11 は意図的な短絡試験です。MDDS30 とパックを必ず外し、電流制限 0.5A の可変電源で、10Ω 程度の抵抗を介して短絡してください。直接短絡（0Ω）は基板側 48µF（C7 + C11）の放電で Q3 に数百 A が流れ、R51 / D12 があっても想定外です。
※ v2.1.1 との最大の違いは判定基準です。v2.1.1 は「EN 電圧で判定し、温度は参考値」でした（LM5060 の EN しきい値が個体ごとに 0.80〜2.00V ばらつくため）。v3.0.0 は遮断点がファームウェアの定数で決まるので、温度そのものが判定基準になります。精度は NTC の J ランク ±5% と抵抗の 1% だけで決まり、±2〜3℃ です。
※ 5-2 / 5-4 / 5-5 / 5-6 の温度は、NTC の抵抗値から換算してください。サーマルカメラは放射率と熱勾配で大きく外れます（v2.1.1 では真値 82℃ に対し 120℃ と表示されました）。換算式：T = 1 / (1/298.15 + ln(R/10000)/3944) − 273.15。
※ 5-6 の TH2 は R11 から 5mm 程度離して配置しています（0-24）。R11 自体は 150℃ 以上になり得ますが、TH2 の位置では 110℃ で遮断がかかる設計です。TH2 の遮断点 110℃ は暫定値で、7-9〜7-11 の実測で確定します。
※ 5-14 / 5-15 はデバッグビルドでは #11 を無効にしている可能性があります。本試験ではリリースビルドで実施してください。
※ 5-16 の閾値（直近 10 秒のチョッパ ON 積算）は未確定です。9-6 / 9-7 の回生プロファイル実測で決めます。本項目はその後に実施してください。
※ 故障モード表（設計仕様書 8_故障モード）のうち、Q6 のオープン故障は単一故障で検出も代替もできません。v2.4 で独立バックストップを検討する項目として残っています。

Sheet: 6_Q3ゲート保護
6_Q3 ゲート保護（R51 / D12）
2026-10-08 の Q3 破壊を受けて v3.0.0 で追加した R51（100Ω 直列）と D12（SMAJ15A ゲート−ソースクランプ）の検証。
No. | 項目 | 手順・条件 | 測定点 | 設計値・判定基準 | 単位 | 実測値 | 判定 | 備考
6-1 | R51 の実装・値 | DMM の抵抗レンジ（無通電） | TP5 − IC3.10 | 100Ω ±5%。0-10 と同じ項目。本フェーズの前提条件として再確認する | Ω
6-2 | D12 の向きと健全性 | DMM のダイオードレンジ（無通電） | TP5 − TP10 | TP5 ＋ で OL、逆向きで 0.6〜0.9V。0-11 と同じ項目 | V
6-3 | 通常動作時の非導通 | VBUS 29.4V で運転中。4-3 の Vgs を確認 | TP5 − TP10 | Vgs 11.8〜12.0V < SMAJ15A の Vbr min 16.7V。D12 が通常動作では導通しないこと | V
6-4 | ゲート電流への影響 | 4-4 の立ち上がり時間を R51 挿入前（v2.1.1 の 2 号機データ）と比較 | TP10 | 有意差がないこと。τ = 100Ω × Ciss 2.7nF = 0.27µs は 74ms に対し無視できる | ms
6-5 | 短絡時の Vgs クランプ（任意） | ★ MDDS30 とパックを外し、電流制限 0.5A で VBUS 29.4V。Ch1 = TP5、Ch2 = TP10、時間軸 1µs/div でトリガをかけ、Vout − GND を 1Ω 程度で短絡する | TP5 − TP10 | Vgs が ±20V（Q3 の定格）を超えないこと。D12 のクランプ 17V 付近で止まるのが設計どおり | V
6-6 | 短絡後の健全性 | 6-5 の後、Q3 の健全性を確認 | TP5 / TP10 / TP4 | TP5 − TP10 が非導通、TP10 − TP4 が Q3 のボディダイオード方向のみ導通。遮断時に Vout が 0V になること | —
★ 6-5 は任意項目です。実施する場合は MDDS30 とパックを必ず外してください。基板側だけなら C7 47µF ＋ C11 1µF ＝ 48µF で蓄積エネルギーは 20.7mJ（29.4V）ですが、MDDS30 を繋ぐと 3628µF で 1.45J となり 70 倍になります。2026-10-08 に 1 号機の Q3 を破壊したのは後者です。
※ R51 / D12 の役割：出力短絡で Vout が急落すると、C9 ∥ C15（44nF、GATE−GND 間）がゲートを 41V 付近に保持し、Vgs が Q3 の定格 ±20V を超えます。R51 100Ω がその 44nF をゲートから切り離し、D12（SMAJ15A）が Q3 の Ciss 2.7nF（max 3.4nF）分だけをクランプする構成です。クランプが流すべき電流は 4.5A（R51 なし）から 0.58A（R51 あり、300ns 崩壊・Ciss max の最悪ケース）へ 7.8 分の 1 に下がります。
※ 主因は IC3 内部クランプの電流能力です。LM5060 のデータシートは GATE−OUT 16.8V を I = 0.1mA でしか規定しておらず、0.35A 級のシンクは想定されていません。当初ループインダクタンスを主因と説明しましたが、数値を詰めると二次要因でした（40nH で 0.35A を立ち上げるのに 7ns、崩壊時間 4µs に対し 3 桁小さい）。
※ D12 は Q3 の足元に配置する指示です。遠くに置くと D12 自身が「Rz 1Ω だが L 40nH 越し」のクランプになり、速い崩壊（300ns 級）で同じ問題が再発します。
※ ファームウェア #13（2ms で遮断）は「電流制限された電源での持続的な短絡」「配線の半短絡」を対象とします。コンデンサ放電による µs オーダーの事象には間に合わないため、そちらは R51 / D12 のハードウェアで受けます。両者は役割分担であって冗長ではありません。

Sheet: 7_熱特性
7_熱特性
熱電対は Q1 と Q3 のパッケージ表面に貼る。TH1 / TH2 は部品本体ではなく NTC の抵抗値から温度を換算する（サーマルカメラは放射率で大きく外れる）。R11 はサーマルカメラで測る。
No. | 項目 | 手順・条件 | 測定点 | 設計値・判定基準 | 単位 | 実測値 | 判定 | 備考
7-1 | 筐体内周囲温度 | 実機を筐体に組み込み、走行後に測定 | 筐体内 | 記録のみ（T_trip / T_hard 決定の根拠） | ℃
7-2 | 通常走行 Q1 温度 | 8A 走行時、熱電対 Ch1 | Q1 パッケージ | 周囲＋1.3℃ 程度（下表参照。パッド→周囲 26.1K/W × 51mW） | ℃
7-3 | 通常走行 Q3 温度 | 同時測定、熱電対 Ch2 | Q3 パッケージ | 周囲＋4.9℃ 程度（23.9K/W × 0.21W） | ℃
7-4 | 通常走行 TH1 温度 | TH1 の抵抗から換算 | TH1 | Q1 / Q3 と 2〜3℃ 以内。T_trip 95℃ に対し 25℃ 以上の余裕 | ℃
7-5 | ストール時 Q1 温度 | 車輪を押さえて 25A、熱電対 Ch1 | Q1 パッケージ | 周囲＋14.7℃ 程度（2 パック並列、12.5A/個）。★ 単一パック運転では＋59℃ になる | ℃
7-6 | ストール時 Q3 温度 | 同時測定、熱電対 Ch2 | Q3 パッケージ | 周囲＋54℃ 程度（23.9K/W × 2.25W）。Q3 は全電流を単独で流す | ℃
7-7 | ストール時 TH1 温度 | TH1 の抵抗から換算 | TH1 | 記録のみ。7-5 / 7-6 とのオフセットが判定対象 | ℃
7-8 | ストール電流 | 同上、クランプメータ | 入力配線 | 25A 前後 | A
7-9 | 遮断までの時間 | 7-5 を継続し、ファームウェアが遮断するまで | TP10 / TP28 | 記録のみ。T_trip 95℃ 到達までの時間 | 秒
7-10 | R11 フランジ温度 | チョッパ連続導通（32.2V で 5.2W）、サーマルカメラ。★ 120℃ を超えたら即中止 | R11 フランジ | ★ 判定ではなく記録。下表の熱抵抗から平衡は 150℃ を超えるため、平衡させずに中止する | ℃
7-11 | 同時の TH2 温度 | TH2 の抵抗から換算 | TH2 | R11 の上昇を追従して検出すること。これが v3.0.0 で TH2 を追加した目的 | ℃
7-12 | 同時の TH1 温度 | TH1 の抵抗から換算 | TH1 | ほぼ周囲温度のまま（v2.0.0 実測で確認済み。TH1 は R11 の過熱を検出しない） | ℃
7-13 | TH2 の応答遅れ | 7-10 の開始から TH2 が 10℃ 上昇するまでの時間 | TH2 | 記録のみ。ファームウェア #5 の判定遅延（50ms 周期）に対し十分遅いはず | 秒
7-14 | C7 表面温度 | 7-10 と同時 | C7 表面 | 電解の寿命確認。周囲＋数℃ に留まること | ℃
7-15 | IC6 周辺温度 | 7-5 のストール時、サーマルカメラ | IC6 パッケージ | 動作範囲 −40〜+85℃。筐体内 65℃ ＋ 上昇分で 85℃ を超えないこと | ℃
7-16 | IC4 / L2 温度 | 同上 | IC4 / L2 | 周囲＋10℃ 以内（1-11 / 1-12 と同じ値になるはず） | ℃
7-17 | R70（シャント）の温度 | 25A ストール時、サーマルカメラまたは熱電対 | R70 本体 | 記録のみ。25A で 0.31W、30A で 0.45W（2512 / 3W 定格）。周囲＋40℃ 以内を目安 | ℃
温度オフセット（自動計算）
項目 | 計算式 | 値 | 設計想定 | 判定
Q1 − TH1（ストール時） | 7-5 − 7-7 |  | 2〜3℃（TH1 は Q1〜Q3 の各ドレインパッドから約 1mm）
Q3 − TH1（ストール時） | 7-6 − 7-7 |  | 5〜10℃（Q3 の損失が大きいぶん開く）
R11 − TH2（チョッパ動作時） | 7-10 − 7-11 |  | 数十℃（TH2 は R11 から 5mm 離してある）
R11 − TH1（チョッパ動作時） | 7-10 − 7-12 |  | 大きく開く（TH1 は R11 を検出しない）
銅箔の熱抵抗（.kicad_pcb の実形状から数値解析）
測定点 | 熱抵抗（パッド→周囲） | 初版基板 | v3.0.0 基板 | 備考
Q1 ドレインタブ | K/W | 29.1 | 26.1 | 裏面 VBUS 放熱ベタの拡大（29.0 × 29.0mm、783mm²）による
Q2 ドレインタブ | K/W | 28.4 | 25.9 | 同上
Q3 ドレインタブ | K/W | 24.0 | 23.9 | ほぼ変化なし（元から Vout ベタが広い）
R11 フランジ | K/W | 27.4 | 27.3 | 変化なし。R11 の放熱は元から専用ベタ
損失と温度上昇の予測（上の熱抵抗から算出）
条件 | 電流 | 1 素子の損失 | Q1 / Q2 の上昇 | Q3 の上昇
通常走行（2 パック） | 8A 合計 / 4A 個別 | Q1 51mW / Q3 0.21W | ＋1.3℃ | ＋4.9℃
ストール（2 パック） | 25A 合計 / 12.5A 個別 | Q1 0.56W / Q3 2.25W | ＋14.7℃ | ＋54℃
ストール（単一パック） | 25A すべて片側 | Q1 2.25W / Q3 2.25W | ＋59℃ | ＋54℃
ヒューズ定格（参考） | 30A | Q3 3.24W | — | ＋77℃
※ Q1 / Q2 / Q3 は v3.0.0 で CSD18540Q5B（TI、在庫終了）から BSC028N06NS（Infineon、LCSC C148250、PG-TDSON-8 / SuperSO8）に変更しました。基板の footprint「TDSON-8-1」は Infineon の PG-TDSON-8 用に描かれたものなので幾何学的に一致します。ピン配置は 1-3 = Source / 4 = Gate / 5-8 = Drain（露出パッド）。★ 末尾に SC が付く BSC028N06NSSC（LCSC C534317）は露出パッドがソースの別品種なので絶対に使わないこと。
※ 上表は .kicad_pcb の実形状から銅箔の面内熱伝導・FR4 の板厚方向伝導・両面 8W/m²K の自然対流を連立させて解いた値です。パッケージの接合部−ケース間（BSC028N06NS の R_θJC 0.9K/W typ・1.5K/W max）は含みません。損失 2.25W でも接合部はケースより 3.4℃ 高いだけなので、実質はパッケージ表面温度の予測値として使えます。
※ BSC028N06NS の Tj max は 150℃ で、CSD18540Q5B / NTMFS5C628NL の 175℃ より 25℃ 低くなります。周囲 65℃・2 パックのストールでも Q3 の接合部は 65 ＋ 54 ＋ 1.5 × 2.25 ≒ 122℃（余裕 28℃）、単一パックの最悪でも Q1 が 127℃（余裕 23℃）です。さらに TH1 は Q1〜Q3 の各ドレインパッドから約 1mm にあるためほぼケース温度を読み、ストール時のケース 119℃ は T_hard 115℃ を超えるので、ファームウェア #4 が接合部 150℃ のはるか手前で遮断します。ファームが死んだ場合も R42 / Q6 が 93ms で EN を落とすため到達しません。
※ Rds_on は BSC028N06NS の max 2.8mΩ（Vgs 10V / 25℃、typ 2.5mΩ）に温度係数を掛け、60℃ で 3.2mΩ、100℃ で 3.6mΩ として計算しました（60V トレンチ MOSFET の一般値、100℃ で ×1.3）。実測が上表より高い場合は、まず Vgs（4-3）が 10V 以上出ているかを確認してください。
★ 単一パック運転のストールが最悪条件です。Q1 または Q2 が 25A を単独で流すと＋59℃ になり、2 パック並列（＋14.7℃）の 4 倍になります。片方のパックを外した状態で高負荷をかけないでください。
※ R11 の熱抵抗 27.3K/W は、v2.1.1 の実測（32.5V / 5.28W で 120℃ に達しても平衡せず → 18℃/W 超）と整合します。5.2W の連続導通では平衡が 周囲＋142℃ となり、周囲 25℃ でも 167℃ で最高使用温度 150℃ を超えます。高温域では放射と自然対流の強化で実効熱抵抗が下がるため実際はこれより低くなりますが、「連続導通では 150℃ を超える」という結論は変わりません。
※ したがって R11 の過熱保護は TH2（ファームウェア #5）とチョッパ ON 積算（#6）が担います。これが v3.0.0 で TH2 を追加した理由です。7-11 / 7-13 でこの保護が実際に機能することを確認してください。
※ R11（C&B RESI TPAN0263F200RK9）のタブは絶縁されています（端子−フランジ間 2000VAC、絶縁抵抗 10MΩ 以上）。したがってフランジを GND ベタに接続する実装は電気的に安全で、放熱経路として使えます。
※ 7-10 はサーマルカメラの外殻温度です。フランジ温度はこれより高くなります。
※ T_trip / T_hard / TH2 の遮断点の暫定値（95 / 115 / 110℃）は、7-4 / 7-7 / 7-11 の実測で確定します。設計仕様書 9_未確定事項 を参照してください。

Sheet: 8_ブレーキチョッパ
8_ブレーキチョッパ
v2.1.1 の fail-off 構成（Q5 による PNP 反転段）をそのまま維持。R10 の取り外しは不要です。v3.0.0 では CHOP_SENSE によるマイコン側の監視が加わりました。
No. | 項目 | 手順・条件 | 測定点 | 設計値・判定基準 | 単位 | 実測値 | 判定 | 備考
8-1 | 12V レール | Vout 29.4V、DMM | TP8 / TP3 | 12V ±5%（11.4〜12.6V） | V
8-2 | 基準電圧 | 同上 | TP11 / TP3 | 2.495V ±0.5% | V
8-3 | 分圧ノード | 同上 | TP15 / TP3 | Vout × 0.0774（29.4V で 2.28V） | V
8-4 | Q5 コレクタ（OFF） | チョッパ非動作時 | TP23 / TP3 | Vout × 0.0077（29.4V で 226mV）。R14 経由で Chopper_Sense の電位が分圧されて現れる | V
8-5 | Q4 ゲート（OFF） | 同上 | TP9 / TP12 | Vout × 0.0070（29.4V で 206mV）。8-4 の値を R12 / R13 で分圧した値 | V
8-6 | Q4 ドレイン（OFF） | 同上 | TP21 / TP12 | Vout と同電位 | V
8-7 | チョッパ動作点 | 電源電圧を 30V から慎重に上げる | TP10 / TP19 | 32.2V でクランプ開始 | V
8-8 | チョッパ復帰点 | 電圧を下げる | TP10 / TP19 | 30.8V で復帰 | V
8-9 | Q5 コレクタ（ON） | チョッパ動作中 | TP23 / TP3 | 11.9V 付近 | V
8-10 | Q4 ゲート（ON） | 同上 | TP9 / TP12 | 10.9V 付近 | V
8-11 | チョッパ電流 | R11 両端電圧から算出、または電源の電流表示 | R11 / TP21 | 0.161A 前後（32.2V / 200Ω） | A
8-12 | R11 のフランジ温度 | 8-7 の状態を数十秒継続 | R11 フランジ | 周囲＋20℃ 程度（数十秒時点）。連続導通では 150℃ を超えるため長時間続けない | ℃
8-13 | CHOP_SENSE の読み（OFF） | チョッパ非動作時、SWD で ADC 値を読む | IC6.10 / C35 | ChopperLoad ÷ 11。Vout 29.4V で 2.673V（＝ H） | V
8-14 | CHOP_SENSE の読み（ON） | チョッパ動作中 | 同上 | 0V 付近（＝ L）。ファームウェア #6 は Low をチョッパ動作中と判定する | V
※ 8-7 は OVP 動作点 34.0V に近いため、電圧はゆっくり上げてください。確認できたら速やかに下げます。
※ v2.1.1 で fail-off 構成（Q5 による PNP 反転段）になったため、v2.0.0 で行っていた「R10 を外してチョッパを無効化する」手順は不要です。LM397 の故障・12V レール喪失・Q5 のオープン故障・R21 の断線のいずれでも Q4 はオフになります。ただし VREF の崩壊と Q5 / Q4 の短絡故障は fail-on のままで、そこを v3.0.0 では TH2 と #5 / #6 で受けます。
※ 8-4 / 8-5 は 0V ではありません。R14（1MΩ）がヒステリシス用に Chopper_Sense と Q5 のコレクタを繋いでいるため、チョッパ OFF でも Chopper_Sense の電位が R14 と R12+R13 で分圧されて現れます。Chopper_Sig = Vout × 0.0775 × 110k/(1000k+110k) = Vout × 0.0077。
※ この性質を使うと TP23 の実測値から Vout を逆算できます（Vout ≒ TP23 ÷ 0.0077）。32.2V まで上げなくても、分圧回路と R14 の結線が設計どおりかを低電圧のまま検証できます。
※ 8-13 / 8-14 は v3.0.0 で追加した項目です。CHOP_SENSE（R36 1MΩ / R37 100kΩ の ÷11 分圧）はテストポイントを持たないため、IC6.10 または C35 の上側端子で測るか、SWD で ADC の生値を読んでください。
※ R11 の最終値は 9-6 / 9-7 の回生プロファイル実測で決めます。候補と周囲 65℃ での連続導通時の平衡温度（熱抵抗 27.3K/W）：200Ω → 207℃ / 330Ω → 151℃ / 470Ω → 126℃ / 680Ω → 108℃。引ききるのに必要な制動時間は 200Ω で 2.5 秒、470Ω で 5.9 秒です。

Sheet: 9_走行時総合
9_走行時総合
実走行状態での確認。9-6 / 9-7 は R11 の最終値とファームウェア #6 の閾値を決める項目で、本シートの最優先事項です。
No. | 項目 | 手順・条件 | 測定点 | 設計値・判定基準 | 単位 | 実測値 | 判定 | 備考
9-1 | バス電圧リプル | 走行中、AC カップリング | TP4 / TP17 | 18kHz 成分が 100mV 以下 | mV
9-2 | Q1 ゲート波形 | 走行中、Q1 のゲートを観測 | Q1 ゲート | 25ms 周期のリフレッシュのみ。周期外の落ち込みが無いこと | —
9-3 | 順方向降下 | 8A 走行時、ツイストペアで差動測定 | TP13 − TP4 | 17mV 前後 | mV
9-4 | 遮断時の Vout | 走行中にスイッチ OFF | TP10 / TP19 | 負に振れないこと（C7 が支える） | V
9-5 | 給電パックの判別 | 走行中 | TP13 / TP14 | 電圧の高い側から給電されること | V
9-6 | 回生プロファイル | 制動時、Ch1 = TP21（GND:TP12）、Ch2 = TP10 | TP21 / TP12 | 導通時間とデューティを記録。R11 の最終値と #6 の閾値の判断材料 | ms
9-7 | 制動時の最大 Vout | 同時観測 | TP10 / TP19 | 34.0V（OVP）に達しないこと。余裕があれば R11 を 330Ω / 470Ω に上げられる | V
9-8 | Vout 経路の電圧降下 | 8A 走行時と 25A ストール時、差動測定 | TP10 − J3 の + 端子 | 8A / 25A の期待値は ★要再解析。★ 2026-10-14 以降に R70（0.5mΩ / 2512）が Q3 ソースと /Vout の間に挿入され、Vout ベタが切り欠かれたため旧値 1.024mΩ（8A で 8.2mV、25A で 25.6mV）は使えない。なお TP10 は R70 の下流なので本測定に R70 の 0.5mΩ は含まれない | mV
9-9 | GND 経路の電圧降下 | 同上 | TP19 − J1 / J2 の − 端子 | 8A で 7.8mV、25A で 24.4mV（実測検証 0.975mΩ、2 パック）。単一パックでは 1.398mΩ → 35mV | mV
9-10 | VBUS_SENSE の走行時精度 | 走行中、SWD で ADC 値を読み TP4 の実測と比較 | TP4 / IC6.8 | 誤差 ±2% 以内。リプルによる読み値の揺れも記録 | V
9-11 | VOUT_SENSE の走行時精度 | 同上 | TP10 / IC6.9 | 同上。★ C34 は 1nF なので #13 の 2ms 検出に間に合う時定数 | V
9-12 | チョッパ ON 積算の実測 | 9-6 の制動を数回繰り返し、SWD で積算値を読む | SWD | #6 の閾値を決めるための記録。制動 1 回あたりの積算増分を記録する | —
9-13 | I_SENSE の確認 | 8A 走行時と 25A ストール時、DMM またはオシロ | J7 pin1 − J7 pin2 | 25mV/A（R70 0.5mΩ × U3 INA240A2 ゲイン 50V/V）。8A で 0.200V、25A で 0.625V、30A で 0.750V。R77 1kΩ ＋ C67 1µF で fc 159Hz | V
9-14 | IC5 バッファ出力 | VBUS 29.4V、差動測定 | J7 pin3 − J7 pin2 | 1.601V（29.4V × 57.6kΩ ÷（1MΩ ＋ 57.6kΩ））、±3%。換算係数 18.36 V/V。R76 1kΩ ＋ C66 1µF で fc 159Hz | V
※ 9-1 が 100mV を大きく超える場合、C5 のリプル電流定格（18kHz で約 1.06A）に対する余裕を再検討してください。
※ 9-2 で周期外の落ち込みがあれば、リプルによる逆流誤検出が起きています。
※ 9-8 / 9-9 は v3.0.0 で追加した項目です。基板図の銅箔形状から抵抗ネットワークを解いた値（Q3 ソース → J3.1 が 1.024mΩ、J3 の GND → 両パックの − 端子が 0.975mΩ）の裏取りで、実測が大きく上回る場合は銅箔ではなくコネクタのはんだ付けを疑ってください。 ★ 2026-10-21 追記：R70（0.5mΩ）が Q3 ソース → /Vout に挿入されたため、Q3 ソース → J3.1 の全体は 銅箔 ＋ 0.5mΩ ≒ 1.5mΩ に増えた。TP10 は R70 の下流なので 9-8 の実測には R70 分は現れないが、ベタ形状が変わったため期待値そのものを再解析すること。
※ 9-9 の 30A 時の損失は 0.88W（GND 側）＋ 0.92W（Vout 側）＝ 1.8W で、基板全体に広く分散します。局所的な過熱にはなりません。 ★ 2026-10-21 追記：ただし R70（0.5mΩ / 2512 / 3W）は 30A で 0.45W、25A で 0.31W を単独で負担するため、ここだけは局所的です（7-17 で確認）。
※ 9-7 で OVP に達する場合は R11 を引ききれていません。150Ω または 100Ω への変更を検討してください。200Ω は制動時間 2.5 秒以上を前提にした値です。回生エネルギーは並進 4.5J ＋ ロータ慣性 約 1.8J ＝ 約 6.3J と見積もっています（ロータ慣性は推定値）。
※ 9-12 の結果で #6 の閾値を決めます。制動 1 回の積算増分を N とすると、閾値は「連続導通を 10 秒以内に止める値」と「正常な制動を数回続けても誤発火しない値」の間に取ります。

Sheet: 10_GND分離
10_GND 分離
C5（VBUS 側バルクコンデンサ）のマイナス端子での一点接続が機能しているかの検証。v3.0.0 では ADC の基準電位がここに乗るため、v2.1.1 より重要度が上がっています。
No. | 項目 | 手順・条件 | 測定点 | 設計値・判定基準 | 単位 | 実測値 | 判定 | 備考
10-1 | 制御GND−大電流GND | チョッパ動作中、差動測定 | TP3 − TP12 | 数十 mV 以内 | mV
10-2 | 同上（通常走行時） | 8A 走行中 | TP3 − TP12 | 7.8mV 以下（経路全体の抵抗 0.975mΩ × 8A が原理上の上限） | mV
10-3 | 同上（ストール時） | 25A ストール中 | TP3 − TP12 | 24.4mV 以下（同 × 25A）。単一パック運転では 35mV 以下 | mV
10-4 | DC 島の等電位性 | 25A ストール中、差動測定 | TP2 / TP3 / TP17 / TP32 の相互 | 相互に 1mV 以内。DC 島には大電流が流れないため | mV
10-5 | AC 島の内部降下 | 同上 | TP1 / TP12 / TP18 / TP19 の相互 | 数 mV〜数十 mV。島内の IR ドロップそのものなので、値の大小ではなく 10-4 との差が判定対象 | mV
10-6 | 一点接続の位置確認 | 無通電、目視と導通 | C5 の GND パッド | C5 の GND パッド直下に 0.3〜0.5mm ビアが 8 本あり、それが唯一のブリッジであること。設計解析では確認済み（記録のみ） | —
10-7 | ADC の基準電位の健全性 | 25A ストール中、SWD で TH1_SENSE の ADC 値を読む | IC6.7 / TP26 | 無負荷時（7-4）と同じ温度を示すこと。10mV 以上ずれるなら GND 分離が効いていない | ℃
10-8 | アナログ島の等電位性 | 25A ストール中、差動測定 | J7 pin2 − TP32 | 1mV 以内。超えるならネットタイ NT1 以外の経路で ANALOG_SENSE_GND が GND に繋がっている | mV
GND テストポイントと島の対応（v3.0.0 基板図から確認）
テストポイント | ネット | 島 | 座標 (mm) | 用途
TP2 | GND | DC 島 | (117.84, 81.79) | EN / TIMER 測定の基準（IC3 の GND 側）
TP3 | GND | DC 島 | (109.64, 46.34) | チョッパ制御系の基準。10-1〜10-3 の DC 側
TP17 | GND | DC 島 | (104.83, 116.49) | VBUS 測定の基準
TP32 | GND | DC 島 | (104.80, 92.84) | 3.3V / MCU 系の基準。v3.0.0 で追加
TP1 | GND | AC 島 | (142.18, 140.47) | J1 / J2 側
TP12 | GND | AC 島 | (175.20, 48.94) | チョッパ負荷側。10-1〜10-3 の AC 側
TP18 | GND | AC 島（裏面のみ） | (131.71, 82.64) | ゲート波形（TP5）の基準
TP19 | GND | AC 島 | (168.34, 66.29) | Vout 測定の基準
（TP なし） | ANALOG_SENSE_GND | アナログ島 | NT1 = (178.66, 69.55) | U3 / IC5 / R72 / C65〜C68 / J7 pin2 の基準。ネットタイ NT1 一点で GND に接続。★ 2026-10-21 追加。TP が無いので J7 pin2 で測る
※ 上表は .kicad_pcb のゾーン塗りつぶしをラスタライズし、連結成分解析で確認したものです。10-1〜10-3 の「DC 島 − AC 島」を測るには DC 側から 1 点、AC 側から 1 点を選びます。v2.1.1 の TP3 − TP12 の組み合わせはそのまま有効です。 ★ 2026-10-21 追記：2026-10-14 以降に R70 と ANALOG_SENSE_GND 島（NT1）が追加され、TP3 / TP18 / TP19 が移動したため、ゾーンの連結成分解析は現基板で再実行すること。TP18 の「裏面のみ」も再確認が必要。
※ 10-2 / 10-3 の上限値は「J3 の GND から両パックの − 端子までの経路全体の抵抗が 0.975mΩ（2 パック）／1.398mΩ（単一パック）」という解析結果から導いた原理上の上限です。TP3 − TP12 はその経路の一部しか見ないため、実測はこれより小さくなるのが正常です。超える場合は一点接続以外の経路（2 つ目のブリッジ）が存在します。
※ 10-4 が 1mV を超える場合、DC 島に大電流経路が混入しています。設計仕様書 7_レイアウト指示 の「DC 島に置く部品」一覧を確認し、AC ベタに GND を落としている部品がないか探してください。1 つでも落ちていると分割が無効になります。
※ 10-7 は v3.0.0 で追加した最も実務的な項目です。GND 分離の目的は「ADC の基準電位を大電流の IR ドロップから切り離すこと」なので、分離が効いているかは最終的に ADC の読みで判定します。
※ 想定を超える場合、GND の引き回しを見直してください。次版での改善項目になります。

Sheet: 11_外部スイッチ・LED
11_外部スイッチ・LED
LED 付き非常停止スイッチ（5 ピン、1NO1NC）と F3（PPTC）の確認。ハーネスは v2.1.1 のまま流用できますが、pin3 / pin4 が繋がるネットが 3.3V 系ロジックに変わりました。
No. | 項目 | 手順・条件 | 測定点 | 設計値・判定基準 | 単位 | 実測値 | 判定 | 備考
11-1 | 非常停止の遮断 | ボタンを押す | TP10 / TP19 | Vout が 0V になること | V
11-2 | 復帰 | ひねって解除 | TP10 / TP19 | Vout が復帰すること | V
11-3 | 接点の導通抵抗 | 無通電、スイッチ解除状態 | J4 pin3 − pin4 | 1Ω 以下 | Ω
11-4 | 接点電流 | 運転中 | J4 pin3 − pin4 | 1.22mA（2.68V ÷ 2.2kΩ）。接点の酸化皮膜対策として 1mA 以上を確保している | mA
11-5 | LED 電流（34V） | Vout を 34V に設定し、J4 pin1 の電流を測定 | J4 pin1 | 40mA 以下が望ましい | mA
11-6 | LED 電流（19.5V） | Vout を 19.5V に設定 | J4 pin1 | 記録のみ（電圧依存性の確認） | mA
11-7 | F3 の電圧降下 | 11-5 と同時に測定 | Vout − J4 pin1 | LED 電流 × 1.6〜15Ω | mV
11-8 | LED 線短絡時のトリップ | ★ 電流制限付き電源で J4 pin1 − pin2 を短絡 | J4 | F3 がトリップすること。1 秒以内 | 秒
11-9 | F3 の復帰時間 | 短絡を解除し、LED が再点灯するまで | 外部 LED | 記録のみ | 秒
11-10 | EN_FB の読み戻し | 非常停止を押す／解除する | IC6.15 / TP7 | PA8 が TP7 の状態（2.68V ↔ 78mV）を R41 10kΩ 経由で読めること。#12 の STOP 判定と復帰に使う | V
★ 11-8 は意図的な短絡試験です。必ず電流制限付き電源で実施し、パックは接続しないでください。
※ 11-5 が 40mA を超える場合、F3 を 1206L020/60NR（ホールド電流 200mA）に変更してください。筐体内 65℃ ではホールド電流が 25℃ 定格の 6 割程度まで下がります。
※ F3（1206L010/60NR）の諸元：ホールド 100mA / トリップ 250mA / Vmax 60V / 正常時抵抗 1.6〜15Ω / 動作温度 −40〜85℃。
※ 外部 LED は Vout から駆動されるため、非常停止・サーマル遮断・OVP・UVLO・マイコンによる遮断のいずれで遮断されても消灯します。スイッチ位置ではなく実際の出力を示します。
※ 11-10 は v3.0.0 で追加した項目です。J4 のハーネスは v2.1.1 のまま流用できますが、pin3 / pin4 が繋がるネットが 3.3V 系ロジック（EN_SWITCH / EN）に変わりました。
※ J4 ハーネスが Vout に短絡した場合、D8（5V ESD）が先にクランプして電流を全部引き受けます。D8 はこの間クランプ 9V 付近で 100mA＝約 0.9W を負担するため破壊される前提の犠牲部品です。ハーネス短絡の後は D8 を交換してください。

Sheet: 12_量産工程
12_量産工程（300 枚ロット）
300 枚ロットの量産工程。方針は「全数は短縮版、抜取りでフル試験」。J6（SWD ヘッダ）は量産では未実装とし、スルーホールにポゴピンを当てて書き込む。試作（v3.0.0 初号〜）では J6 を PCBA 実装しているので、本シートの治具は量産ロットから適用する。
前提条件
項目 | 内容
ロット数量 | 300 枚
J6（SWD ヘッダ） | ★量産では未実装（DNP）。発注時に「J6 はスルーホールを塞がずに未実装」と明示すること。溶融はんだで穴が埋まるとポゴピンが入らない
JP1 | 基板パターンのみ。★量産では絶対にブリッジしない（ブリッジするとマイコンによる遮断が一切効かない）
電源の供給 | J1（XT60）に 24V / 電流制限 0.2A の可変電源を接続する。IC4 経由で 3.3V レールが立ち、MCU が動く。VBUS 経由にすることで IC4 の動作も同時に検証できる
J4 ループバックプラグ | JST XA 4 極のハウジングに pin3 − pin4 を短絡した線を入れた治具。非常停止スイッチの「解除」を模擬する。抜き差しで P-7 の非常停止試験ができる
全数検査 | P-1〜P-7 の 7 項目。1 枚あたり約 100 秒
抜取り検査 | 初期流動 5 枚（レベル A）＋ 以降 30 枚ごとに 1 枚（レベル B、計 10 枚）＝ 合計 15 枚
工数の目安 | 全数 300 枚 × 100 秒 ≒ 8.5 時間 ／ 抜取り A 5 枚 × 60 分 ＝ 5 時間 ／ 抜取り B 10 枚 × 20 分 ≒ 3.3 時間 ／ 合計 約 17 時間（約 2 人日）
工程フロー（1 枚あたり）
順 | 工程 | 内容 | 所要
1 | 受入 | PCBA から入荷。ロット番号・数量・製造日を記録 | —
2 | 外観（P-1） | ルーペで目視 | 20 秒
3 | 出力短絡（P-2） | DMM 抵抗レンジ | 8 秒
4 | 通電（P-3 / P-4） | J1 に 24V 投入。3.3V レールと「Vout が出ないこと」を確認 | 17 秒
5 | 書き込み（P-5） | ポゴピン治具を押し当て、CLI を実行。UID とログを記録 | 15 秒
6 | 運転確認（P-6） | J4 ループバックを挿す。Vout と LED1 を確認 | 12 秒
7 | 非常停止（P-7） | ループバックを抜く。Vout が落ちることを確認 | 5 秒
8 | 電源断 | 24V を落とし、MDDS30 側を放電（本工程では負荷未接続のため不要） | —
9 | 抜取り判定 | 該当枚（初期 5 枚 ＋ 30 枚ごと）なら抜取り検査へ回す | —
10 | ラベル・梱包 | 基板に UID 下 6 桁とロット番号を記載したラベルを貼る | 15 秒
全数検査項目（短縮版）
No. | 項目 | 手順・条件 | 測定点 | 設計値・判定基準 | 単位 | 実測値 | 判定 | 備考
P-1 | 外観 | ルーペ（8〜10倍、LED付）で全面 | 基板全体 | ブリッジ・未はんだ・欠品・向き違いが無いこと。重点は IC6（TSSOP-20、0.65mm ピッチ）、IC4（SOT-23-6）、Q1〜Q3（PG-TDSON-8）。★ J6 のスルーホール 5 個がはんだで塞がっていないこと。★ JP1 がブリッジされていないこと、U3（TSSOP-8、0.65mm ピッチ）、IC5（SOT-23-5）、R70（2512 シャント、ケルビンパッドの向き）。★ R73 / C64 / C69 が未実装（DNP）であること。★ R74 / R75（0Ω）が実装されていること | —
P-2 | 出力短絡 | DMM 抵抗レンジ（無通電） | TP10 − TP19 | 数百Ω以上で、C7 / C11 の充電により表示が上昇し続けること。数Ωで止まったら Vout − GND の短絡 | Ω
P-3 | 3.3V レール | J1 に 24V 投入（電流制限 0.2A）、J4 は未接続 | TP24 − TP32 | 3.21〜3.41V（3.307V ±3%）。同時に電源の電流表示が 5mA 未満であること | V
P-4 | ★未書込みで Vout が出ないこと | P-3 と同じ状態 | TP10 − TP19 | 0.1V 未満。★これがフェイルセーフの全数検証。Vout が出たら重大不適合 | V
P-5 | 書き込み＋ベリファイ | ポゴピン治具を J6 のスルーホールに押し当て、書き込みスクリプトを実行 | J6 pin1〜5 | CLI が PASS を返すこと。UID・FW ハッシュ・RDP 設定結果がログに記録されること | —
P-6 | 運転移行 | J4 ループバックプラグを挿す | TP10 − TP19 / LED1 | Vout が VBUS − 0.5V 以上に立ち上がること。LED1 が点灯すること | V
P-7 | ★非常停止 | J4 ループバックプラグを抜く | TP10 − TP19 | Vout が 0.5V 未満に落ちること。★効かなければ重大不適合 | V
★ P-4 と P-7 は安全に関わる項目です。どちらかが NG の基板は、原因を特定して是正するまで絶対に出荷しないでください。P-4 の NG はマイコン死亡時に出力が切れないことを、P-7 の NG は非常停止が効かないことを意味します。
※ 電源の電流制限を 0.2A にしておくことで、VBUS − GND や 3.3V − GND の短絡は P-3 の時点で CC に入って分かります。そのため DMM による短絡確認は、Q3 を守る必要がある出力側（P-2）だけに絞っています。
※ P-3 で IC4（3.3V 降圧）も同時に検証されます。3.3V を直接注入する方式だと IC4 が未検証のまま通過してしまうため、VBUS からの給電にしています。
※ P-6 で Vout が立ち上がるのは、書き込み済みマイコンが PA5 = L にし、J4 ループバックで EN 経路が閉じるためです。立ち上がりに 40〜90ms かかるので、挿してから 0.5 秒ほど待って測定してください。
※ 本工程では MDDS30 を接続しないため、Vout 側の容量は C7 47µF ＋ C11 1µF の 48µF だけです。蓄積エネルギーは 29.4V で 20.7mJ と小さく、放電手順は不要です。
※ 1 枚あたり約 100 秒（外観 20 ＋ 短絡 8 ＋ 通電 17 ＋ 書き込み 15 ＋ 運転 12 ＋ 非常停止 5 ＋ ハンドリング 25）。300 枚で約 8.5 時間です。
NG 時の処置
NG 項目 | 想定原因 | 処置 | 出荷
P-1 外観 | はんだブリッジ、未はんだ、欠品、向き違い | リワーク後に P-1 から再実施 | 是正後可
P-2 出力短絡 | D1 / D7 / C7 / C11 / Q3 周辺のブリッジ、または Q3 の D−S 短絡 | 該当部品を確認・交換 | 是正後可
P-3 3.3V が出ない / 電圧ずれ | IC4、L2、D10、C27、C29、C30、R44 / R45（FB 分圧） | FB 分圧の実装値を確認。SW ノードのループも確認 | 是正後可
P-3 電流が 5mA を超える | 3.3V レールの部分短絡、IC6 の不良 | 即座に電源を落とす。TP24 − TP32 の抵抗を測る | 是正後可
★P-4 Vout が出てしまう | JP1 がブリッジされている／R42（1MΩ）未実装・不良／Q6 の向き違い・オープン故障／R48 未実装 | JP1、R42、R48、Q6 を順に確認。Q6 はピン1（ゲート）が左上であることを目視 | ★是正・再試験まで出荷禁止
P-5 書き込み失敗 | 治具の接触不良（まず再押し当て）、IC6 のはんだ不良、MCU_NRST / SWDIO / SWCLK の配線不良 | 2 回再試行して駄目なら IC6 と J6 周辺をルーペで確認 | 是正後可
P-6 Vout が出ない | IC3（LM5060）、Q3、R51、EN チェーン（D11 / R39 / R40 / C12）、J4 のはんだ不良 | TP7（EN）が 2.68V まで上がっているかで切り分ける。上がっていれば IC3 以降、上がらなければ EN チェーン | 是正後可
★P-7 非常停止が効かない | R40（2.2kΩ）未実装・不良、C12 の短絡、J4 のはんだ不良 | R40 の実装と値、J4 の 4 ピンの導通を確認 | ★是正・再試験まで出荷禁止
書き込み手順（P-5 の詳細）
項目 | 内容
ライタ | STLINK-V3MINIE。★ターゲットに給電しないため、J1 からの 24V 投入が前提。予備を 1 台用意すること
接続 | STDC14 → 2.54mm 変換アダプタ → ポゴピン治具（5 極）
ソフト | STM32CubeProgrammer CLI（STM32_Programmer_CLI）
書き込み | STM32_Programmer_CLI -c port=SWD mode=UR reset=HWrst freq=4000 -w <fw>.hex -v -rst
UID 読み出し | STM32_Programmer_CLI -c port=SWD mode=HOTPLUG -r32 <UID先頭アドレス> 0x0C ※ STM32C0 の Unique device ID レジスタのアドレスはリファレンスマニュアルで確認すること
読み出し保護 | STM32_Programmer_CLI -c port=SWD mode=UR -ob RDP=0xBB ★必ず書き込み・ベリファイが成功した後の最終ステップで実行する
実行順 | ① UID 読み出し → ② 書き込み → ③ ベリファイ（-v） → ④ RDP Level 1 → ⑤ ログ追記。①〜⑤ を 1 本のスクリプトにまとめ、戻り値で PASS / FAIL を判定する
再試行 | 接触不良による失敗を想定し、自動で 2 回まで再試行。3 回目の失敗で FAIL とする
読み出し保護（RDP）
レベル | 内容 | 可逆性 | 採用
Level 0（0xAA） | 保護なし（既定） | — | 試作のみ
Level 1（0xBB） | デバッガからのフラッシュ読み出しを禁止。Level 0 に戻すと全消去される | 可逆 | ★量産で採用
Level 2（0xCC） | デバッグを恒久的に無効化 | 不可逆 | 採用しない
★ Level 2 は選ばないでください。現場から戻った基板のファームウェアを更新することも、不具合を SWD で調査することもできなくなります。保護制御を担う基板でこれは割に合いません。
※ Level 1 ならデバッグ接続自体は可能で、禁止されるのはフラッシュの読み出しだけです。抜取り検査（レベル A / B）は RDP 設定後でも実施できます。
※ 再書き込みが必要になった場合は、RDP を Level 0 に戻す操作で全消去されたうえで書き込めます。フィールド返品の救済経路が残ります。
抜取り検査の計画
レベル | 対象 | 頻度 | 項目 | 所要/枚
A（初期流動） | ロットの最初の 5 枚 | 最初の 5 枚すべて | 0_通電前確認 全 24 項目 ／ 1_3.3V電源 1-1〜1-6・1-8〜1-12 ／ 3_低電圧基本動作 全 11 項目 ／ 4_起動波形 4-2〜4-8 ／ 5_保護機能 5-1〜5-9・5-13 ／ 8_ブレーキチョッパ 8-1〜8-6・8-13 ／ 11_外部スイッチ・LED 11-1〜11-5・11-10 | 約 60 分
B（定期） | 6 枚目以降 | 30 枚ごとに 1 枚（計 10 枚） | 0_通電前確認 0-1〜0-16 ／ 1-1〜1-3 ／ 3-1〜3-4・3-7・3-10 ／ 4-3〜4-5 ／ 5-1・5-2・5-4 ／ 8-1〜8-3 ／ 11-1・11-3 | 約 20 分
※ 初期流動の 5 枚を厚く見るのは、系統的な不良（部品の向き、定数違い、はんだ条件）が出るなら最初の数枚で出るためです。ここを通過できれば、以降は工程のドリフトを監視する目的に切り替えられます。
※ 抜取りで NG が出たら、その 1 枚だけの問題か工程の問題かを切り分けてください。工程の問題なら、前回の抜取り合格枚まで遡って全数再検査が必要になります。これが抜取り間隔を 30 枚に抑えている理由です。
※ 走行が必要な項目（9_走行時総合、10_GND分離、7_熱特性のストール試験）は抜取りからも外しています。これらは設計検証であって工程検証ではないため、初号機の結果をもって確認済みとします。
※ レベル A / B の実施記録は、試験記録シートの該当シートに枚ごとに記入するか、本ファイルを基板ごとにコピーして使ってください。
※ 抜取り枚数は合計 15 枚（5%）です。より厳しくするなら定期を 20 枚ごと（計 15 枚）に、緩めるなら 50 枚ごと（計 6 枚）に調整してください。
書き込み治具の接点定義
接点 / 要素 | 座標 (mm) | 仕様 | 接続先
J6 pin1 | (105.28, 122.08) | スルーホール φ1.0 / パッド 1.7 | +3V3 ＋ ライタの T_VCC（VTref）
J6 pin2 | (105.28, 124.62) | 同上 | SWDIO
J6 pin3 | (105.28, 127.16) | 同上 | SWCLK
J6 pin4 | (105.28, 129.70) | 同上 | NRST
J6 pin5 | (105.28, 132.24) | 同上 | GND
位置決め 1 | 基板左辺 x = 101.485 | y 45.9〜143.4 が直線。J6 まで 3.795mm | 面で当てて X と回転を拘束
位置決め 2 | (104.03, 143.00) | 取付穴 φ3.2 | φ3.0 ダウエルピンで Y を拘束
（参考）TP17 | (104.83, 116.49) | GND、スルーホール φ1.0 | 必要なら GND の 2 点目として
（参考）TP24 | (104.75, 113.56) | +3V3、SMD φ1.5（表面） | 裏面からは接触できない
治具・機材の部品表
部品 | 型番 / 仕様 | 数量 | 入手先 | 参考価格
コンタクトプローブ | MISUMI エコノミー 2.54mm ピッチ NPT2-D（球状 SR、プランジャ φ1.27） | 50 本入 × 1 | MISUMI 110302582670 | 1,980 円（税別）
（予備）プローブ | 同 NPT2-B（ニードル、φ1.06）。穴にフラックス残渣がある場合用 | 50 本入 × 1 | MISUMI | 約 2,000 円
レセプタクル | MISUMI NRT2-CR（外径 1.82mm、圧入穴 φ1.75） | 50 本入 × 1 | MISUMI | 1,800 円（税別）
アダプタ基板 | FR4 1.6mm。φ1.75 穴 5 個を 2.54mm ピッチ。30 × 30mm 程度 | 5 枚 | JLCPCB | 約 $2
ダウエルピン | φ3 h7 ストレート | 1 本 | MISUMI | —
ライタ | STLINK-V3MINIE（＋予備 1 台） | 2 台 | RS / Mouser / 秋月 | 約 2,000 円/台
変換アダプタ | STDC14 → 2.54mm（または STDC14 → MIPI10 → 2.54mm） | 1 式 | — | —
J4 ループバックプラグ | JST XA 4 極ハウジング＋圧着端子。pin3 − pin4 を短絡 | 2 個 | — | —
XT60 電源リード | XT60 メス ＋ バナナ。可変電源用 | 1 本 | — | —
可変電源 | 0〜30V / 電流制限 0.2A が設定できるもの | 1 台 | — | —
DMM | 抵抗レンジと DC 電圧 | 1 台 | — | —
ルーペ | 8〜10 倍、LED 付 | 1 個 | — | —
※ プローブの押し付け力は 5 本 × 113 gf ＝ 約 5.5N。片手で押し当てられる力なので、まずはベースプレートもクランプも無しの「手持ちアダプタ」で始めてください。面倒になったらトグルクランプ式に移行します。
※ NPT2-D（球状 SR、φ1.27mm）はプランジャが φ1.0mm の穴より大きく、穴の口に座って自己調心します。横方向の許容は ±0.5mm 程度あり、治具の精度要求が緩くなります。基板は ENIG（平坦な金めっき）なので酸化膜を破る必要がなく、球状で十分な接触が得られます。
※ レセプタクル外径 1.82mm を 2.54mm ピッチで並べると隣との肉厚が 0.72mm になります。アクリル板では割れるので、保持板は PCB（FR4 1.6mm）で作ってください。
※ プローブの寿命は 200,000 回。300 枚なら 0.15% しか使いません。消耗は考慮不要です。
★ ベースプレート式にする場合、支持ポストは裏面に突き出る THT リード 37 箇所（J8 の 2 本を含む）を避けてください。推奨位置は (176.5, 96.9) / (150.5, 102.9) / (124.5, 104.9) / (112.0, 120.0) です。最後の 1 点だけ最寄りの THT まで約 7mm しかないので、φ4mm 以下のナイロンまたは POM 製にしてください。

Sheet: 13_量産記録
13_量産記録
全数検査の 1 枚ごとの結果はスクリプトが CSV に出力する。本シートにはロット単位の集計と、抜取り検査の記録を残す。
ロット記録（1 ロットにつき 1 枚このシートを複製する）
項目 | 内容
ロット番号
数量
PCBA 受入日
書き込み実施日
FW ファイル名
FW ハッシュ（SHA-256 先頭16桁）
RDP レベル | 1
作業者
全数 合格数
全数 不合格数
抜取り A 実施枚数
抜取り B 実施枚数
総合判定
全数検査ログ（CSV）の列定義 — スクリプトが自動出力する
列 | 内容 | 例
1 連番 | ロット内の通し番号 | 001
2 日時 | ISO 8601 | 2026-11-05T10:23:41+09:00
3 ロット番号 | 製造ロット | MGPC-V300-L01
4 UID | STM32 の 96bit 固有 ID（16 進 24 桁） | 0A1B2C3D4E5F60718293A4B5
5 FW ファイル名 | 書き込んだ hex のファイル名 | mgpc_v1.0.0.hex
6 FW ハッシュ | hex ファイルの SHA-256（先頭 16 桁） | 3f9a1c7e2b4d8056
7 書き込み結果 | PASS / FAIL | PASS
8 ベリファイ結果 | PASS / FAIL | PASS
9 RDP | 設定後のレベル | 1
10 再試行回数 | 0〜2 | 0
11 P-1〜P-7 判定 | 7 項目の OK / NG をカンマ区切り | OK,OK,OK,OK,OK,OK,OK
12 作業者 | イニシャル等 | TK
13 備考 | NG 内容・是正内容 | —
抜取り検査の記録（15 枚）
No. | 基板 UID 下6桁 | レベル | 実施日 | 判定 | NG 項目・是正内容
1 |  | A
2 |  | A
3 |  | A
4 |  | A
5 |  | A
6 |  | B
7 |  | B
8 |  | B
9 |  | B
10 |  | B
11 |  | B
12 |  | B
13 |  | B
14 |  | B
15 |  | B
不適合記録
日付 | 基板 UID 下6桁 | 不適合の内容 | 原因 | 是正処置 | 再試験結果
※ 全数検査ログの CSV は、ロット単位でこのファイルと同じ場所に保存してください。ファイル名は「ロット番号_全数ログ.csv」とします。
※ ★P-4（未書込みで Vout が出ないこと）と ★P-7（非常停止）が NG の基板は、是正・再試験が完了するまで出荷禁止です。不適合記録に必ず残してください。

Sheet: サマリ
設計値と実測値の比較サマリ
各シートに入力すると自動で反映されます（灰色セル）。
項目 | 設計値 | 実測値 | 差 | 判定 | 備考
3.3V レール出力 | 3.307 V
3.3V リプル | 1.0 mVpp（上限 30） |  | — |  | グランドスプリング必須
スイッチング周波数 | 700 kHz |  |  |  | X 版の確認
3.3V 負荷（運転時） | 8.0 mA
3.3V 負荷（遮断時） | 15.9 mA |  |  |  | EN チェーン 13mA を含む
マイコン死亡時の遮断 | 93 ms |  |  |  | R42 1MΩ × C20 100nF
UVLO 遮断 | 19.5 V
UVLO 復帰 | 17.4 V
OVP 遮断 | 34.0 V
OVP 復帰 | 30.1 V
EN 電圧（運転時） | 2.68 V |  |  |  | v2.1.1 は 3.9V
EN 電圧（Q6 ON 時） | 78 mV
待機電流 | 460 µA |  |  |  | v2.1.1 は 60µA
Vgs 終値 | 12.0 V |  |  |  | 規格 10〜14V
Vout 立ち上がり | 57.2 ms（許容 42〜87）
突入電流 | 1.98 A（上限 2.4）
TIMER ピーク | 2.0 V 未満 |  | — |  | ラッチ電圧に対する余裕
TP5 − TP2 間容量 | 46.7 nF |  |  |  | 60nF 超なら C9 / C15 過大
T_trip 遮断温度 | 95 ℃（暫定） |  |  |  | 7-4 の実測で確定
TH2 遮断温度 | 110 ℃（暫定） |  |  |  | 7-11 の実測で確定
12V レール | 12.0 V
基準電圧 | 2.495 V
チョッパ動作点 | 32.2 V
チョッパ復帰点 | 30.8 V
チョッパ電流 | 0.161 A
実測でのみ得られる値
項目 | 実測値 | 単位 | この値で決まること
MDDS30 入力容量 |  | µF | C15 / C16 の実装可否（3628µF で実装済み）
筐体内周囲温度 |  | ℃ | T_trip / T_hard の最終値
ストール電流 |  | A | R1（OCP しきい値）の妥当性
R11 フランジ温度 |  | ℃ | R11 の実装品質、熱抵抗 27.3K/W の裏取り
TH2 の応答遅れ |  | 秒 | ファームウェア #5 の判定遅延の妥当性
バスリプル（18kHz） |  | mV | C5 のリプル耐性の余裕
制動時の最大 Vout |  | V | R11 の最終値（200Ω で足りるか）
Vout 経路の電圧降下 |  | mV | 解析値（R70 0.5mΩ 挿入後に再解析が必要）の裏取り
GND 経路の電圧降下 |  | mV | 解析値 0.975mΩ の裏取り
チョッパ ON 積算の増分 |  | — | ファームウェア #6 の閾値
TP3 − TP12 電位差 |  | mV | GND 分離設計の妥当性
LED 電流（34V） |  | mA | F3 の品種（100mA 品で足りるか）
Q1 − TH1 オフセット（7_熱特性 の自動計算を転記） |  | ℃ | T_trip / T_hard の妥当性。設計想定 2〜3℃
総合判定
次版（v3.1 / v2.4）への申し送り事項

Sheet: 変更履歴
v2.1.1 からの変更履歴（v3.0.0）
試験時に設計値の根拠をたどるための記録。
試験仕様書の改訂内容
版 | 対象 | 変更内容 | 理由・根拠
v3.0.0 | 試験仕様書の構成 | シートを 10 枚から 12 枚に再編し、試験番号を全面的に振り直した。実施順序を「3.3V → マイコン → 低電圧基本動作 → 起動波形」に変更 | EN がフェイルセーフ（マイコンが能動的に保持しないと切れる）になったため、マイコンが動くまで Vout が出ない。v2.1.1 の順序（低電圧基本動作が最初）では 1 項目も測れない
v3.0.0 | 9_ENしきい値選別 | シートを削除 | 遮断点が LM5060 の EN しきい値ばらつき（0.80〜2.00V）ではなくファームウェアの定数で決まるため、量産選別が不要になった。EN は 2.68V と 78mV の 2 値だけを取り、どちらも ENTHH / ENTHL から十分離れている
v3.0.0 | 1_3.3V電源（新規） | IC4（LMR16006XDDCR）の 12 項目を追加 | マイコン電源の新設。VBUS（Q3 の前）から取るため、Vout が出ない状態でも検証できる
v3.0.0 | 2_MCU書き込みと基本動作（新規） | IC6（STM32C011F4P6）の 22 項目を追加。JP1 のブリングアップ手順を 2-4 / 2-5 / 2-6 に明記 | 未書込みのチップは GPIO が Hi-Z のため R42 1MΩ が EN_GATE を +3V3 へ引き上げ、Q6 が ON になって EN が落ちる。JP1 をブリッジすると EN_GATE が GND に固定され、ファームウェア無しでも電源部を動かせる。★ 書き込み後は必ず開放に戻す
v3.0.0 | 5_保護機能（マイコン） | 判定基準を EN 電圧から温度そのものへ変更。ファームウェア #3〜#13 の 16 項目に拡張 | 遮断点がファームの定数で決まるため、精度は NTC の J ランク ±5% と抵抗の 1% だけで決まり ±2〜3℃。v2.1.1 の「温度は参考値」という制約が消えた
v3.0.0 | 6_Q3ゲート保護（新規） | R51 / D12 の検証 6 項目を追加 | …R51 100Ω が C9 ∥ C15（44nF）をゲートから切り離し、D12（SMAJ15A）が Q3 の Ciss 2.7nF（max 3.4nF）分だけをクランプする。クランプ電流は 4.5A から 0.58A に下がる（7.8 分の 1）
v3.0.0 | 4_起動波形（旧 2_起動波形） | TP5 の意味が変わったことを明記。4-3（Vgs 終値）を独立項目に分離 | R51 が IC3.GATE と Q3 ゲートの間に入ったため、TP5 は /Gate_HV_1（R51 の下流＝真の Q3 ゲート）になった。C9 / C15 は Net-(IC3-GATE) 側。TP5 − TP10 が真の Vgs で、v2.1.1 より測定点として適切
v3.0.0 | 7_熱特性（旧 3_熱特性） | 銅箔の熱抵抗（Q1 26.1 / Q2 25.9 / Q3 23.9 / R11 27.3 K/W）と損失予測の表を追加。Q3 の温度を独立項目に分離。TH2 / IC6 / IC4 の温度を追加 | 基板図の実形状から熱抵抗を数値解析し、判定基準を「記録のみ」から定量値に置き換えた。Q3 は全電流を単独で流すため Q1 / Q2 より条件が厳しい
v3.0.0 | 7_熱特性 | R5 の決定表を削除 | R5 / R6 / R9（EN 分圧）が削除されたため
v3.0.0 | 10_GND分離（旧 7_GND分離） | テストポイントと島の対応表を追加。10-4 / 10-5 / 10-7 を追加 | v3.0.0 では ADC の基準電位が一点接続に乗るため重要度が上がった。10-7（ストール中の ADC 読み）が分離の実効性を最終判定する
v3.0.0 | 9_走行時総合（旧 6_走行時総合） | 9-8 / 9-9（Vout / GND 経路の電圧降下）と 9-10〜9-12（ADC 精度・チョッパ積算）を追加 | 経路抵抗の解析値（Vout 1.024mΩ / GND 0.975mΩ）の裏取り。★ R70 追加後は Vout 側を再解析すること
v3.0.0 | 0_通電前確認 | 0-2（JP1）/ 0-6 / 0-7（3.3V）/ 0-10〜0-16（R51・D12・D11・EN 系）/ 0-22〜0-24（J6・NTC）を追加 | 追加部品の実装確認。特に 0-10 / 0-11 が欠けていると出力短絡で Q3 が再び破壊される
v3.0.0 | J6 / THT 実装 | J6（SWD ヘッダ）を PCBA の実装対象に追加。XFCN PZ254V-11-05P（LCSC C492404）を選定。2-1 を「実装作業」から「実装確認」に変更 | 当初は手はんだの予定だったが、初回試験でファームウェア書き込みの頻度が高いため工場実装とした。BOOMELE C2337 は 1×40 の連結品で PCBA では折って使えないため、1×5 単体品に変更。基板の穴径 1.0mm・パッド 1.7mm・ピッチ 2.54mm に対し 0.64mm 角ピンで標準の勘合
v3.0.0 | 11_外部スイッチ・LED | 11-4（接点電流）と 11-10（EN_FB 読み戻し）を追加 | 接点電流が 1.06mA から 1.22mA に変わった。EN_FB は PA8 で読み戻してスイッチ状態検出と STOP 復帰に使う
v3.0.0 | Q1 / Q2 / Q3 | CSD18540Q5B（TI、LCSC C86513）→ BSC028N06NS（Infineon、LCSC C148250）に変更。4-7 の期待容量を 48 → 46.7nF、7_熱特性 の予測表、6_Q3ゲート保護 の注記、4-6 の TIMER 判定を再計算 | TI 品が LCSC で在庫 0（2026-10-14 確認）。一度 onsemi NTMFS5C628NLT1G（C145537）を選定したが、SO-8FL のランドパターンが基板の TDSON-8-1 と合わず JLCPCB のプレビューで部品が正しく載らなかったため撤回。Infineon PG-TDSON-8 は KiCad の TDSON-8-1 が元にしているパッケージそのもので幾何学的に一致する。Rds_on 2.5 typ / 2.8 max mΩ、Ciss 2700pF typ（3 品種で最小）、Qg 37nC typ（同）、Vgs ±20V。Tj max は 150℃ と 25℃ 下がるが、TH1 がケース温度を読みファーム #4 が T_hard 115℃ で遮断するため到達しない。★ 露出パッドがソースの BSC028N06NSSC（C534317）は別品種なので使用しない。★ Vgs(th) が 2.8V typ / 3.3V max に上がり、LM5060 の I_TIMERL / I_TIMERH 分岐（5V）までの余裕が 3V → 約 1V に減るため 4-6 で傾きを確認すること
v3.0.0 | 12_量産工程 / 13_量産記録（新規） | 300 枚ロットの量産工程を 2 シート追加。全数は短縮版 7 項目（P-1〜P-7）、抜取りは初期流動 5 枚（レベル A）＋ 30 枚ごとに 1 枚（レベル B、計 10 枚）の 15 枚 | 量産では J6 を未実装とし、スルーホールにポゴピンを当てて書き込む。給電は J1 から 24V を入れて IC4 経由とすることで、3.3V 降圧も同時に検証できる。★P-4（未書込みで Vout が出ないこと）と ★P-7（非常停止）はフェイルセーフの全数検証で、NG なら出荷禁止。ライタは STLINK-V3MINIE（ターゲット給電機能なし）、読み出し保護は RDP Level 1（Level 2 は不可逆のため不採用）。工数は全数 8.5h ＋ 抜取り 8.3h ≒ 17 時間
v2.3 → v3.0.0 | 基板バージョン | 設計仕様書は v2.3 として作成したが、基板・試験仕様書は v3.0.0 とする | マイコン保護化・3.3V 電源の新設・EN 方式の変更・R51 / D12 の追加と、v2.1.1 からの差分が大きいため
設計（ハードウェア）の変更内容
区分 | 対象 | 内容 | 理由
追加 | IC4 + 周辺 | LMR16006XDDCR による VBUS → 3.3V 降圧（0.7MHz、ECO 28µA） | マイコン電源。VBUS 側（Q3 の前）から取る
追加 | IC6 + 周辺 | STM32C011F4P6（TSSOP-20） | 保護制御。ADC で TH1 / TH2 / VBUS / Vout / チョッパを監視
追加 | Q6 / R42 / R48 / C20 / JP1 | BSS138 による EN 引き下げ（フェイルセーフ） | マイコン死亡時に約 93ms で自動遮断。JP1 はブリングアップ用の強制 OFF
追加 | TH2 | R11 近傍に 2 個目の NTC（R11 から 5mm 離す） | PPTC 撤去後 R11 の過熱保護が無いため
追加 | J5 / J6 | 拡張端子（JST XA 6極）/ SWD パッド（1×5 THT） | v2.4 以降の外部センサー対応と書き込み。★ 2026-10-14 以降に J7（電流センス出力・JST GH 3極 SMD）/ J8（VBUS_AUX 出力・JST VH 2極 垂直）/ F4（2A 63V ヒューズ）を追加
追加 | R51 / D12 | Q3 のゲート保護（100Ω 直列 ＋ SMAJ15A） | 2026-10-08、出力短絡で Q3 のゲート酸化膜が破壊された
追加 | R50 | +3V3 → NRST の 10kΩ（条件付き） | J6 が MCU から離れ MCU_NRST の配線が伸びる場合のみ
削除 | R5 / R6 / R9 | EN 分圧を構成していた抵抗 | EN 分圧方式を廃止
移設 | TH1 | EN 分圧から MCU の ADC へ。配置は v2.1.1 のまま（Q1〜Q3 の各ドレインパッドから約 1mm） | 遮断点をファームで決めるため
変更 | D8 | BZT52C3V9（3.9V ツェナー）→ PESD5V0S1UL（5V ESD） | EN 絶対最大は 75V。役割がクランプから ESD 保護に変わる
変更 | C34 | 100nF → 1nF | マイコンによる高速短絡検出（応答 2ms）のため。100nF では分圧の時定数が 9.1ms になり間に合わない
変更 | C27 | 1206 → 1210（2.2µF / 100V X7R、PSA FS32X225K101EGG） | 100V X7R の 2.2µF は 1210 でないと入手性が悪い。基板図を修正済み
変更 | C31 / C32 | 100V 指定 → 50V 品 | +3V3 系のデカップリングで 100V は不要。回路図のテキストを修正
変更 | J4 | 端子の機能のみ変更（pin3 / pin4 が 3.3V 系ロジックに） | ハーネスとスイッチはそのまま流用可
変更なし | C16 | 0.15µF のまま据え置き（TIMER 合計 0.48µF） | 0.66µF に増やすと短絡時の遮断が 106 → 145ms に悪化する。起動余裕より短絡応答を優先
変更なし | IC1 / IC2 / IC3 / Q1〜Q5 / R2・R3・R4 / チョッパ一式 / F3 / LED1 | — | 実測で正常を確認済み
採用（v3.0.0 実装済み） | 電流検出（計測用） | R70 0.5mΩ シャント ＋ U3 INA240A2PW（ゲイン 50V/V）＋ IC5 TLV9001（VBUS 分圧バッファ）。出力は J7（JST GH 3極）へ | ★ 2026-10-14 以降に追加。µs 遮断には使わず、外部計測・テレメトリ専用。マイコンには取り込まない（R73 DNP）。Q1 / Q2 が同じ容量放電電流に耐えたため高速遮断は不要という判断は維持
追加 | R70 / R74 / R75 / C64 / U3 / R77 / C67 | 電流検出：0.5mΩ シャント（2512 3W）＋ 0Ω ケルビン ＋ INA240A2PW（50V/V）＋ 1kΩ/1µF 出力フィルタ | 2026-10-14 以降に追加。25mV/A。C64 は DNP（R74 / R75 が 0Ω のため無効）
追加 | IC5 / R71 / R72 / R76 / C66 / C68 / C65 / NT1 / J7 | VBUS 分圧（1MΩ / 57.6kΩ）＋ TLV9001 バッファ ＋ JST GH 3極出力。アナログ島はネットタイ NT1 一点で GND に接続 | 2026-10-14 以降に追加。1.601V @ VBUS 29.4V（18.36 V/V）。+3V3 の消費が 1.9mA 増える
追加 | F4 / J8 / R54 / C36 / C69 / R73(DNP) | VBUS_AUX（2A 63V ヒューズ経由、B2P-VH 垂直）/ EXT_GPIO の 100Ω 直列 / EXT_ADC1 のフィルタ | 2026-10-14 以降に追加・変更。R73 を DNP にしたため EXT_ADC1 に I_SENSE は来ない
v2.1.1 → v3.0.0 試験番号の対応
v2.1.1 | 項目 | v3.0.0 | 備考
0_通電前確認 0-1〜0-6 | 目視・短絡・導通・ビア | 0_通電前確認 0-1 / 0-3〜0-5 / 0-8 / 0-9 | 0-2（JP1）/ 0-6 / 0-7（3.3V）を挿入したため番号がずれる
0-7 / 0-8 | VREF バイアス経路 / 分圧ノードの分離 | 0-18 / 0-19 | 内容は同一
0-9 | F3 の導通 | 0-20 | 同一
0-10 | J4 のピン配置 | 0-21 | 繋がるネットが 3.3V 系ロジックに変わった
0-11 | Q4 ゲートプルダウン | 0-17 | 同一
1_低電圧基本動作 1-1〜1-5 | UVLO / OVP / 非常停止 | 3_低電圧基本動作 3-1〜3-5 | 同一
1-6 | EN 電圧 | 3-7 | ★ 設計値が 3.9V → 2.68V に変更
1-7 | LED1 点灯 | 3-9 | 同一
1-8 | 待機電流 | 3-10 | ★ 設計値が 60µA → 203µA → 約460µA に変更（U3 / IC5 の追加により再計算）
2_起動波形 2-1〜2-5 | 入力容量 / ゲート / Vout / 突入 / TIMER | 4_起動波形 4-1 / 4-2 / 4-4 / 4-5 / 4-6 | 4-3（Vgs 終値）と 4-7（TP5−TP2 容量）を独立項目として追加
3_熱特性 3-1〜3-3 | 周囲温度 / Q1 / TH1（通常走行） | 7_熱特性 7-1 / 7-2 / 7-4 | 7-3（Q3 温度）を追加
3-4〜3-7 | ストール時 Q1 / TH1 / 電流 / 遮断時間 | 7-5 / 7-7 / 7-8 / 7-9 | 7-6（ストール時 Q3）を追加
3-8〜3-10 | R11 / TH1 / C7（チョッパ連続導通） | 7-10 / 7-12 / 7-14 | 7-11（TH2）と 7-13（TH2 の応答遅れ）を追加
3_熱特性 の R5 決定表 | — | 削除 | R5 が削除されたため
4_保護機能 4-1〜4-6 | 遮断 / 復帰 / EN 電圧 | 5_保護機能（マイコン）5-1〜5-4 | ★ 判定が EN 電圧から温度に変更。4-2 / 4-4 / 4-6（EN 電圧）は項目ごと消滅
4-7 / 4-8 | ホットスワップ / 逆流阻止 | 9_走行時総合 9-5 とあわせて実施 | パック 2 個が必要なためフェーズ 8 に移動
4-9 | OCP（任意） | 削除 | ファームウェア #8 / #13 で代替（5-10 / 5-11）
5_ブレーキチョッパ 5-1〜5-12 | チョッパ一式 | 8_ブレーキチョッパ 8-1〜8-12 | 内容は同一。8-13 / 8-14（CHOP_SENSE）を追加
6_走行時総合 6-1〜6-7 | 走行時一式 | 9_走行時総合 9-1〜9-7 | 内容は同一。9-8〜9-12 を追加
7_GND分離 7-1 / 7-2 | TP3 − TP12 | 10_GND分離 10-1 / 10-2 | 10-3〜10-7 を追加
8_外部スイッチ・LED 8-1〜8-8 | スイッチ / LED / F3 | 11_外部スイッチ・LED 11-1〜11-3 / 11-5〜11-9 | 11-4（接点電流）と 11-10（EN_FB）を追加
9_ENしきい値選別 9-1〜9-3 | EN しきい値選別 | 削除 | 遮断点がファームの定数で決まるため不要
（新規） | 3.3V 電源 | 1_3.3V電源 1-1〜1-12 | —
（新規） | MCU 書き込みと基本動作 | 2_MCU書き込みと基本動作 2-1〜2-22 | —
（新規） | Q3 ゲート保護 | 6_Q3ゲート保護 6-1〜6-6 | —
（新規） | ファームウェア保護ロジック | 5_保護機能（マイコン）5-5〜5-16 | 設計仕様書 6_ファームウェア仕様 #4〜#13 に対応
v2.1.1 からの申し送り事項
v2.1.1 の未了項目 | v3.0.0 での扱い
2-5 TIMER 波形（2 号機で未測定） | 4-6 で v3.0.0 基板で測る。2 号機（v2.1.1）でも測っておくと立ち上がり 102ms との対応が取れる
2-3 の立ち上がり 102ms（許容 87ms 超過）の切り分け | 4-7（TP5 − TP2 間容量）を先に測る。60〜65nF なら C9 / C15 が過大、50nF 前後なら IC3 の個体差
3-3 / 3-4 / 3-5（熱特性、1 号機破壊で未了） | 7-2〜7-7 で実施。T_trip / T_hard の確定に必要
6-6 / 6-7（回生プロファイル、未了） | 9-6 / 9-7 で実施。R11 の最終値とファームウェア #6 の閾値の両方を決める
4-2 / 4-4（EN しきい値による遮断・復帰） | 項目ごと消滅。5-2 / 5-4（温度による遮断・復帰）に置き換わった
※ v2.1.1 の 2 号機は破壊せずに保持してあります。v3.0.0 基板では測れない「v2.1.1 のままの状態」（EN 分圧方式、R51 / D12 なし）の比較データが必要になった場合に使えます。
※ 1 号機は 2026-10-08 に出力短絡で Q3 のゲート酸化膜が破壊され使用中止。この事故が R51 / D12 の追加とファームウェア #13 の根拠になっています。
※ 設計仕様書の版数は v2.3 ですが、基板と本試験仕様書は v3.0.0 です。設計仕様書 v3.0.0 では実測検証結果（熱抵抗・経路抵抗）を 7_レイアウト指示 に追記しています。
