sonatine726/MizuniGoal_PowerController_Docs/Mizunigoal_PowerController_R11pasteseg.kicad_pcb

## KiCad design Mizunigoal_PowerController_R11pasteseg.kicad_pcb (2026-10-15)

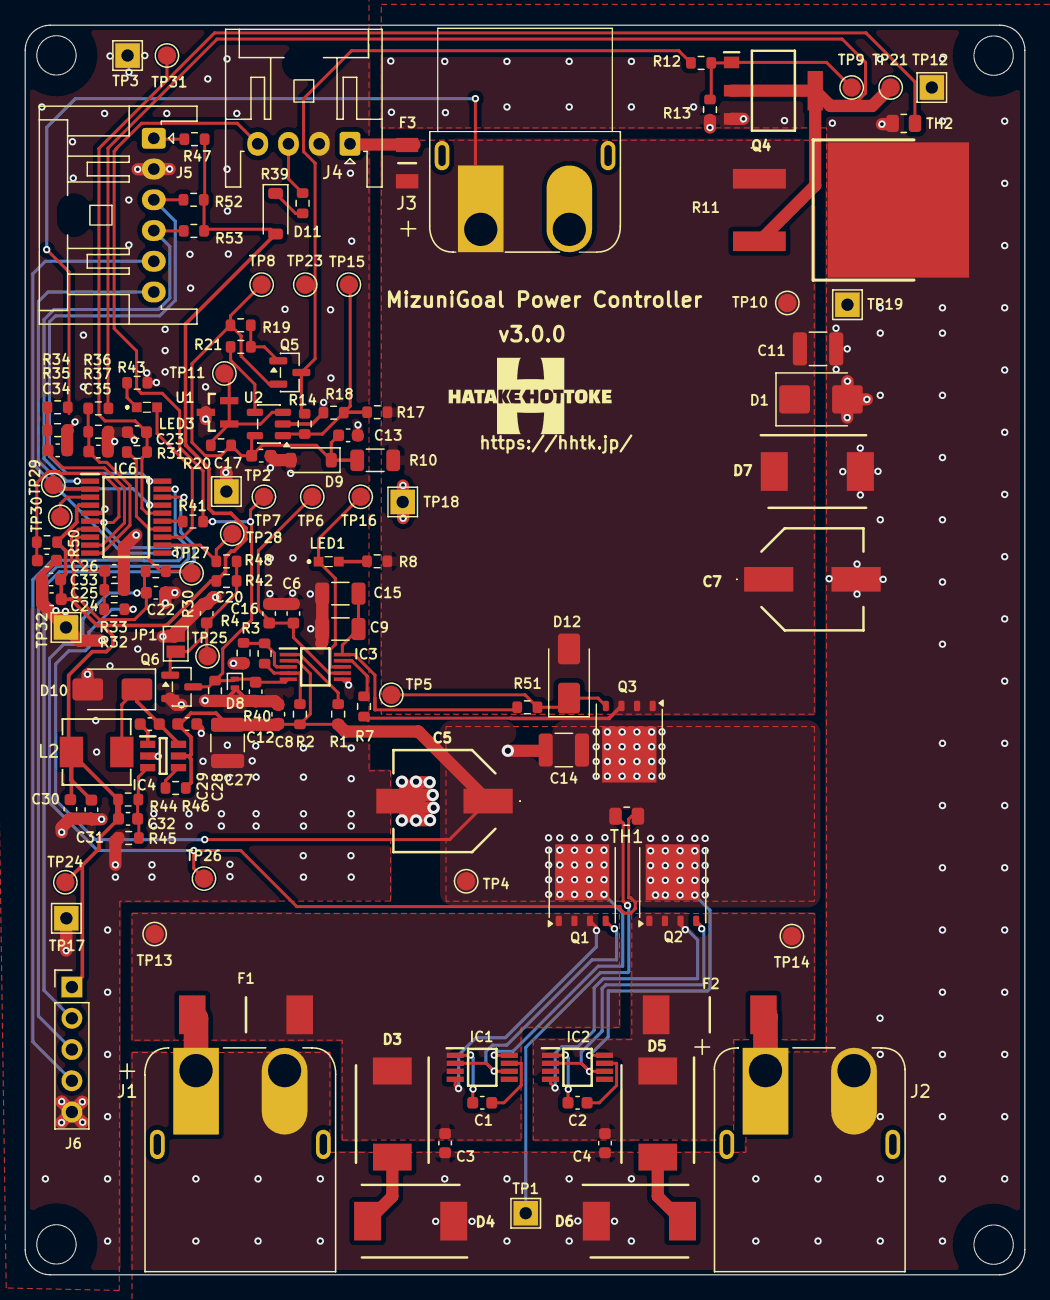
[picture p3: board Mizunigoal_PowerController_R11pasteseg.kicad_pcb from above]

Board: 2 copper layers, 81.3 x 101.6 mm, 142 parts (0 on the bottom side), 62 nets.

Parts:
C1, C2, C13, C17, C24: 1µF; C_0603_1608Metric
C3, C4: 100pF(C0G/100V); C_0603_1608Metric
C5, C7: 47uF(EEH-ZC1H470P); EEHZA1H680P
C6: 0.33uF; C_0603_1608Metric
C8, C28: 100nF(100V); C_0603_1608Metric
C9, C15: 22nF(C0G/100V/1206); C_1206_3216Metric
C11: 1uF(100V/1210); C_1210_3225Metric
C12, C20, C25, C26, C29, C31, C33: 100nF; C_0603_1608Metric
C14: 4.7µF(100V/1210); C_1210_3225Metric
C16: 0.15uF; C_0603_1608Metric
C22, C23: 10nF; C_0603_1608Metric
C27: 2.2µF(100V/1210); C_1210_3225Metric
C30: 22µF(16V); C_0603_1608Metric
C32: 22pF; C_0603_1608Metric
C34, C35: 1nF(C0G); C_0603_1608Metric
D1: ES2D; D_SMB
D3, D5, D7: SMCJ33A; DIOM7959X262N
D4, D6: SMCJ6.0A; DIOM7959X262N
D8: ESD(5V); D_SOD-882
D9: BZT52C12(12V); D_SOD-123
D10: SS210(100V); D_SMA
D11: BAT46W; D_SOD-123
D12: SMAJ15A; D_SMA
F1, F2: 0456030.ER; FUSC10130X305N
F3: 1206L010_60; FUSC3216X125N
H2, H2#2, H2#3, H2#4: MountingHole_3.2mm_M3_with_safearea
IC1, IC2: LM74610QDGKRQ1; SOP65P490X110-8N
IC3: LM5060MM; SOP50P490X110-10N
IC4: LMR16006XDDCR; SOT95P280X110-6N
IC6: STM32C011F4P6; SOP65P640X120-20N
J1: Conn_01x02_Pin; XT60PW-M-Wide
J2: Conn_01x02_Pin; XT60PW-M-Wide_mod_2
J3: Conn_01x02_Pin; XT60PW-F-Wide
J4: Conn_01x04_Pin; JST_XA_S04B-XASK-1_1x04_P2.50mm_Horizontal
J5: Conn_01x06_Pin; JST_XA_S06B-XASK-1_1x06_P2.50mm_Horizontal
J6: Conn_01x05_Pin; PinHeader_1x05_P2.54mm_Vertical
JP1: Jumper_2_Open; SolderJumper-2_P1.3mm_Open_Pad1.0x1.5mm
L2: 33μH; IND-SMD_L5.4-W5.2
LED1, LED3: SML-D13FWT86; SMLD15YWT86
Q1, Q2, Q3: CSD18540Q5B; TDSON-8-1
Q4: FDT3612; SOT230P700X180-4N
Q5: MMBT3906; SOT-23
Q6: BSS138; SOT-23
R1, R12, R18, R19, R41, R50: 10kΩ; R_0603_1608Metric
R2: 200kΩ; R_0603_1608Metric
R3: 5.76kΩ; R_0603_1608Metric
R4: 13.3kΩ; R_0603_1608Metric
R7: 1kΩ; R_0603_1608Metric
R8: 27kΩ; R_0603_1608Metric
R10: 3.3kΩ(1206); R_1206_3216Metric
R11: TPAN0263F200RK9(200Ω); D2PAK_L10.1-W7.8-P5.08-LS15.3
R13, R33, R35, R37, R44, R46: 100kΩ; R_0603_1608Metric
R14, R32, R34, R36, R42: 1MΩ; R_0603_1608Metric
R17: 118kΩ; R_0603_1608Metric
R20: 6.8kΩ; R_0603_1608Metric
R21: 22kΩ; R_0603_1608Metric
R30, R31: 2.0kΩ; R_0603_1608Metric
R39, R48: 220Ω; R_0603_1608Metric
R40, R52, R53: 2.2kΩ; R_0603_1608Metric
R43: 470Ω; R_0603_1608Metric
R45: 30.1kΩ; R_0603_1608Metric
R47: 0Ω; R_0603_1608Metric
R51: 100Ω; R_0603_1608Metric
TH1, TH2: NCP21XV103J03RA(10kΩ); R_0805_2012Metric
TP1, TP2, TP3, TP12, TP17, TP18, TP19, TP32: GND; TestPoint_THTPad_2.0x2.0mm_Drill1.0mm
TP4: VBUS; TestPoint_Pad_D1.5mm
TP5: Q3_Gate; TestPoint_Pad_D1.5mm
TP6: TIMER; TestPoint_Pad_D1.5mm
TP7: EN; TestPoint_Pad_D1.5mm
TP8: 12V; TestPoint_Pad_D1.5mm
TP9: Q4_Gate; TestPoint_Pad_D1.5mm
TP10: Vout; TestPoint_Pad_D1.5mm
TP11: VREF; TestPoint_Pad_D1.5mm
TP13: Battery_1; TestPoint_Pad_D1.5mm
TP14: Battery_2; TestPoint_Pad_D1.5mm
TP15: Chopper_Sense; TestPoint_Pad_D1.5mm
TP16: NPGD; TestPoint_Pad_D1.5mm
TP21: ChopperLoad; TestPoint_Pad_D1.5mm
TP23: Chopper_Sig; TestPoint_Pad_D1.5mm
TP24: +3V3; TestPoint_Pad_D1.5mm
TP25: EN_GATE; TestPoint_Pad_D1.5mm
TP26: TH1_SENSE; TestPoint_Pad_D1.5mm
TP27: NTC_DRV; TestPoint_Pad_D1.5mm
TP28: SHDN_REQ; TestPoint_Pad_D1.5mm
TP29: MCU_SPARE1; TestPoint_Pad_D1.5mm
TP30: MCU_SPARE2; TestPoint_Pad_D1.5mm
TP31: TH2_SENSE; TestPoint_Pad_D1.5mm
U1: TL431BIDBZR; DBZ0003A_N__mod
U2: LM397; SOT-23-5

Connections:
/3.3V Power/+3V3: C24.1, C25.1, C30.1, C31.1, C32.1, D11.2 (A), IC6.4 (VDD/VDDA), J6.1, L2.1, R42.1, R44.2, R47.2, R50.1, R52.1, R53.1, TP24.1 (1_1)
/Battery1_Fused_1: C3.1, D3.1 (K), F1.2, IC1.4 (ANODE), Q1.1 (S), Q1.2 (S), Q1.3 (S), TP13.1 (1_1)
/Battery1_Fused_2: D3.2 (A), D4.2 (A)
/Battery1_Raw: F1.1, J1.1
/Battery2_Fused_1: C4.1, D5.1 (K), F2.2, IC2.4 (ANODE), Q2.1 (S), Q2.2 (S), Q2.3 (S), TP14.1 (1_1)
/Battery2_Fused_2: D5.2 (A), D6.2 (A)
/Battery2_Raw: F2.1, J2.1
/ChopperLoad: Q4.2 (D_1), Q4.4 (D_2), R11.3, R36.2, TP21.1 (1_1)
/Chopper_12V: C13.1, C17.1, D9.1 (K), Q5.2 (E), R10.2, R19.1, R20.1, TP8.1 (1_1), U2.5 (V+)
/Chopper_Sense: R14.2, R17.2, R18.1, TP15.1 (1_1), U2.1 (-)
/Chopper_Sig: Q5.3 (C), R12.2, R14.1, TP23.1 (1_1)
/Chopper_SigBase: Q5.1 (B), R19.2, R21.1
/EN_SWITCH: J4.3, R39.2
/EN_control/EN: C12.1, D8.1 (K), IC3.5 (EN), J4.4, Q6.3 (D), R40.2, R41.1, TP7.1 (1_1)
/EN_control/EN_GATE: C20.1, JP1.2 (B), Q6.1 (G), R42.2, R48.1, TP25.1 (1_1)
/EN_control/EN_control_MCU/CHOP_SENSE: C35.1, IC6.10 (PA3), R36.1, R37.2
/EN_control/EN_control_MCU/EN_FB: IC6.15 (PA8), R41.2
/EN_control/EN_control_MCU/EXT_ADC1: IC6.11 (PA4), J5.5
/EN_control/EN_control_MCU/EXT_GPIO: IC6.17 (PA12[PA10]), J5.6
/EN_control/EN_control_MCU/I2C_SCL: IC6.20 (PB6), J5.3, R52.2
/EN_control/EN_control_MCU/I2C_SDA: IC6.1 (PB7), J5.4, R53.2
/EN_control/EN_control_MCU/MCU_NRST: C26.1, IC6.6 (PF2-NRST), J6.4, R50.2
/EN_control/EN_control_MCU/MCU_SPARE1: IC6.2 (PC14-OSCX_IN), TP29.1 (1_1)
/EN_control/EN_control_MCU/MCU_SPARE2: IC6.3 (PC15-OSCX_OUT), TP30.1 (1_1)
/EN_control/EN_control_MCU/NTC_DRV: IC6.14 (PA7), R30.2, R31.2, TP27.1 (1_1)
/EN_control/EN_control_MCU/SHDN_REQ: IC6.12 (PA5), R48.2, TP28.1 (1_1)
/EN_control/EN_control_MCU/SWCLK: IC6.19 (PA14-BOOT0), J6.3
/EN_control/EN_control_MCU/SWDIO: IC6.18 (PA13), J6.2
/EN_control/EN_control_MCU/TH1_SENSE: C22.1, IC6.7 (PA0), R30.1, TH1.1, TP26.1 (1_1)
/EN_control/EN_control_MCU/TH2_SENSE: C23.1, IC6.16 (PA11[PA9]), R31.1, TH2.1, TP31.1 (1_1)
/EN_control/EN_control_MCU/VBUS_SENSE: C33.1, IC6.8 (PA1), R32.1, R33.2
/EN_control/EN_control_MCU/VOUT_SENSE: C34.1, IC6.9 (PA2), R34.1, R35.2
/Gate_HV_1: D12.1 (A1), Q3.4 (G), R51.1, TP5.1 (1_1)
/Gate_HV_2: Q4.1 (G), R12.1, R13.1, TP9.1 (1_1)
/IC3_OUT: IC3.9 (OUT), R7.2
/IdealDiode_gate_1: IC1.2 (GATE_PULL_DOWN), IC1.6 (GATE_DRIVE), Q1.4 (G)
/IdealDiode_gate_2: IC2.2 (GATE_PULL_DOWN), IC2.6 (GATE_DRIVE), Q2.4 (G)
/IdealDiode_vcap_1: C1.2, IC1.7 (VCAPH)
/IdealDiode_vcap_2: C1.1, IC1.1 (VCAPL)
/IdealDiode_vcap_3: C2.2, IC2.7 (VCAPH)
/IdealDiode_vcap_4: C2.1, IC2.1 (VCAPL)
/NPGD: IC3.8 (NPGD), LED1.1 (K), TP16.1 (1_1)
/OVP: IC3.3 (OVP), R3.2, R4.1
/SENSE: IC3.1 (SENSE), R1.2
/TIMER: C6.1, C16.1, IC3.7 (TIMER), TP6.1 (1_1)
/UVLO: IC3.4 (UVLO), R2.2, R3.1
/VBUS: C5.1 (+), C8.1, C14.1, C27.1, C28.1, IC1.8 (CATHODE), IC2.8 (CATHODE), IC3.2 (VIN), IC4.5 (VIN), Q1.5 (D), Q2.5 (D), Q3.5 (D), R1.1, R2.1, R32.2, R46.1, TP4.1 (1_1)
/VREF: R20.2, TP11.1 (1_1), U1.1, U1.2, U2.3 (+)
/Vout: C7.1 (+), C11.1, D1.1 (K), D7.1 (K), D12.2 (A2), F3.1, J3.1, Q3.1 (S), Q3.2 (S), Q3.3 (S), R7.1, R8.1, R10.1, R11.1, R17.1, R34.2, TP10.1 (1_1)
/Vout_after_PPTC: F3.2, J4.1
GND: C3.2, C4.2, C5.2 (-), C6.2, C7.2 (-), C8.2, C9.2, C11.2, C12.2, C13.2, C14.2, C15.2, C16.2, C17.2, C20.2, C22.2, C23.2, C24.2, C25.2, C26.2, C27.2, C28.2, C30.2, C31.2, C33.2, C34.2, C35.2, D1.2 (A), D4.1 (K), D6.1 (K), D7.2 (A), D8.2 (A), D9.2 (A), D10.2 (A), IC3.6 (GND), IC4.2 (GND), IC6.5 (VSS/VSSA), J1.2, J2.2, J3.2, J4.2, J5.2, J6.5, JP1.1 (A), Q4.3 (S), Q6.2 (S), R4.2, R11.2, R13.2, R18.2, R33.1, R35.1, R37.1, R40.1, R43.1, R45.1, TH1.2, TH2.2, TP1.1 (1_1), TP2.1 (1_1), TP3.1 (1_1), TP12.1 (1_1), TP17.1 (1_1), TP18.1 (1_1), TP19.1 (1_1), TP32.1 (1_1), U1.3, U2.2 (V-)
unnamed: C29.1, D10.1 (K), IC4.6 (SW), L2.2
unnamed: D11.1 (K), R39.1
unnamed: C9.1, C15.1, IC3.10 (GATE), R51.2
unnamed: C29.2, IC4.1 (CB)
unnamed: C32.2, IC4.3 (FB), R44.1, R45.2
unnamed: IC4.4 (~SHDN), R46.2
unnamed: IC6.13 (PA6), LED3.2 (A)
unnamed: J5.1, R47.1
unnamed: LED1.2 (A), R8.2
unnamed: LED3.1 (K), R43.2
unnamed: R21.2, U2.4
