sonatine726/MizuniGoal_PowerController_Docs/(commit log)

2026-10-10 Update to add new specs
    [rover_harness_bom_plan1_20pin.xlsx, rover_harness_bom_plan2_4p14p.xlsx]
2026-10-12 The harness design has been finalized based on a two-connector configuration using 14-pin and 4-pin connectors.
    [rover_harness_bom_plan2_4p14p.xlsx]
2026-10-15 Add the documents for v3.0.0
    [BOM-Mizunigoal_PowerController_v3_0_0.csv, MizuniGoal_PowerController_v2_1_1_試験記録シート__v12.xlsx, MizuniGoal_PowerController_v2_1_1_試験記録シート__v12__20261008.xlsx, MizuniGoal_PowerController_v3_0_0_設計仕様書.xlsx, MizuniGoal_PowerController_v3_0_0_試験記録シート.xlsx, Mizunigoal_PowerController_R11pasteseg.kicad_pcb]
2026-10-24 Revise documents
    [MizuniGoal_PowerController_v2_2_1_試験記録シート_rev1.xlsx, MizuniGoal_PowerController_v3_0_0_試験記録シート_rev2.xlsx, current_voltage_addition_review.xlsx, rover_harness_bom_plan2_4p14p.xlsx, rover_harness_bom_v1.xlsx]
